finger563/agse2015/design/FRR/pictures/IMAG0127.jpg

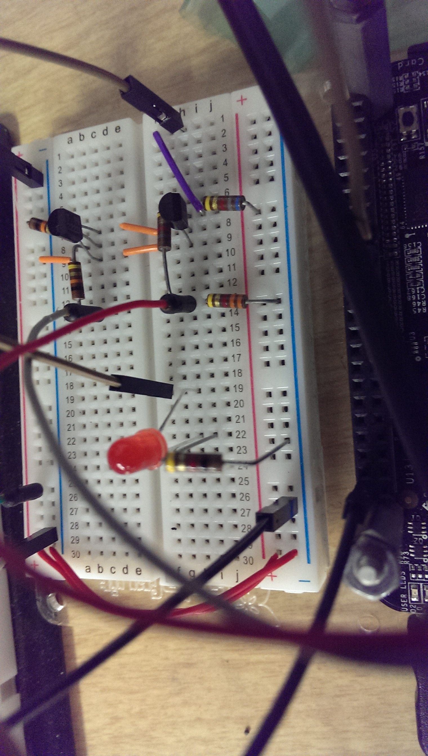
design/FRR/pictures/IMAG0127.jpg
