finger563/agse2015/design/FRR/pictures/pcb_bottom_comparison.png

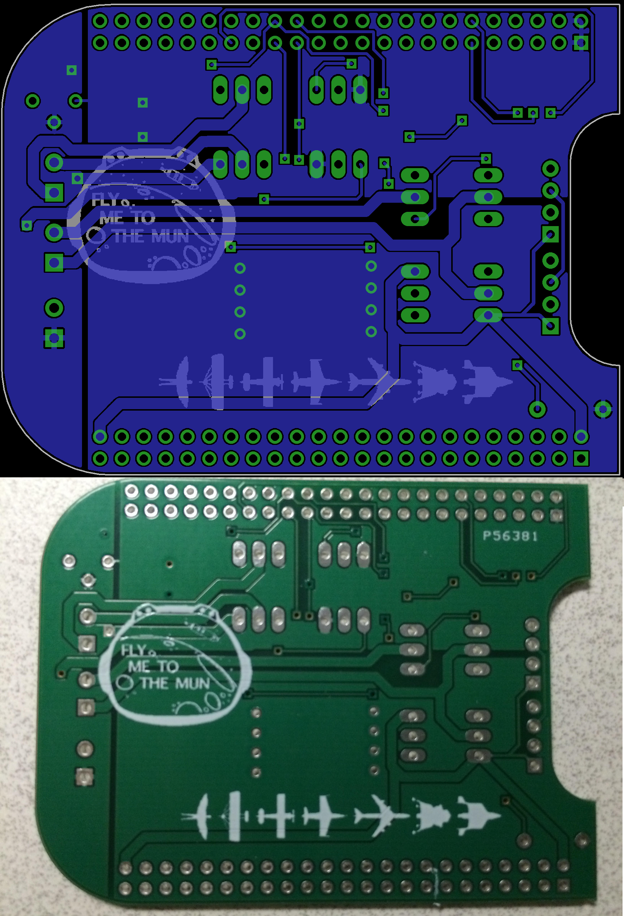
design/FRR/pictures/pcb_bottom_comparison.png
