finger563/agse2015/README.md

View this project on [CADLAB.io](https://cadlab.io/node/972). 

agse2015
========

This repository contains the design and implementation for the AGSE subsystem for the VAC 2015 year.
