finger563/agse2015/design/statechart/agse_design_statechart.pptx

state: ACTIVE

state: Init
The system is performing a checklist of tests to confirm the operational integrity of the sub-system components. Some of these tests are bypassed when resuming from a paused state.

Init_Test_Results = true

state: Scan
Camera feed is processed at a stable sampling rate to identify the payload bay compartment.

state: Retrieve_Sample

Refine_Metrics

state: Plan/Look-ahead/Move
Using the relative position and orientation of the sample, the arm plans a move towards the sample, instructing the motors with relevant signals

state: PickUp
Use the gripper servo to:
- Appropriately orient the gripper relative to sample.
- Pick up sample & verify.

Reached_Sample

state: Close_Bay
Once the sample is dropped, move the arm away from the rocket and trigger the bay-closing circuitry.

state: Open_Bay
Use proximity to open the payload bay, preparing it for sample retrieval.

!Has_Sample && Reached_Bay

Opened_Bay

state: Scan
Camera feed is processed to identify the sample on the ground

Found_Sample

state: Goto_Payload_Bay

state: Plan/Look-ahead/Move
Using the relative position and orientation of the bay, the arm plans a move towards the bay, instructing the motors with relevant signals.

state: POWER_OFF
The system is in the OFF state. There is no current flowing through the circuitry and there are no moving parts.

Refine_Metrics

state: Drop_Sample
Use the gripper servos to orient gripper relative to the payload bay and move to a minimum safe distance. Once a critical distance is reached and detected, drop and secure the sample in bay.

state: PAUSED
The system is in a paused, suspended state. Variables in memory retain consistent state so that the system can readily go to ACTIVE.

Has_Sample

Found_Bay

Has_Sample && Reached_Bay

Dropped_Sample

RESUME

PowerON

PowerOFF

PAUSE

START

PowerOFF

## Slide 2

state: POWER_ON

state: Opened_Bay

state: Init
This is the initialization phase of the payload bay system. This state tests the payload bay electronics and safe, timely operation.

state: Bay_Control_Failure
This is a failure state where either (1) Initializing tests fail or (2) Repeated timeout failures during bay OPEN or CLOSE operations.

Limit_Switch_1_Reached && Timeout_Expiry = false

state: Opening

state: Closing

Timeout_Expiry && Failure_Count >= 100

state: Fully_Open

AGSE_Trigger = CLOSE

Timeout_Expiry && Failure_Count < 100

Timeout_Expiry && Failure_Count < 100

AGSE_Trigger = OPEN

Init_Tests = false

Limit_Switch_2_Reached

state: Closed_Bay
The Payload bay is completely closed. This state is reached when either (1) the sample is retrieved by the AGSE and secured in the bay or (2) the bay is closed after successful initialization.

Init_Tests = true

state: POWER_OFF
The system is in the OFF state. There is no current flowing through the circuitry and there are no moving parts.

PowerOFF

PowerON
