finger563/agse2015/design/powerBoM.xlsx

12V Output DC/DC Converter | http://www.mouser.com/ProductDetail/GE-Critical-Power/EHHD010A0B41-HZ/ | http://www.mouser.com/ProductDetail/GE-Critical-Power/KBVW006A0B41Z/ | http://www.mouser.com/ProductDetail/Delta-Electronics-Power/E48SC12008NRFA/ | http://www.mouser.com/ProductDetail/Murata-Power-Solutions/ULS-12-83-D48N-C/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 | http://www.mouser.com/ProductDetail/Delta-Electronics-Power/E48SH12010NRFA/ | http://www.mouser.com/ProductDetail/Murata-Power-Solutions/UWE-12-10-Q48N-C/ | http://www.mouser.com/ProductDetail/Delta-Electronics-Power/E36SC12009NRFA/
Price | $37.37 | $30.40 | $32.23 | $36.75 | $42.42 | $44.50 | $59.11
5V Output (12V in) DC/DC Converter | http://www.mouser.com/ProductDetail/Delta-Electronics-Power/DNT12S0A0S05NFA/ | http://www.mouser.com/ProductDetail/Delta-Electronics-Power/NE12S0A0V10PNFA/ | http://www.mouser.com/ProductDetail/Delta-Electronics-Power/DNM10S0A0R10NFD/ | http://www.mouser.com/ProductDetail/Maxim-Integrated/MAX16907SAUE-V+/
Price | $8.49 | $11.22 | $12.11 | 6.26
Batteries | http://www.mouser.com/ProductDetail/Power-Sonic/PS-1250F2/ | http://www.mouser.com/ProductDetail/Power-Sonic/PS-1250F1/ | http://www.mouser.com/ProductDetail/Power-Sonic/PSH-1255F2-FR/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
Price | $20.70 | $19.71 | $21.05
Note: | 12V, we'd need 3 probably | 12V, we'd need 3 probably | 12V, we'd need 3 probably
Resettable Fuses | http://www.mouser.com/ProductDetail/Schurter/PFRA500/ | http://www.mouser.com/ProductDetail/TE-Connectivity-Raychem/RGEF500K/ | http://www.mouser.com/ProductDetail/TE-Connectivity-Raychem/RUEF500-2/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
Price | $0.60 | $0.51 | $0.56
ACTUALLY BOUGHT: | 12V DC/DC Converter | Batteries | Wire
 | http://www.mouser.com/ProductDetail/Mean-Well/RSD-100B-12/?qs=sGAEpiMZZMvGsmoEFRKS8P9bZCysYvvSGN8daVBtngg%3d | http://www.mouser.com/ProductDetail/Power-Sonic/PS-12120F2/?qs=sGAEpiMZZMuXcNZ31nzYhWCg8Aa0ccFGvNDs0yXFGmM%3d | http://www.mouser.com/ProductDetail/Alpha-Wire/6459-OR005/
 |  |  | http://www.mouser.com/ProductDetail/Alpha-Wire/6459-OR005/
