finger563/agse2015/code/agse_rosmod_v3/agse_emacs.png

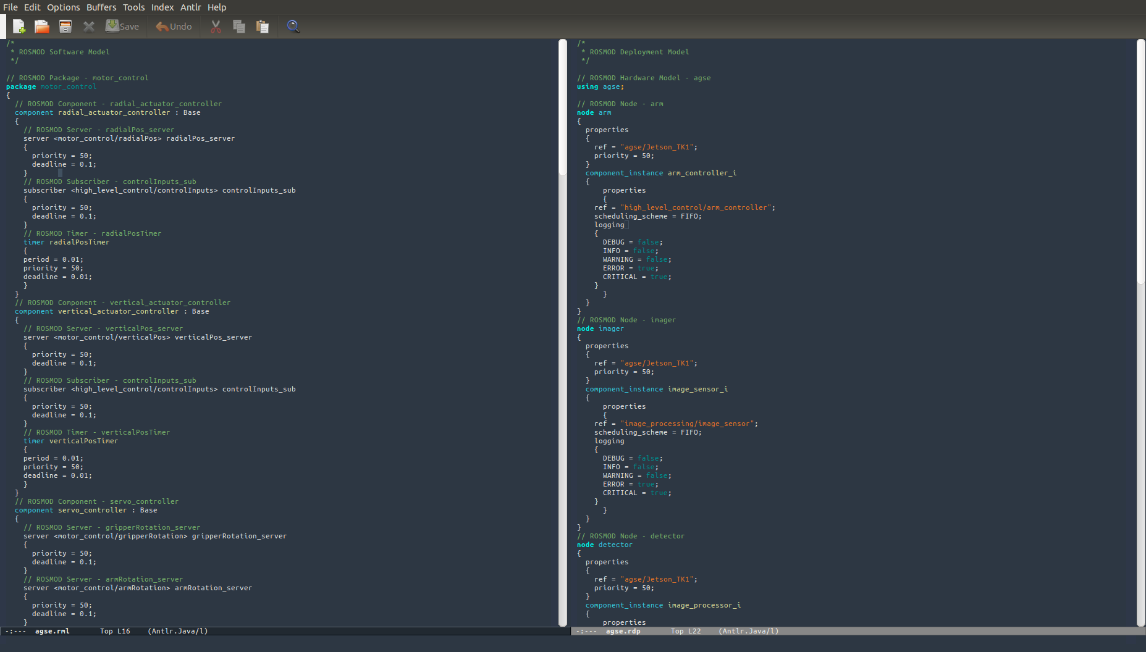
code/agse_rosmod_v3/agse_emacs.png
