finger563/agse2015/code/agse_rosmod_v3/deployment.png

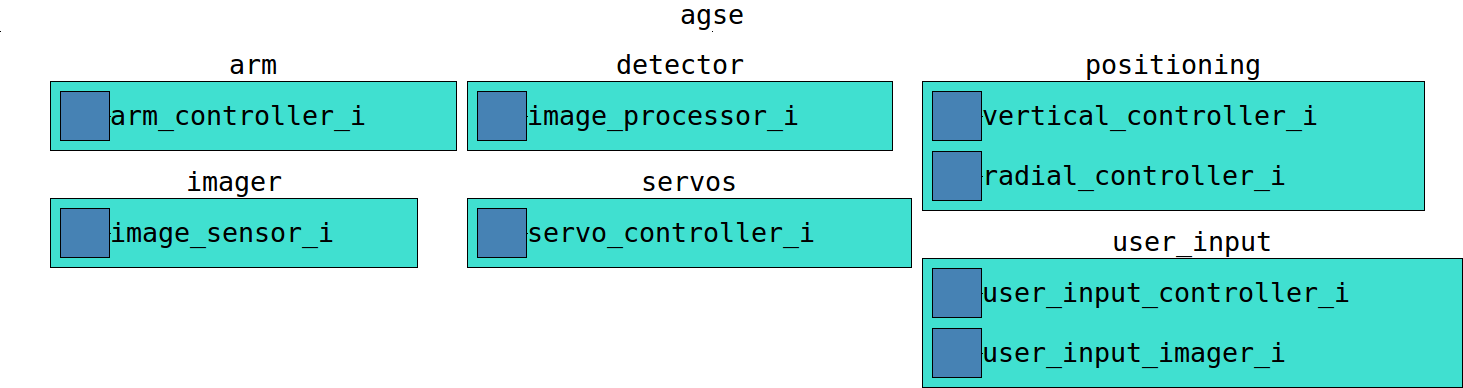
code/agse_rosmod_v3/deployment.png
