finger563/agse2015/code/agse_rosmod_v3/high_level_control_tree.png

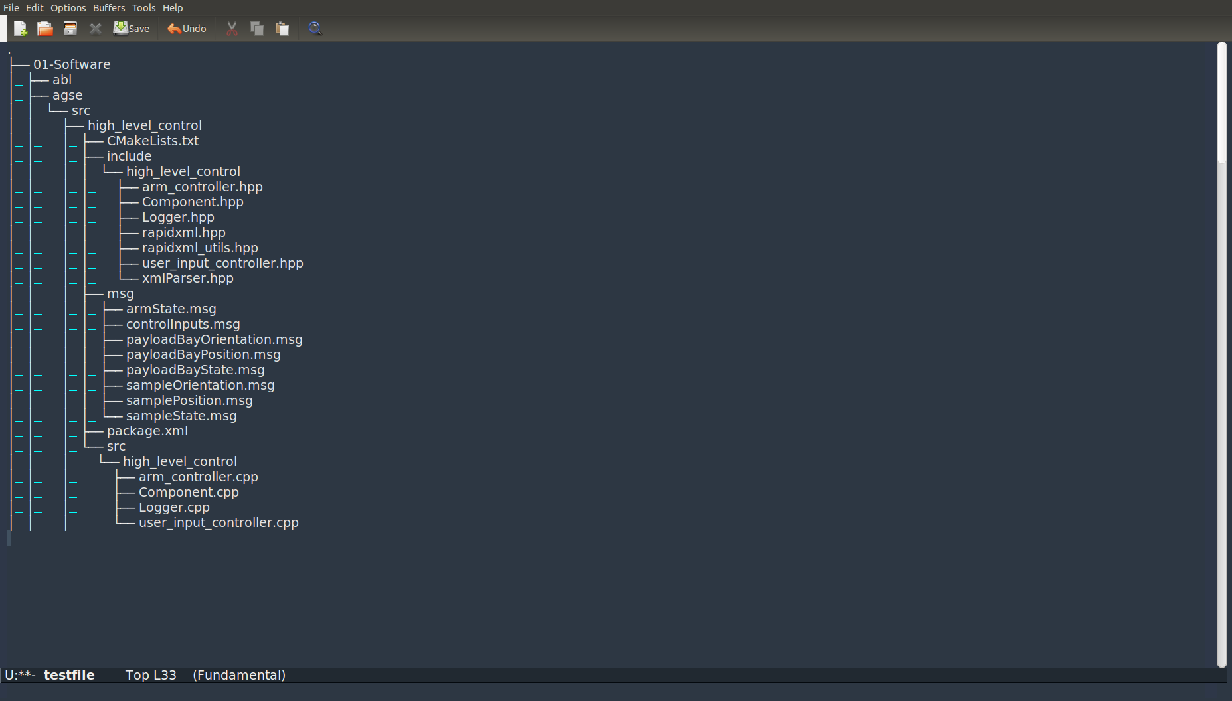
code/agse_rosmod_v3/high_level_control_tree.png
