finger563/agse2015/code/agse_rosmod_v3/image_processing_pacakge.png

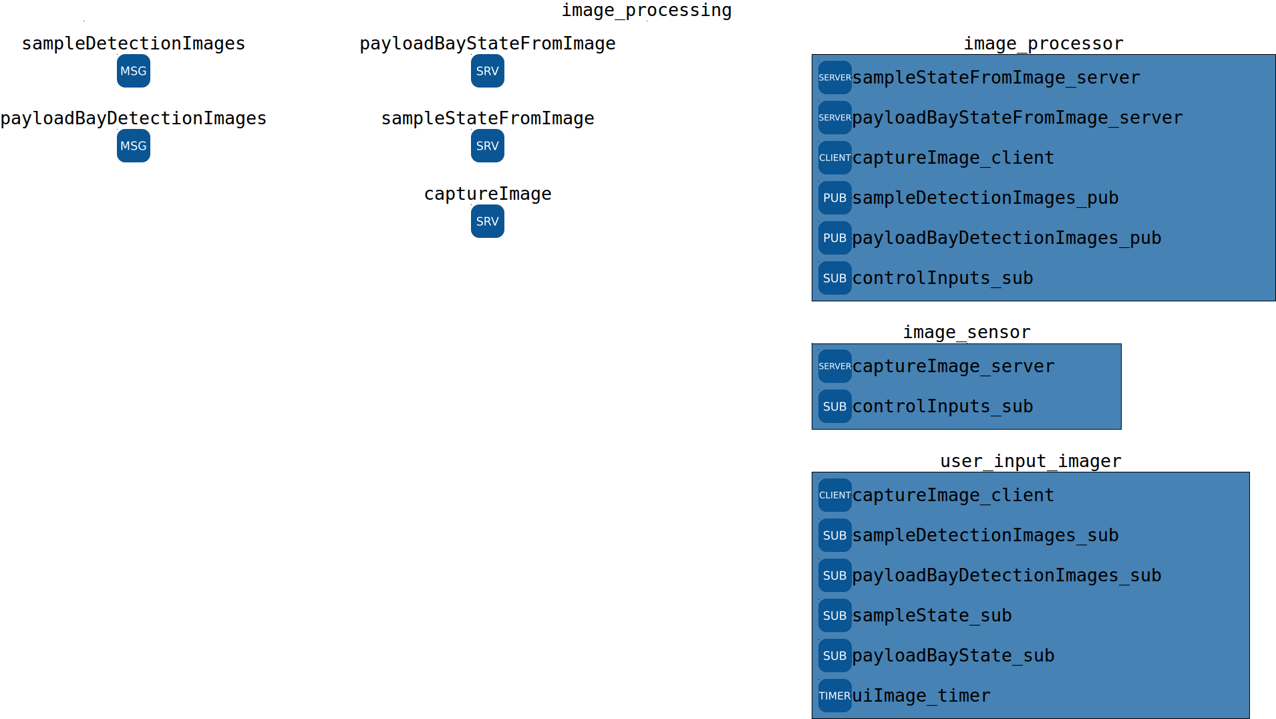
code/agse_rosmod_v3/image_processing_pacakge.png
