finger563/agse2015/code/agse_rosmod_v3/motor_control_pacakge.png

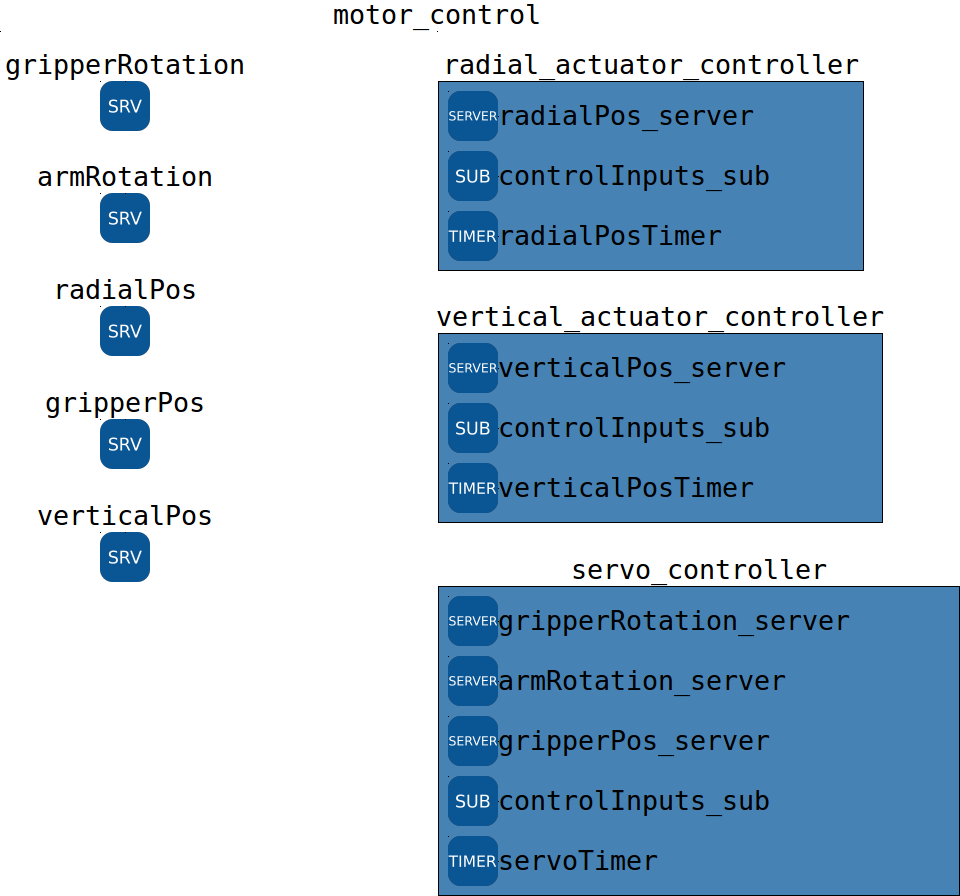
code/agse_rosmod_v3/motor_control_pacakge.png
