finger563/agse2015/code/agse_rosmod_v3/rosmod_editor.png

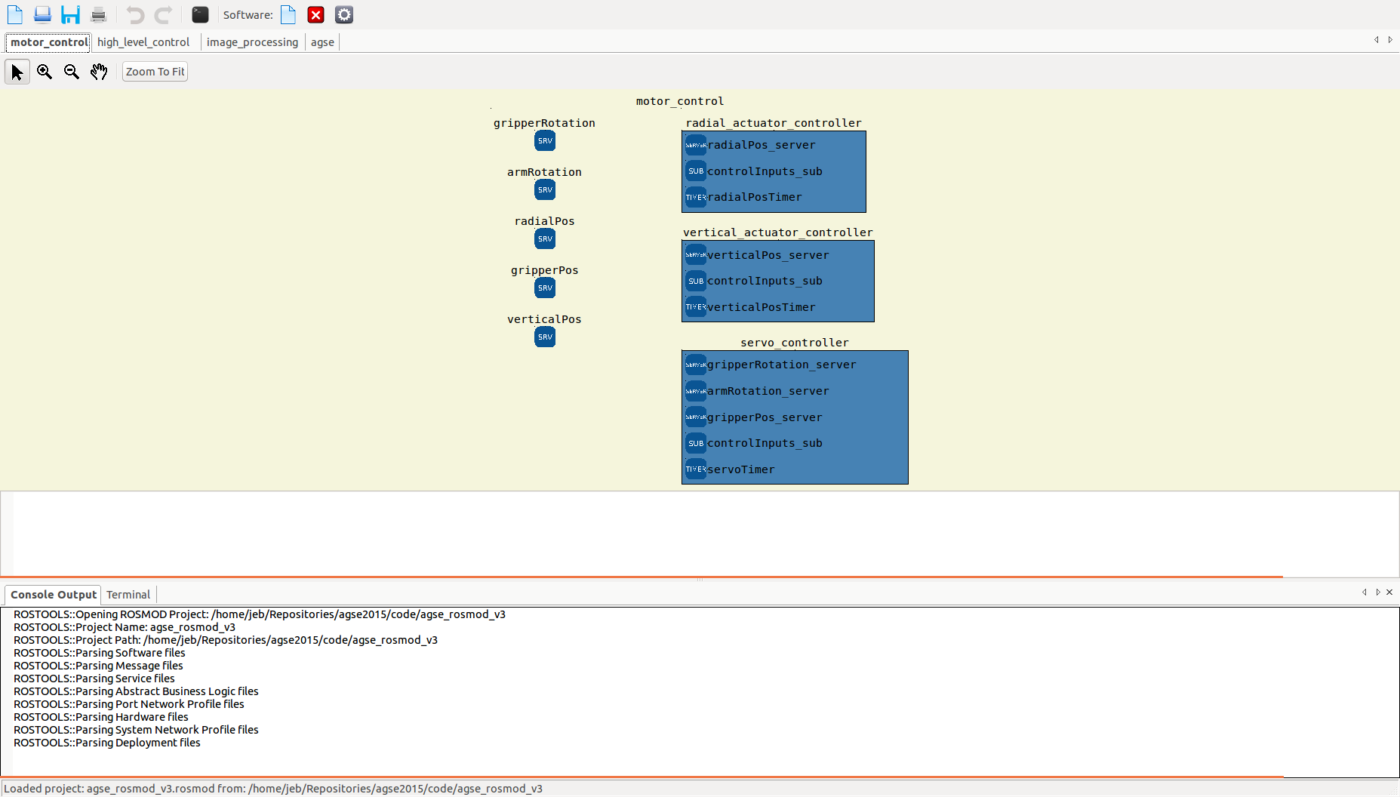
code/agse_rosmod_v3/rosmod_editor.png
