finger563/agse2015/code/agse_rosmod_v3/tree.png

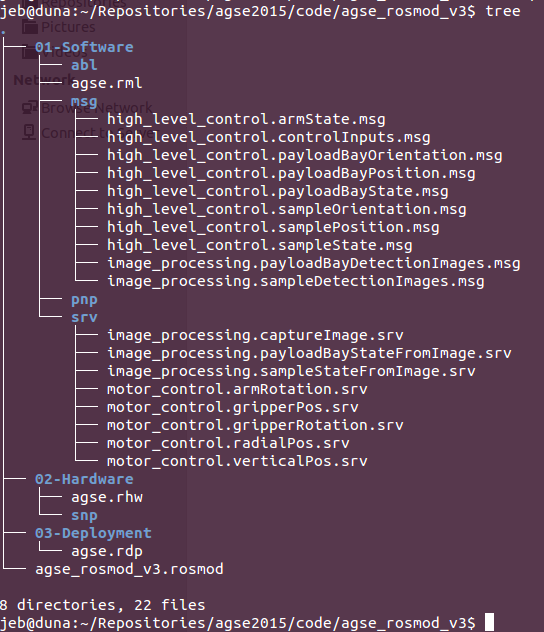
code/agse_rosmod_v3/tree.png
