finger563/agse2015/code/UIP/input/01.png

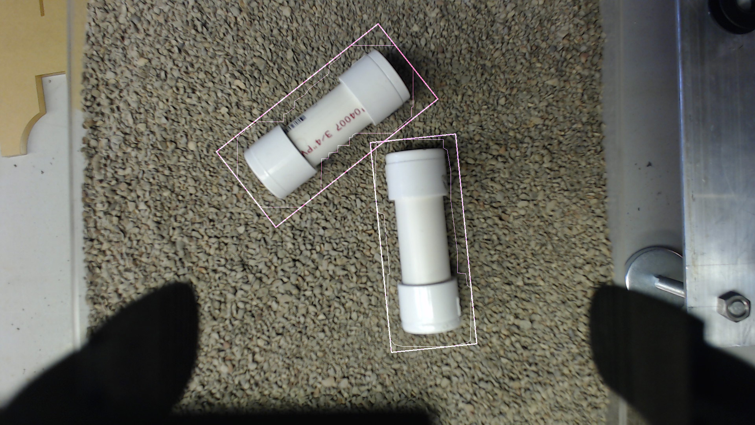
code/UIP/input/01.png
