finger563/agse2015/code/UIP/input/03.png

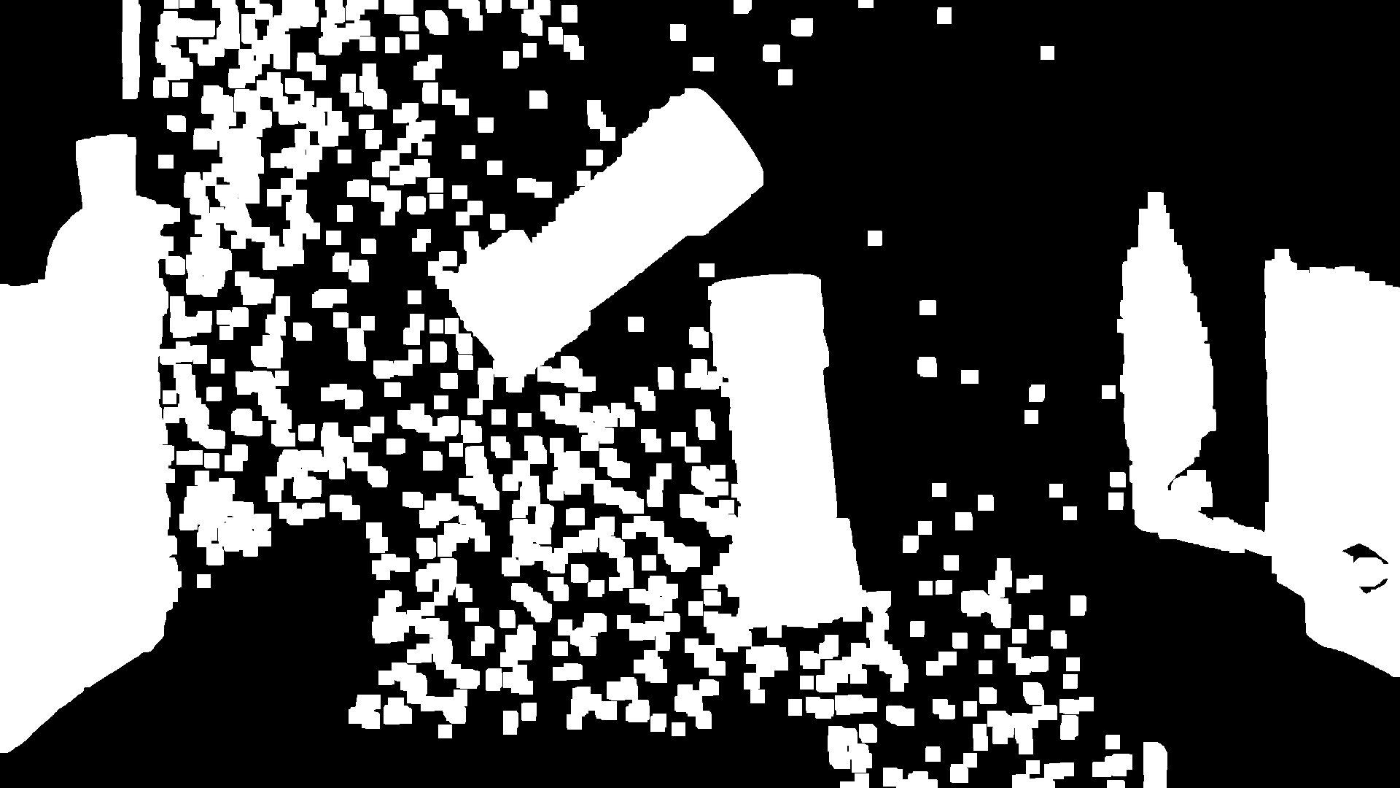
code/UIP/input/03.png
