finger563/agse2015/code/UIP/input/m4.png

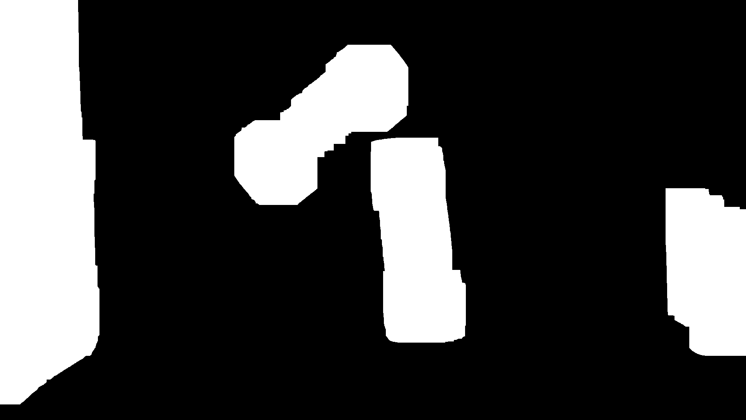
code/UIP/input/m4.png
