finger563/agse2015/design/FRR/BBBCape/IMAG0193.jpg

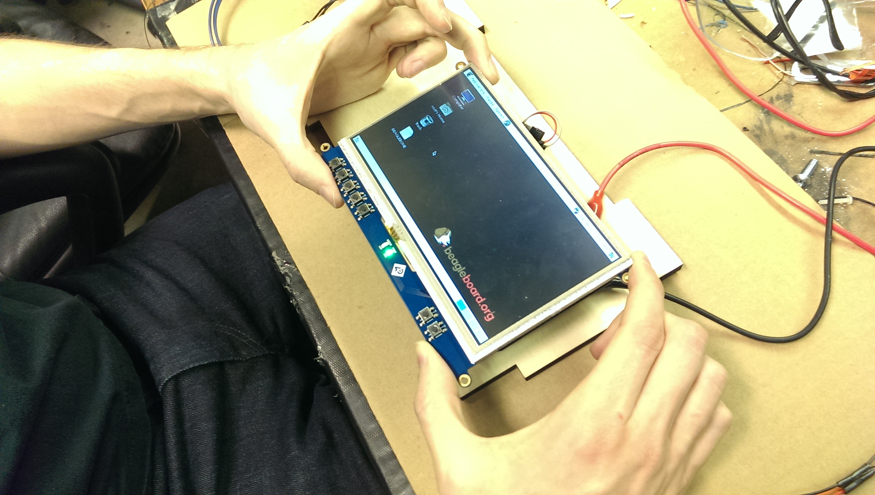
design/FRR/BBBCape/IMAG0193.jpg
