finger563/agse2015/design/FRR/BBBCape/IMAG0194.jpg

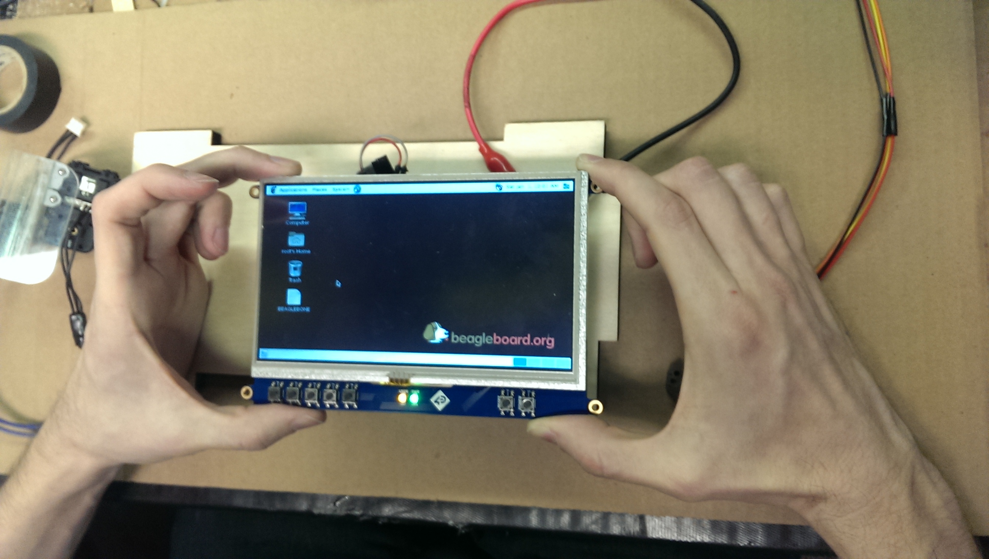
design/FRR/BBBCape/IMAG0194.jpg
