finger563/agse2015/design/FRR/BBBCape/IMAG0195.jpg

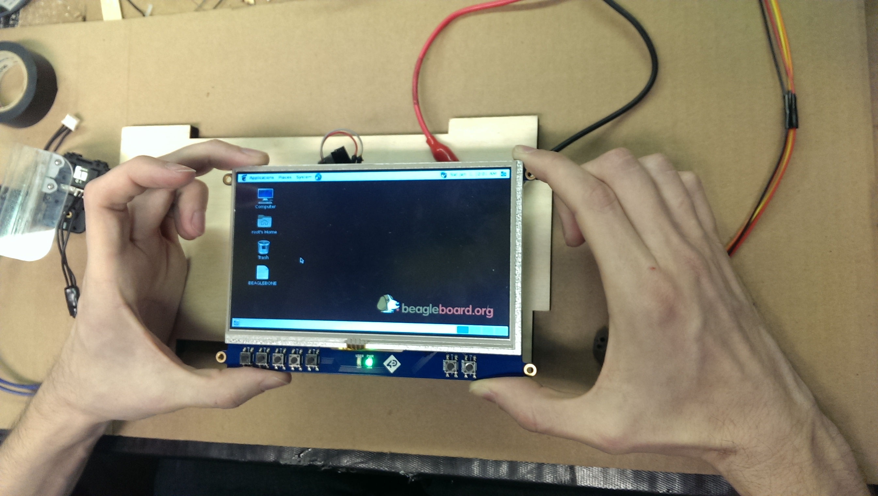
design/FRR/BBBCape/IMAG0195.jpg
