finger563/agse2015/design/FRR/BBBCape/IMAG0196.jpg

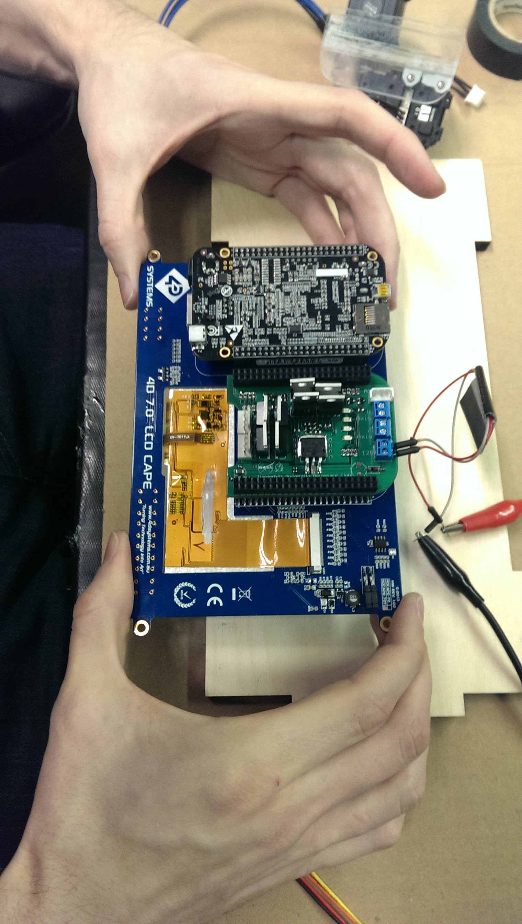
design/FRR/BBBCape/IMAG0196.jpg
