finger563/agse2015/design/FRR/BBBCape/IMAG0197.jpg

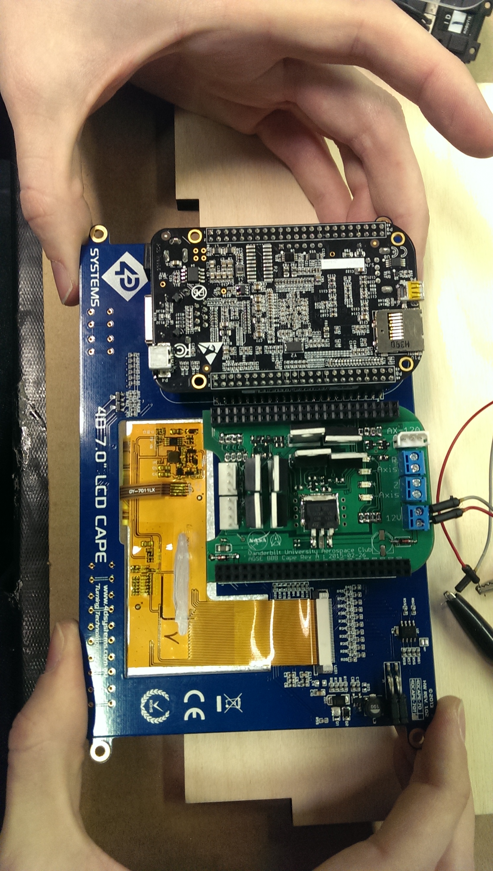
design/FRR/BBBCape/IMAG0197.jpg
