finger563/agse2015/design/FRR/BBBCape/IMAG0198.jpg

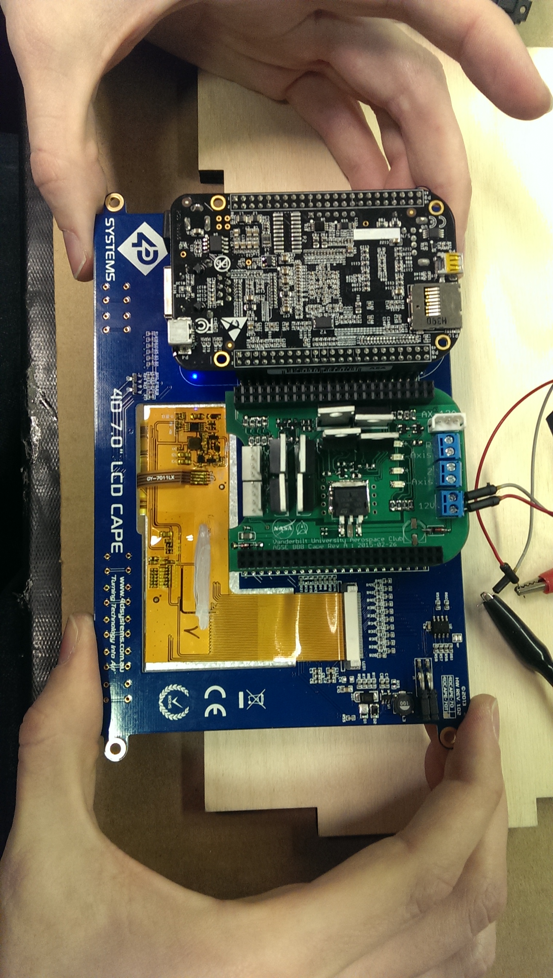
design/FRR/BBBCape/IMAG0198.jpg
