finger563/agse2015/design/FRR/MBA-Demo-SampleDetection/Sample-01-Raw.png

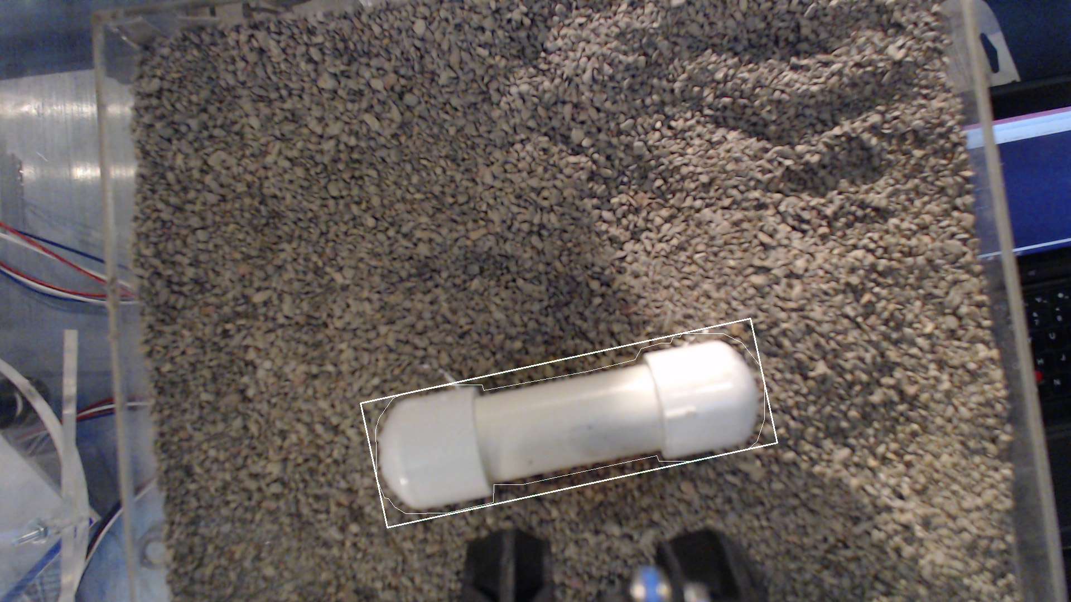
design/FRR/MBA-Demo-SampleDetection/Sample-01-Raw.png
