finger563/agse2015/design/FRR/MBA-Demo-SampleDetection/Sample-05-Grayscale-Threshold.png

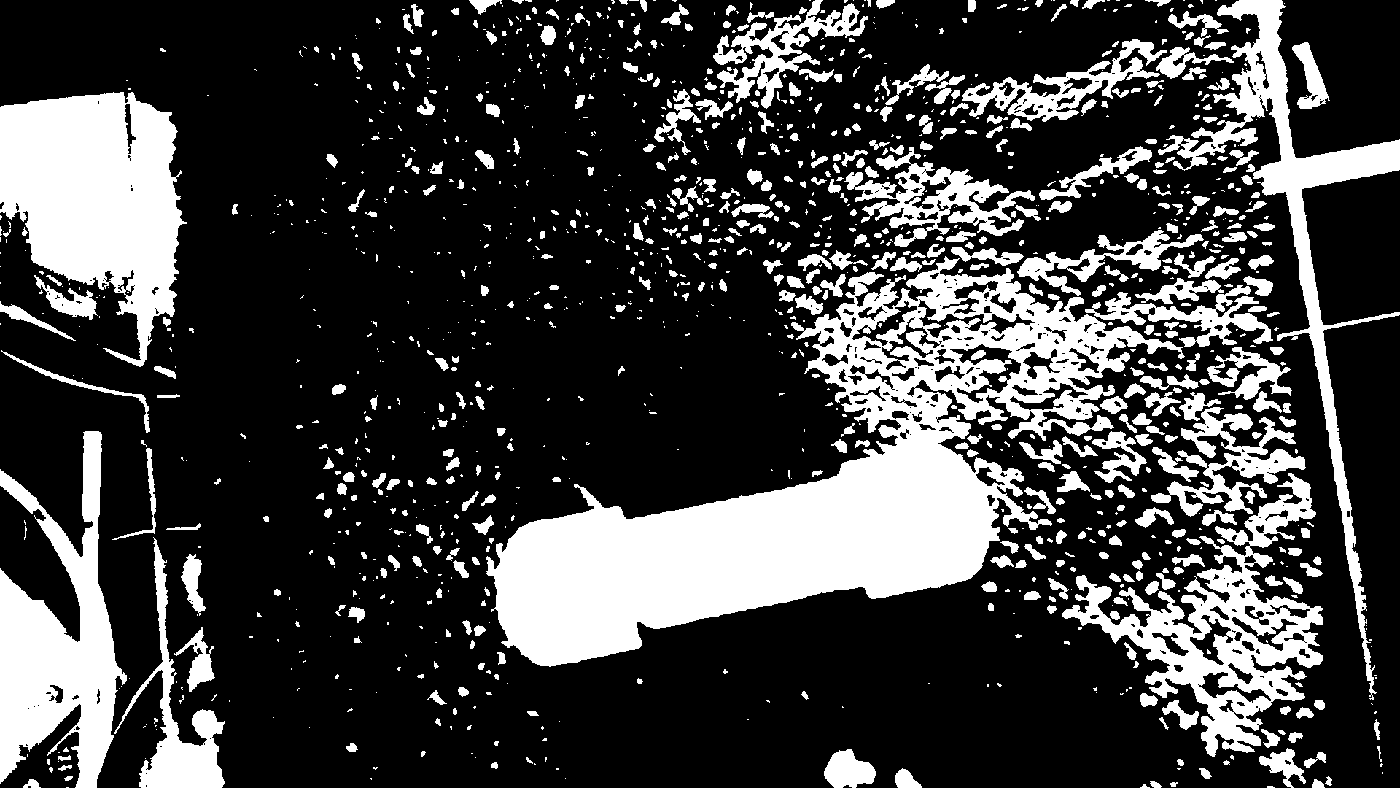
design/FRR/MBA-Demo-SampleDetection/Sample-05-Grayscale-Threshold.png
