finger563/agse2015/design/FRR/MBA-Demo-SampleDetection/Sample-06-Grayscale-Filtered.png

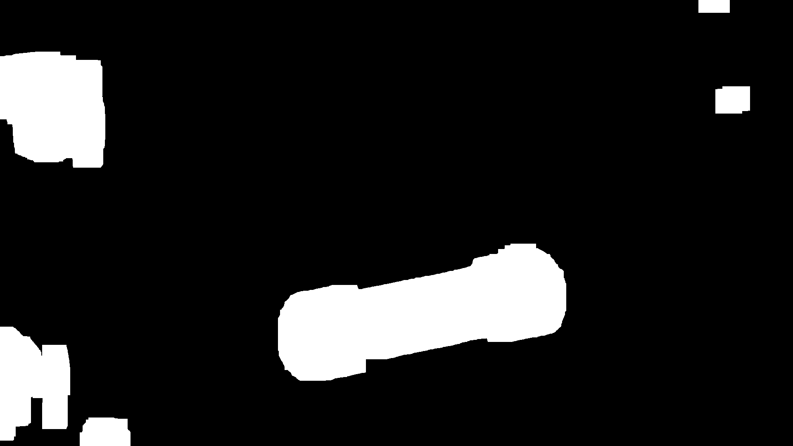
design/FRR/MBA-Demo-SampleDetection/Sample-06-Grayscale-Filtered.png
