finger563/agse2015/design/FRR/MBA-Demo-SampleDetection/Sample-08-Bitwise-AND-Tracked.png

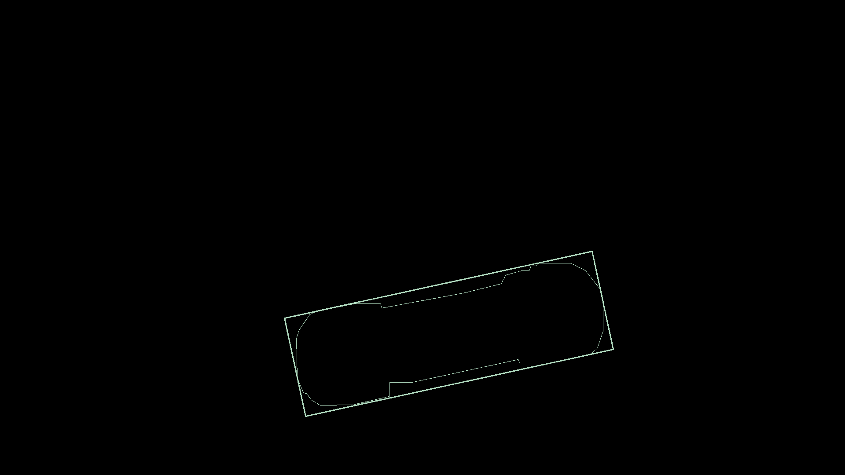
design/FRR/MBA-Demo-SampleDetection/Sample-08-Bitwise-AND-Tracked.png
