finger563/agse2015/design/FRR/MBA-Demo-SampleDetection/Sample-YCrCb-Threshold.png

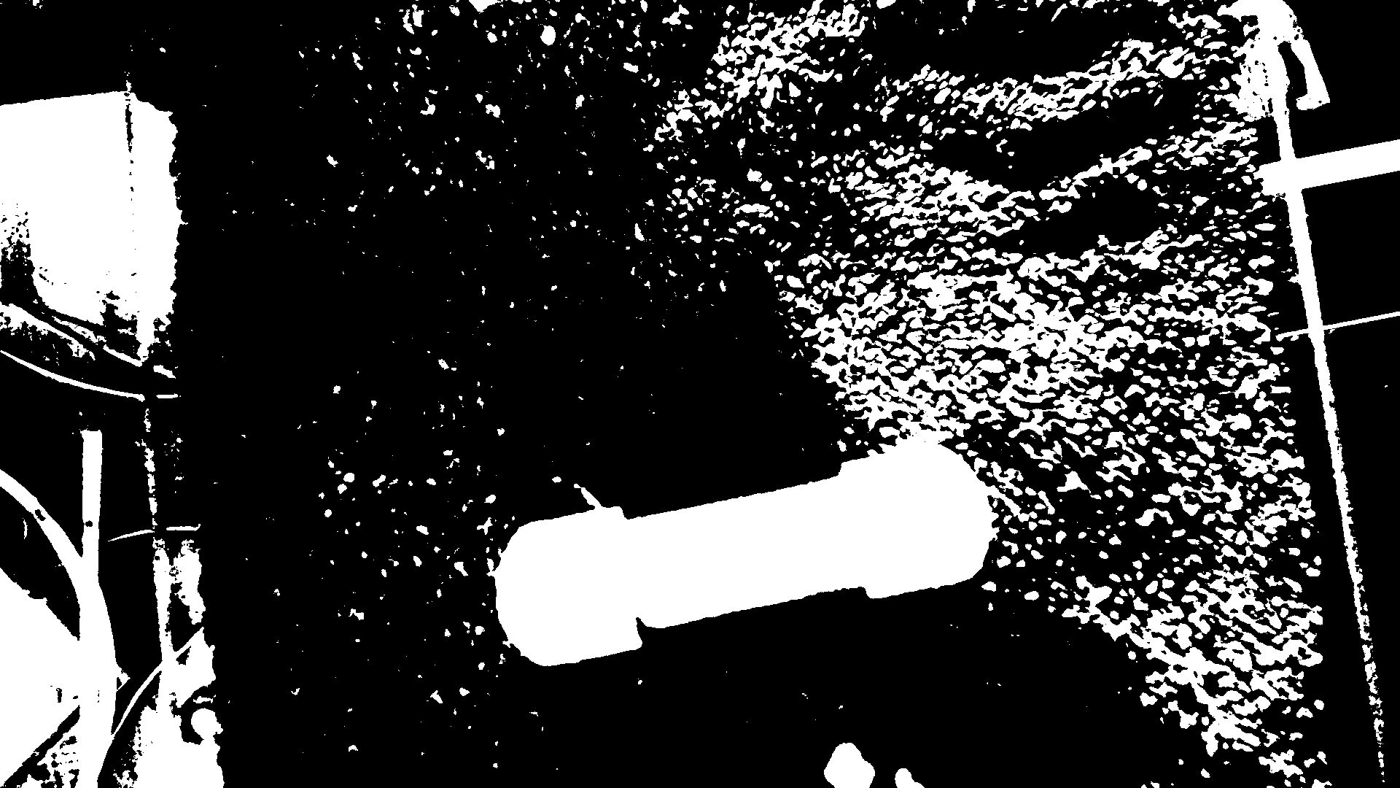
design/FRR/MBA-Demo-SampleDetection/Sample-YCrCb-Threshold.png
