finger563/agse2015/design/FRR/pcb/IMG_0034.JPG

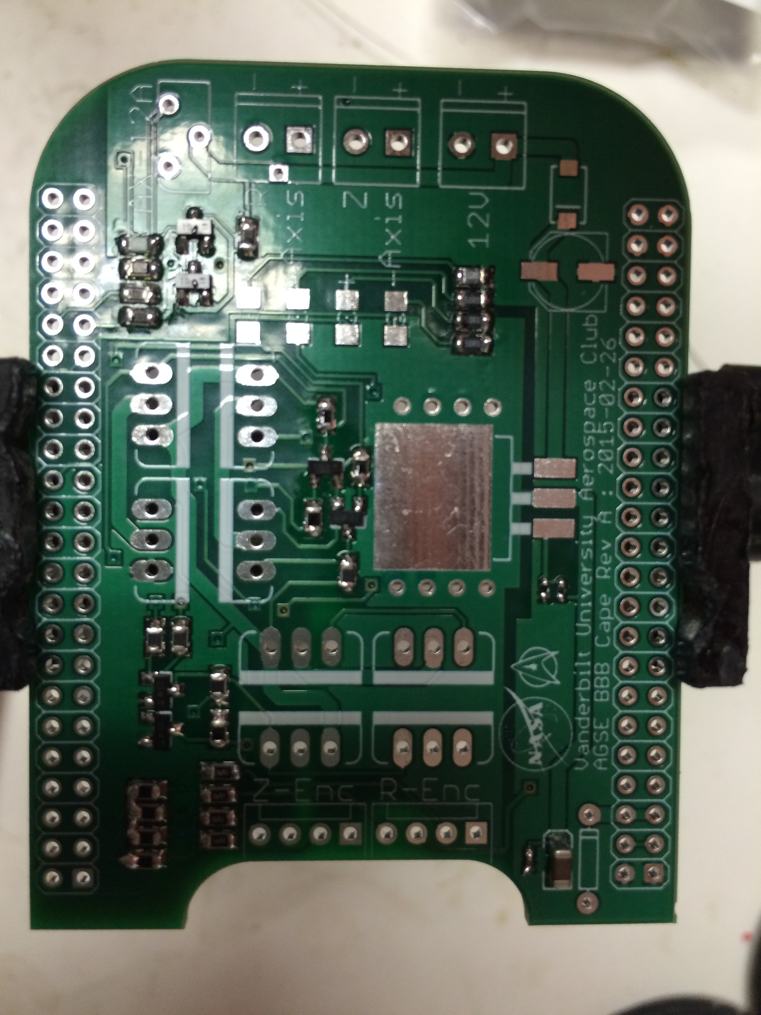
design/FRR/pcb/IMG_0034.JPG
