finger563/agse2015/design/FRR/pcb/IMG_0035.JPG

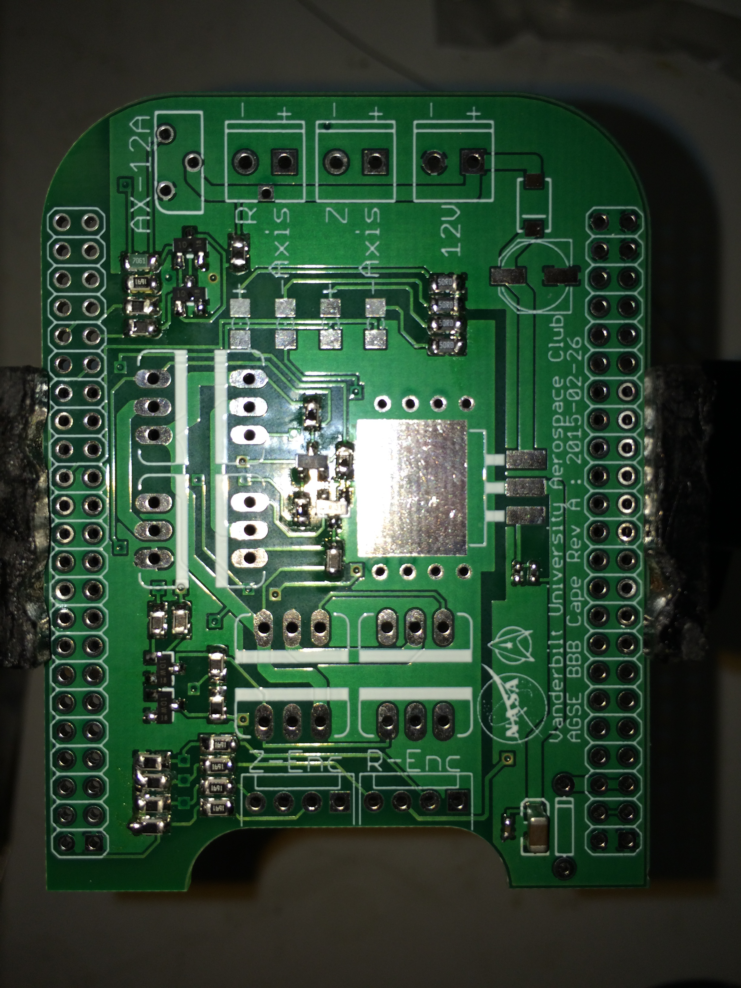
design/FRR/pcb/IMG_0035.JPG
