finger563/agse2015/design/FRR/pcb/IMG_0036.JPG

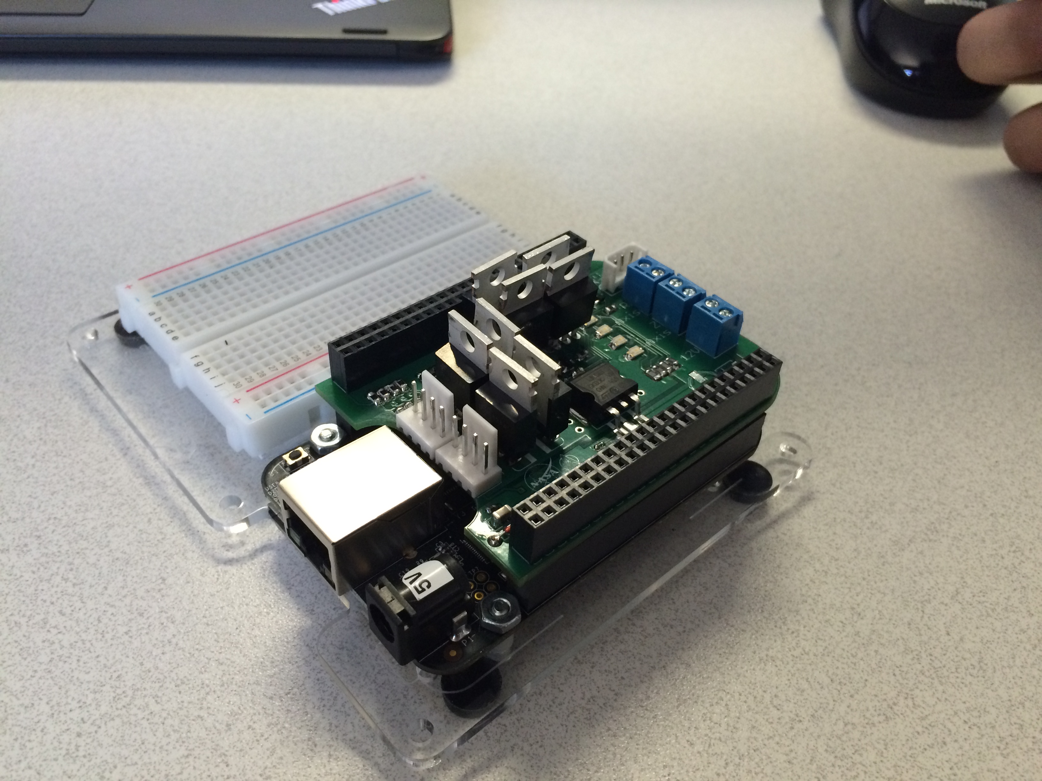
design/FRR/pcb/IMG_0036.JPG
