finger563/agse2015/design/FRR/pcb/IMG_0044.JPG

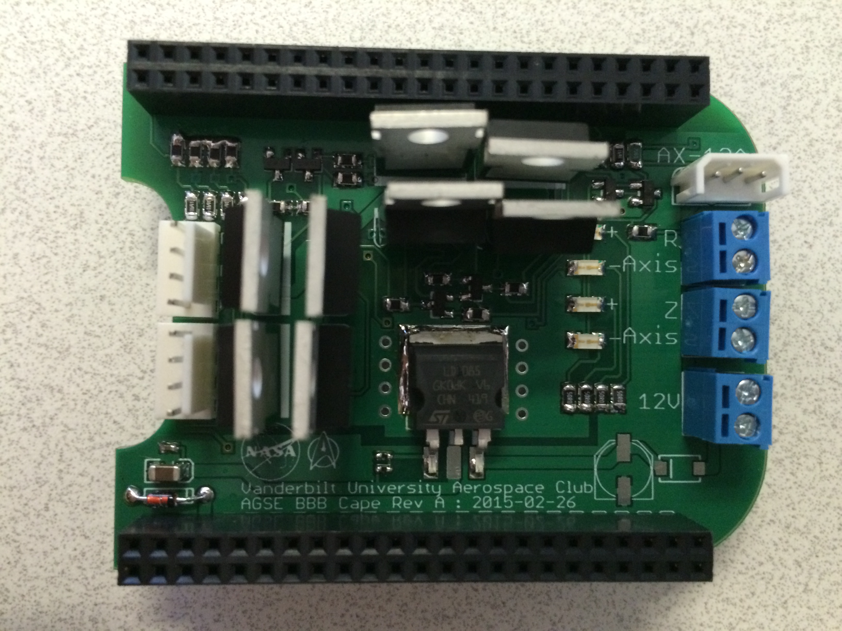
design/FRR/pcb/IMG_0044.JPG
