finger563/agse2015/design/FRR/pictures/agse_bbb_cape_layout_bottom.png

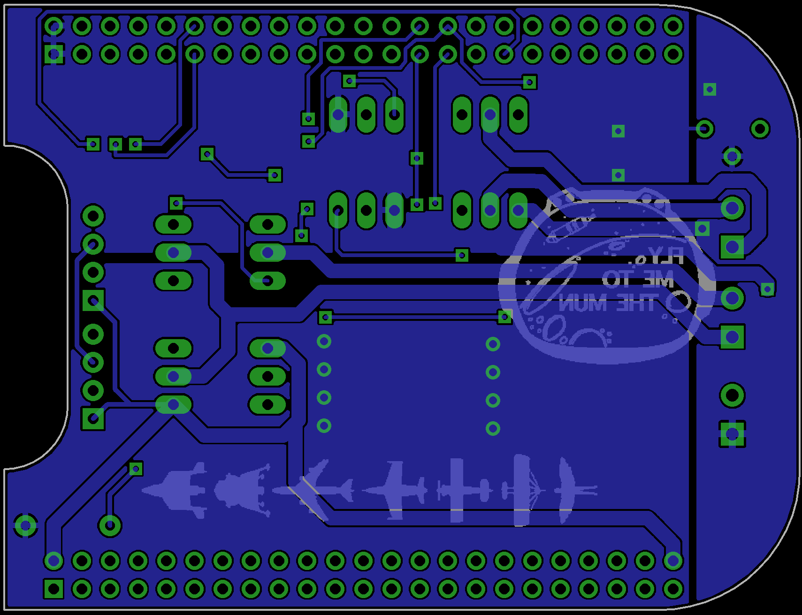
design/FRR/pictures/agse_bbb_cape_layout_bottom.png
