finger563/agse2015/design/FRR/pictures/agse_bbb_cape_layout_top.png

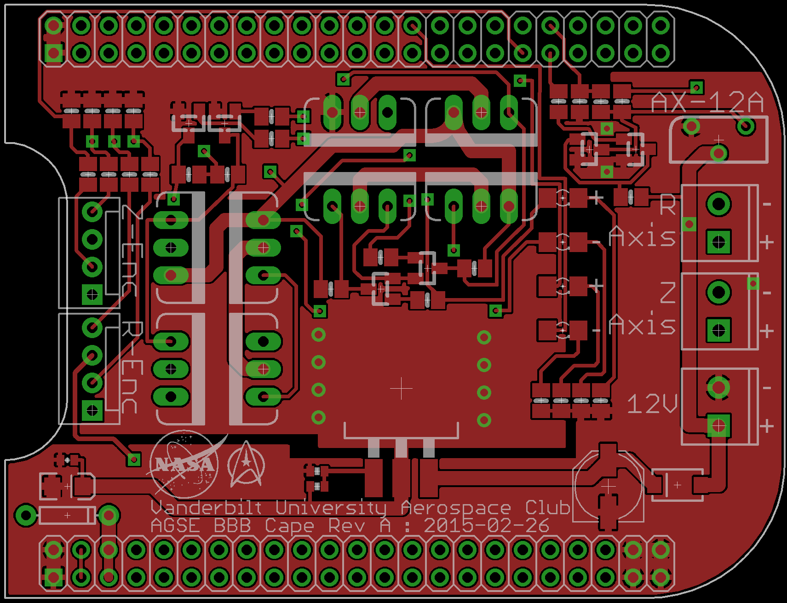
design/FRR/pictures/agse_bbb_cape_layout_top.png
