finger563/agse2015/design/FRR/pictures/agseSoftwareDesign.png

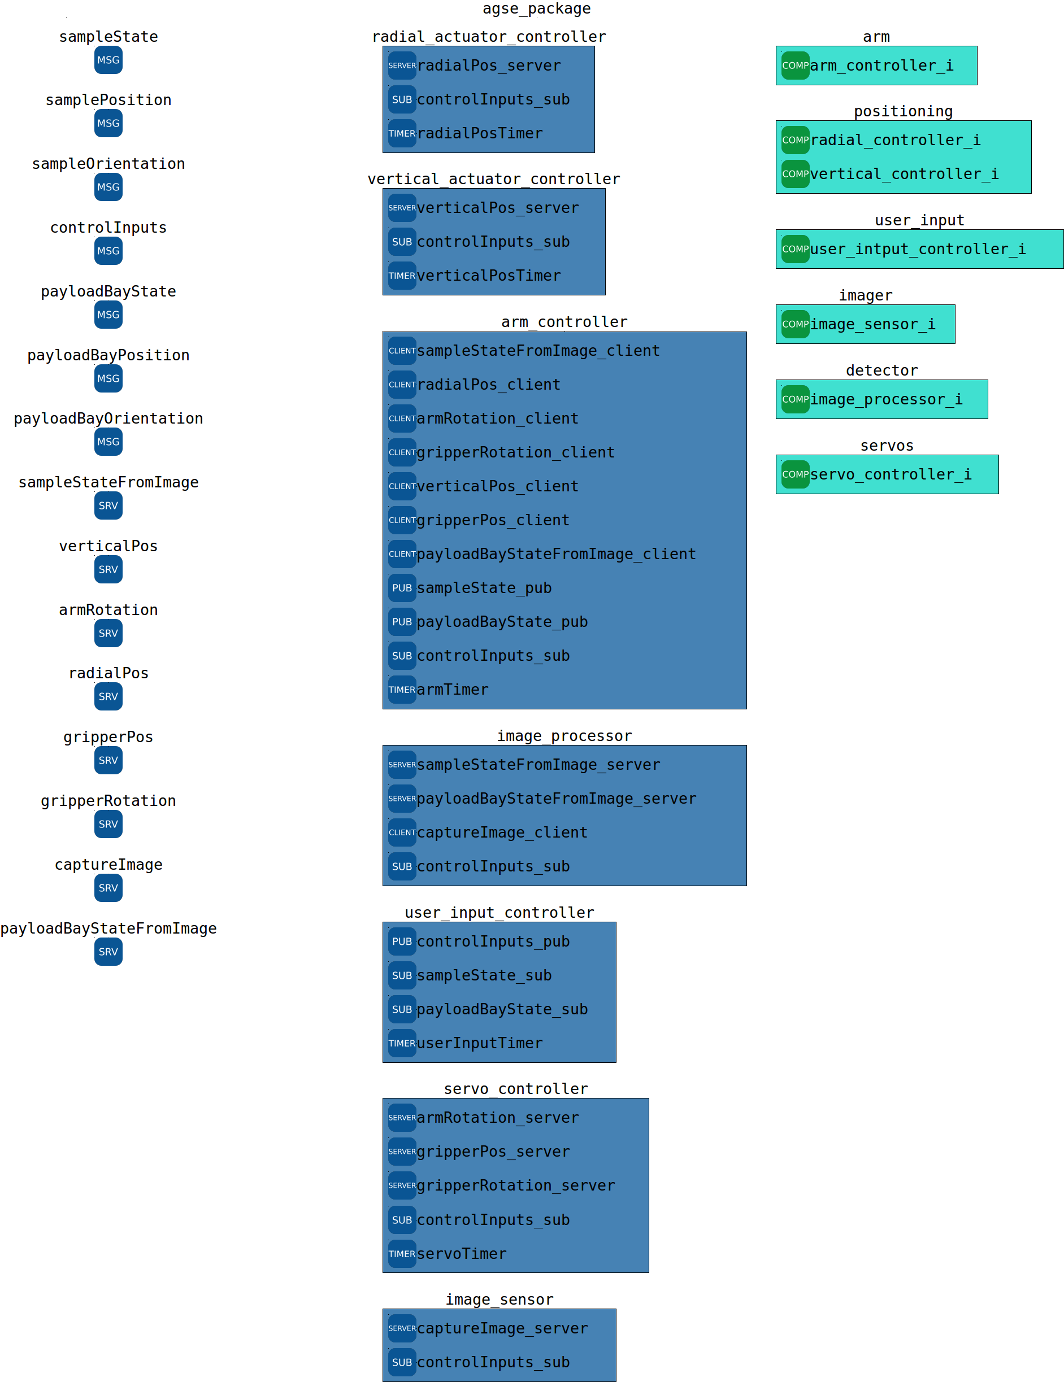
design/FRR/pictures/agseSoftwareDesign.png
