finger563/agse2015/design/FRR/pictures/breadboard1.jpg

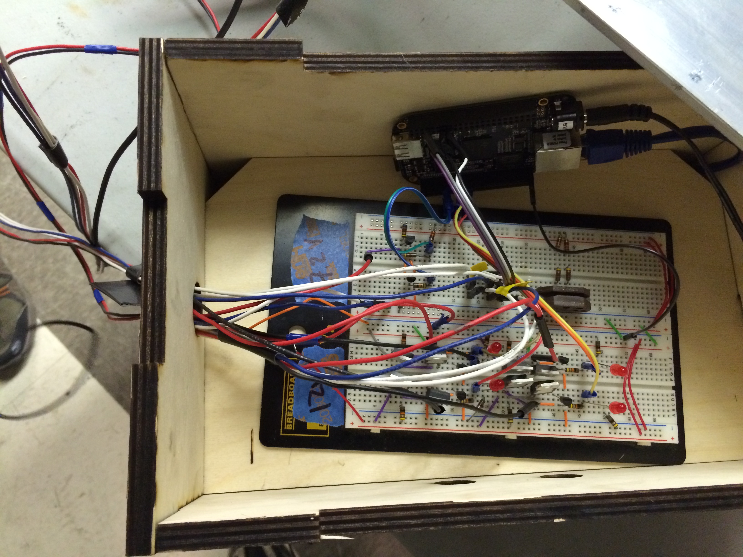
design/FRR/pictures/breadboard1.jpg
