finger563/agse2015/design/FRR/pictures/breadboard2.jpg

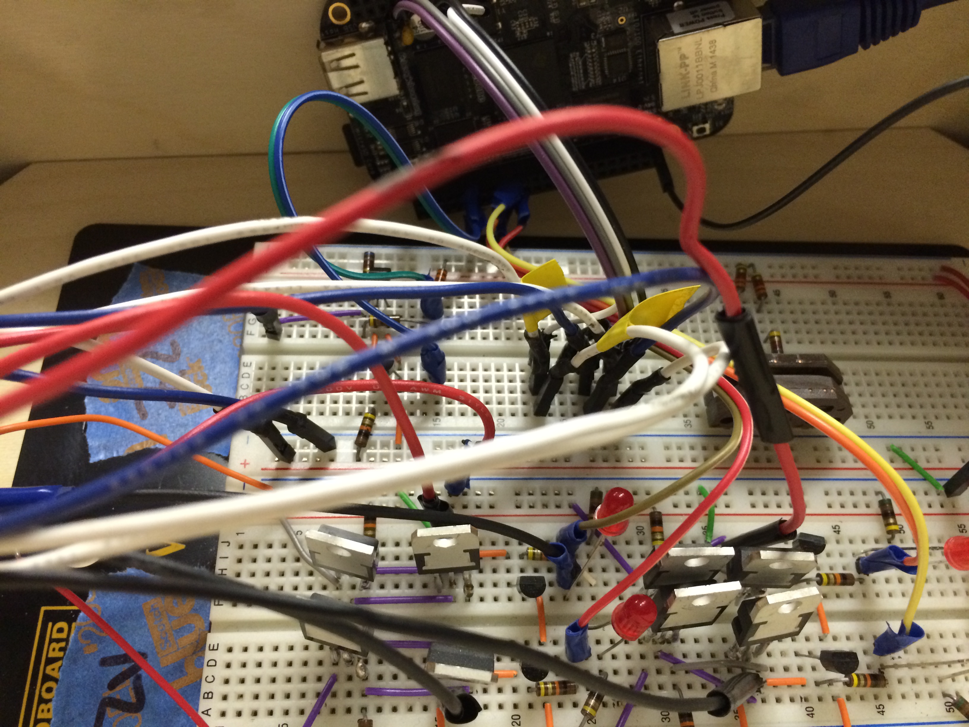
design/FRR/pictures/breadboard2.jpg
