finger563/agse2015/design/FRR/pictures/breadboard3.jpg

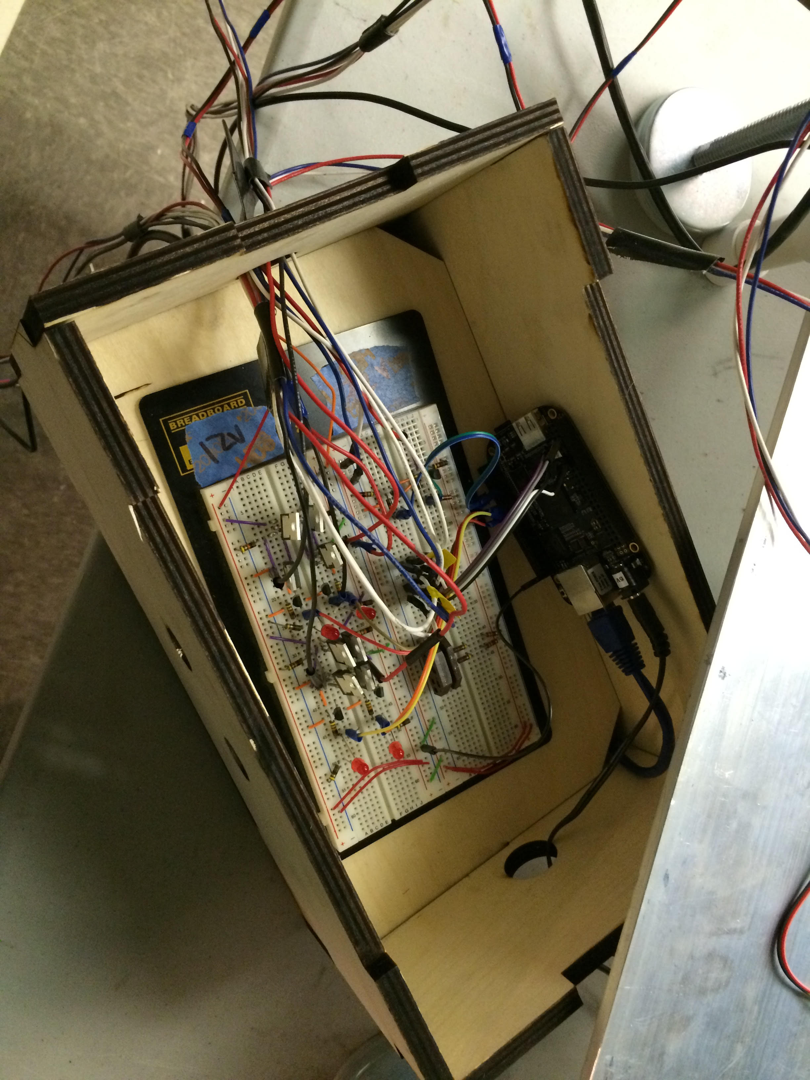
design/FRR/pictures/breadboard3.jpg
