finger563/agse2015/design/FRR/pictures/IMAG0122.jpg

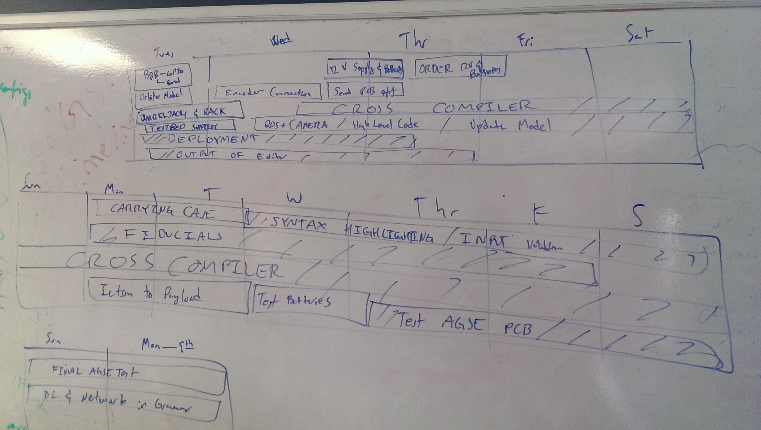
design/FRR/pictures/IMAG0122.jpg
