finger563/agse2015/design/FRR/pictures/IMAG0123.jpg

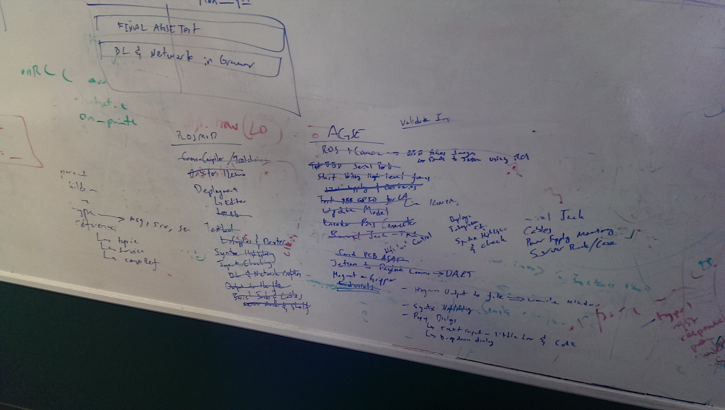
design/FRR/pictures/IMAG0123.jpg
