finger563/agse2015/design/FRR/pictures/IMAG0125.jpg

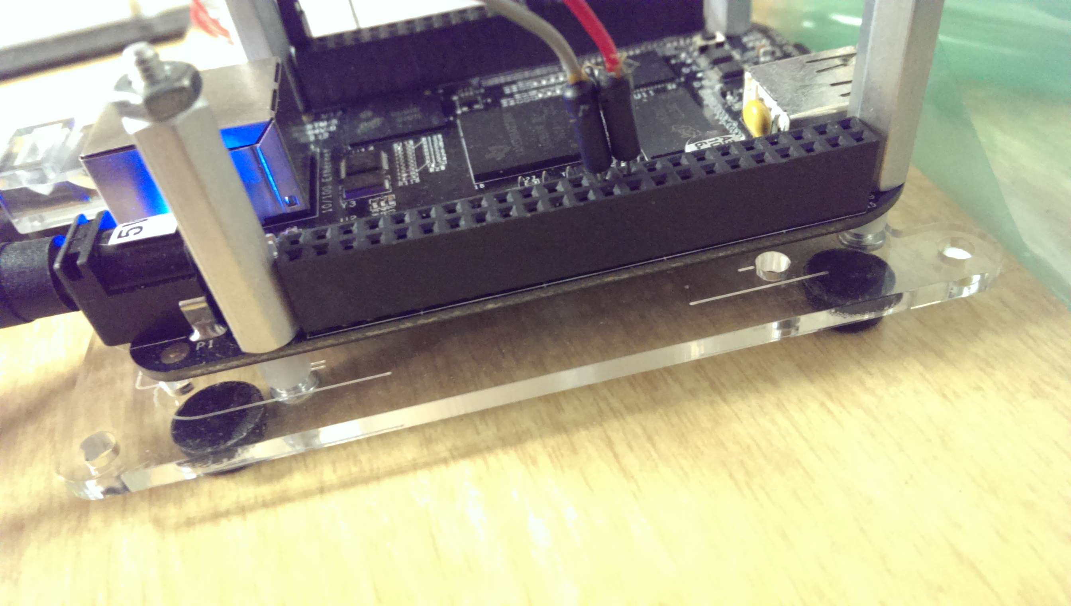
design/FRR/pictures/IMAG0125.jpg
