finger563/agse2015/design/FRR/pictures/IMAG0126.jpg

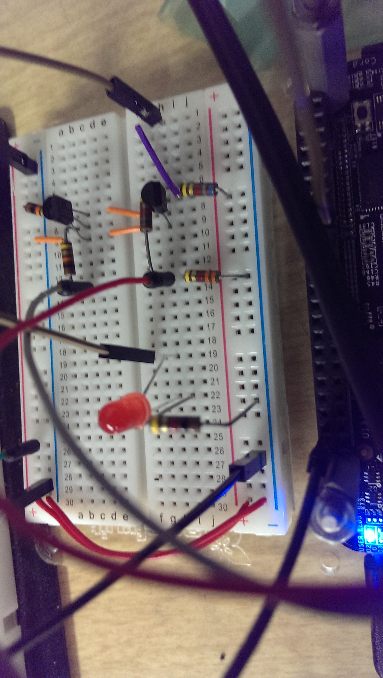
design/FRR/pictures/IMAG0126.jpg
