finger563/agse2015/design/FRR/pictures/IMAG0128.jpg

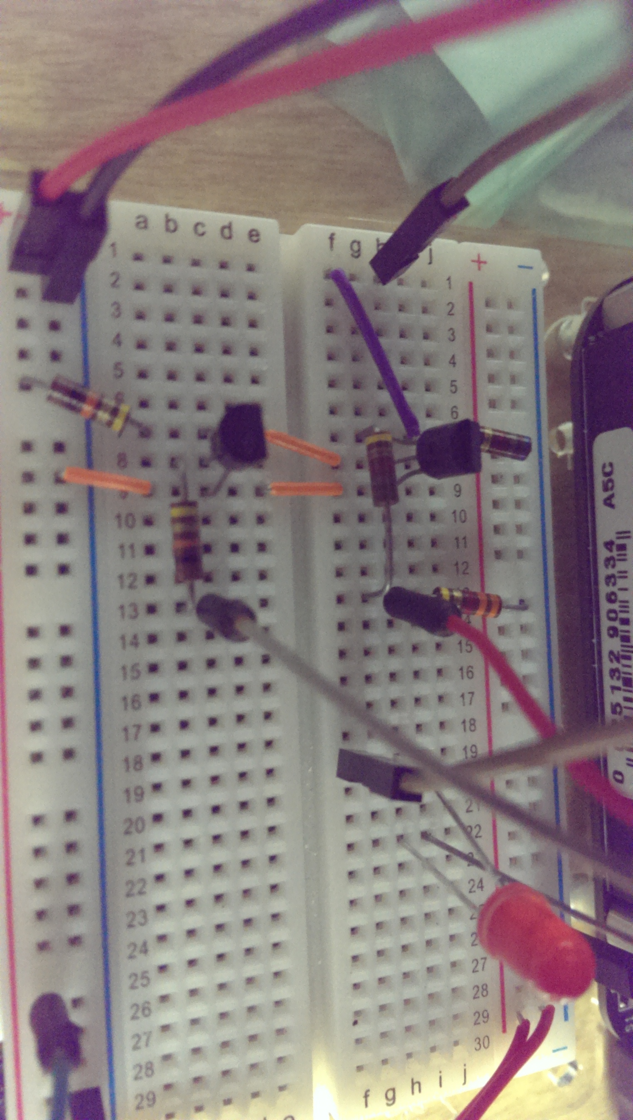
design/FRR/pictures/IMAG0128.jpg
