finger563/agse2015/design/FRR/pictures/IMAG0129.jpg

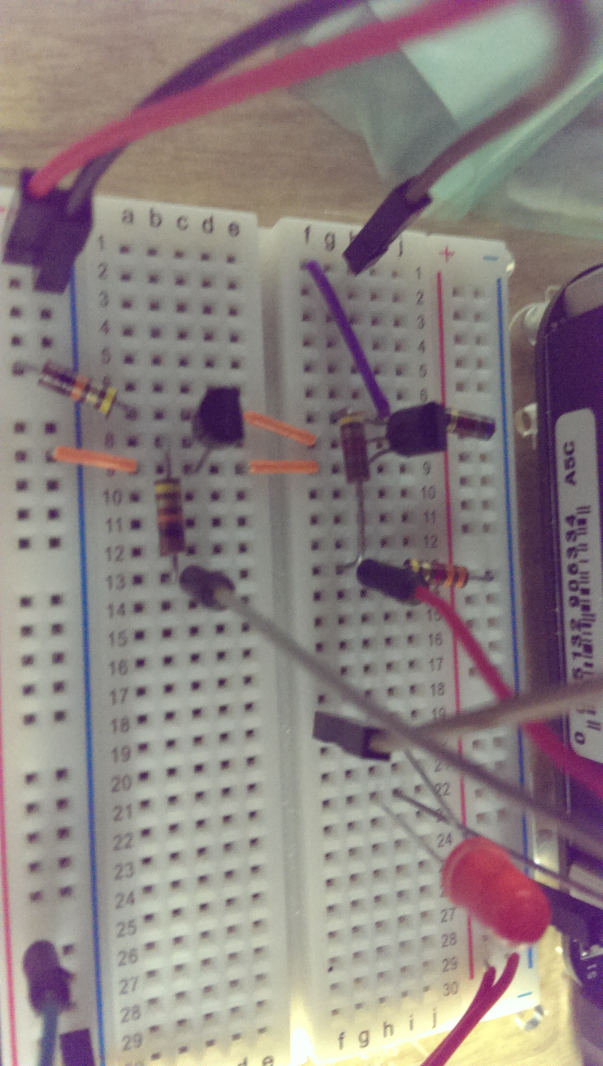
design/FRR/pictures/IMAG0129.jpg
