finger563/agse2015/design/FRR/pictures/IMAG0130.jpg

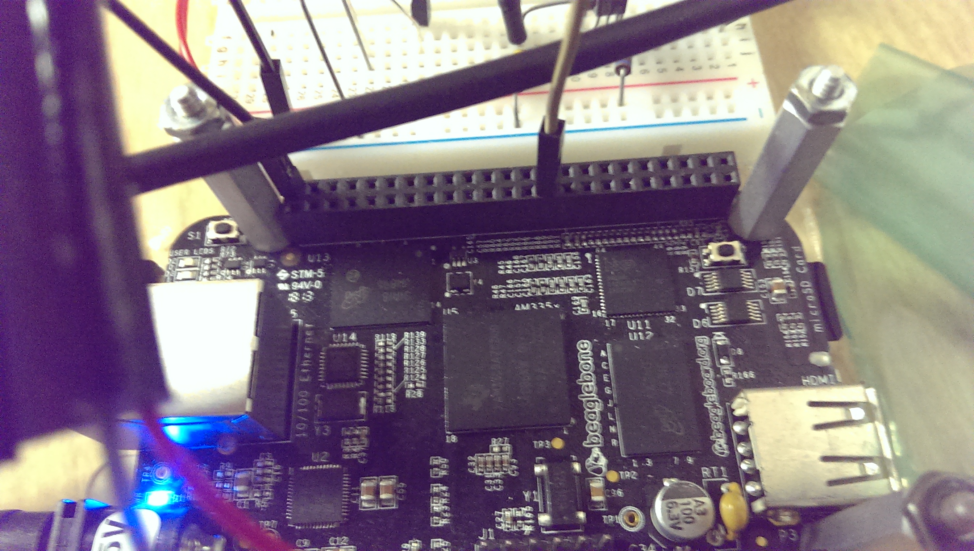
design/FRR/pictures/IMAG0130.jpg
