finger563/agse2015/design/FRR/pictures/IMAG0131.jpg

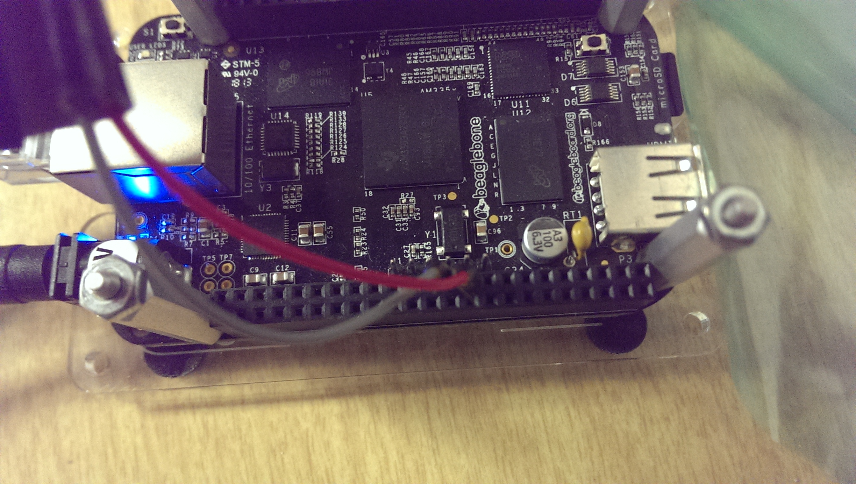
design/FRR/pictures/IMAG0131.jpg
