finger563/agse2015/design/FRR/pictures/IMAG0132.jpg

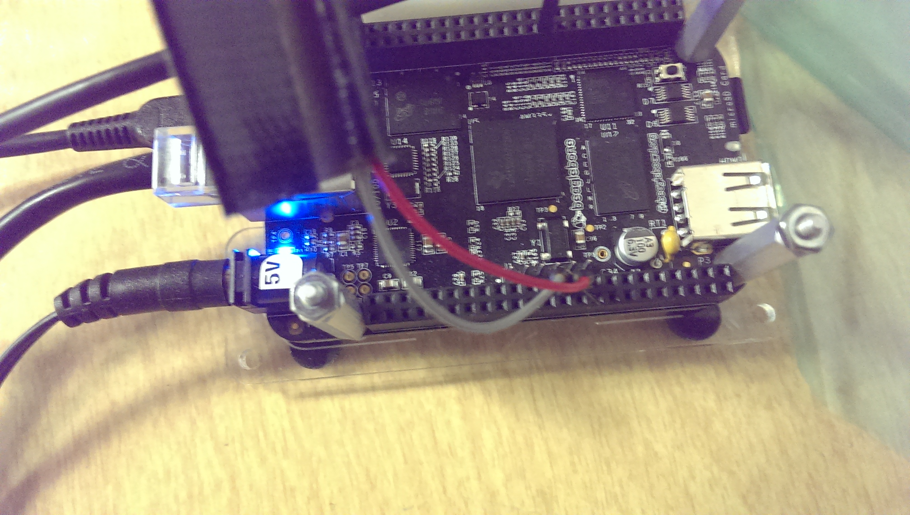
design/FRR/pictures/IMAG0132.jpg
