finger563/agse2015/design/FRR/pictures/IMAG0133.jpg

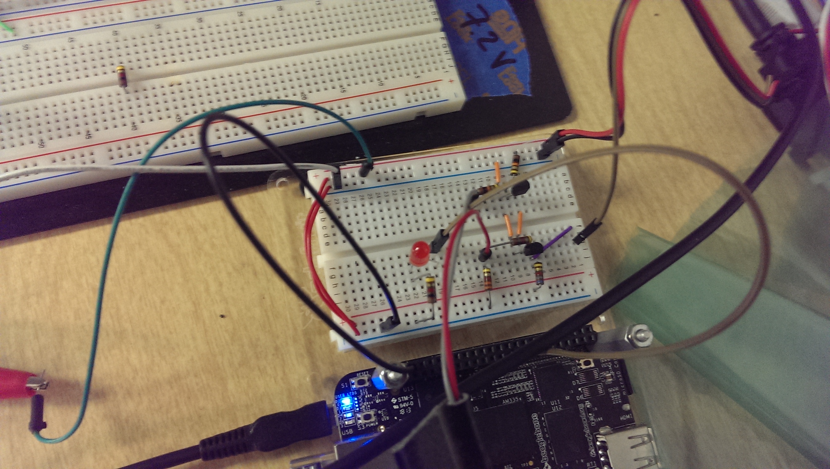
design/FRR/pictures/IMAG0133.jpg
