finger563/agse2015/design/FRR/pictures/IMAG0134.jpg

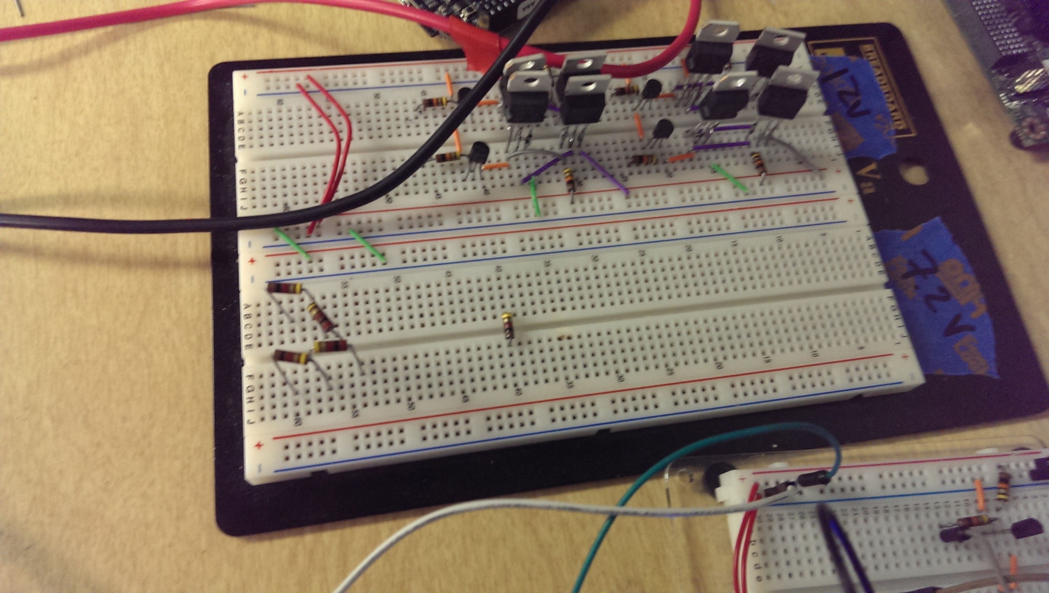
design/FRR/pictures/IMAG0134.jpg
