finger563/agse2015/design/FRR/pictures/pcb_bottom.jpg

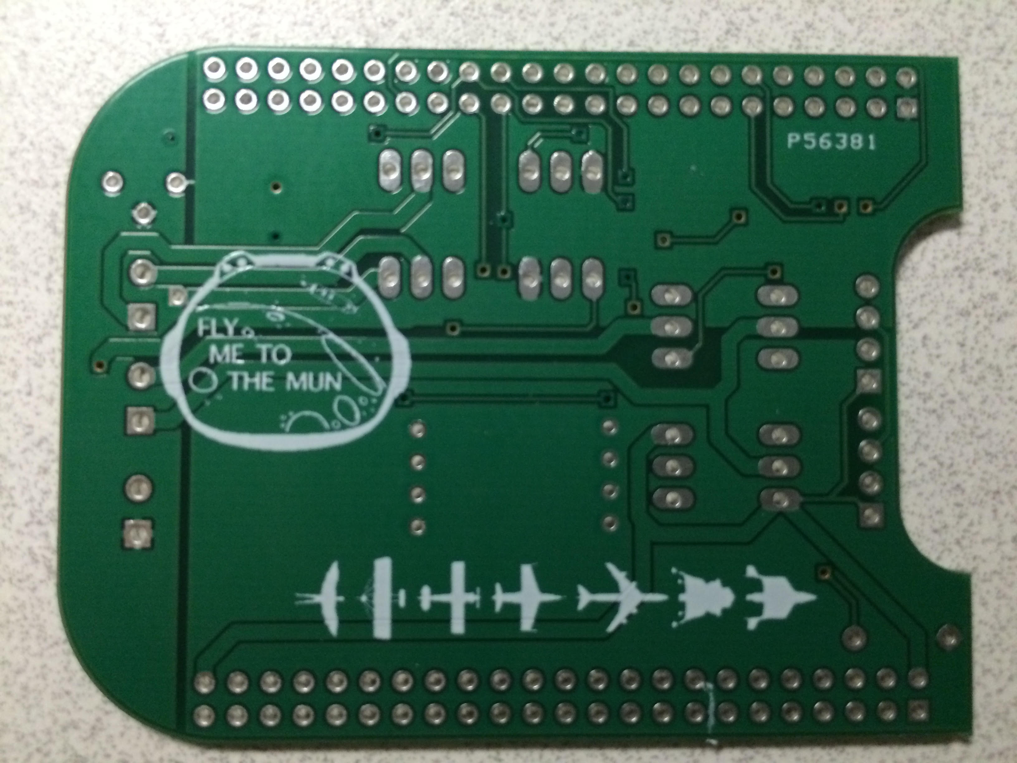
design/FRR/pictures/pcb_bottom.jpg
