finger563/agse2015/design/FRR/pictures/pcb_top.jpg

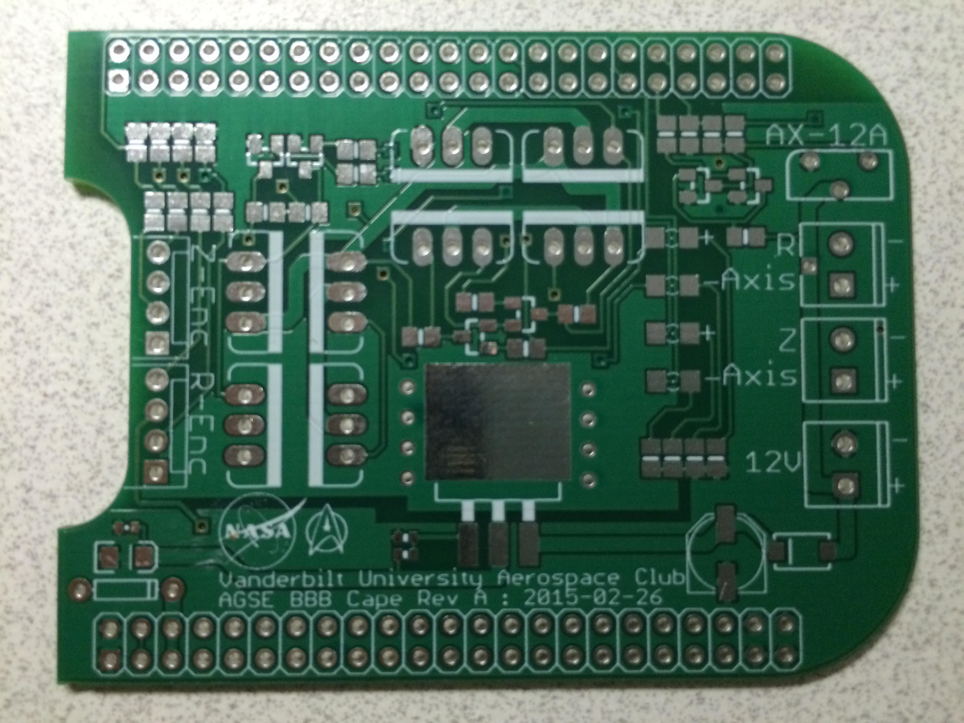
design/FRR/pictures/pcb_top.jpg
