finger563/agse2015/design/schematics/ArmControl/agse_bbb_cape_layout.png

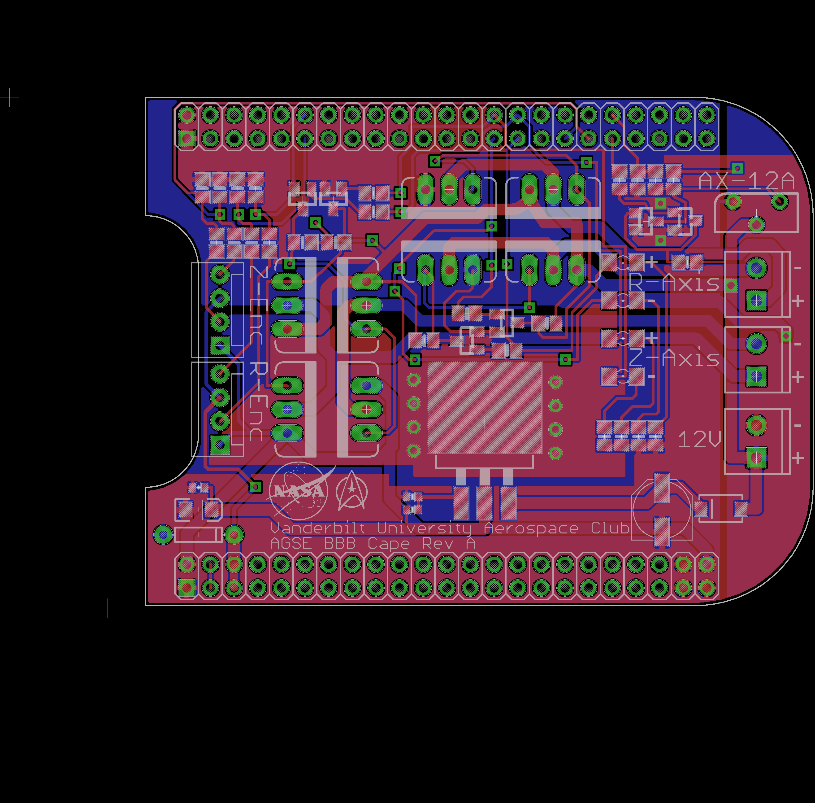
design/schematics/ArmControl/agse_bbb_cape_layout.png
