finger563/agse2015/design/schematics/ArmControl/agse_buffer.png

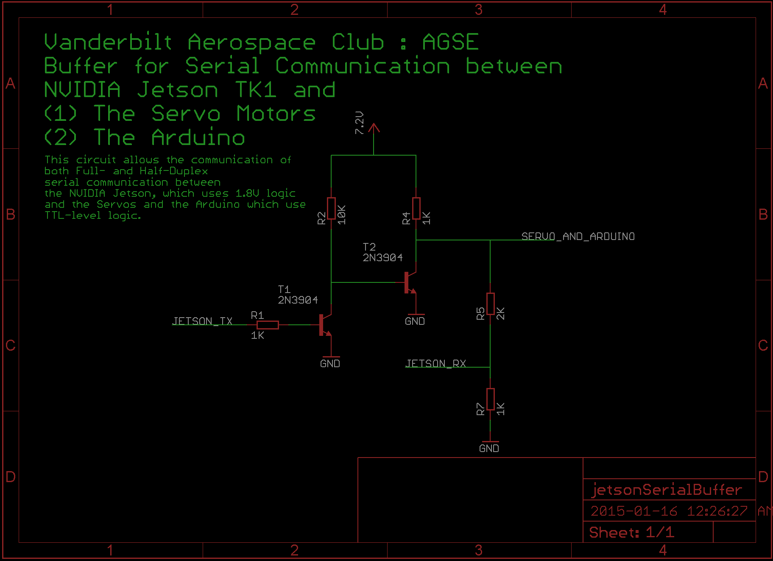
design/schematics/ArmControl/agse_buffer.png
