finger563/agse2015/design/schematics/ArmControl/agse_motor_controller.png

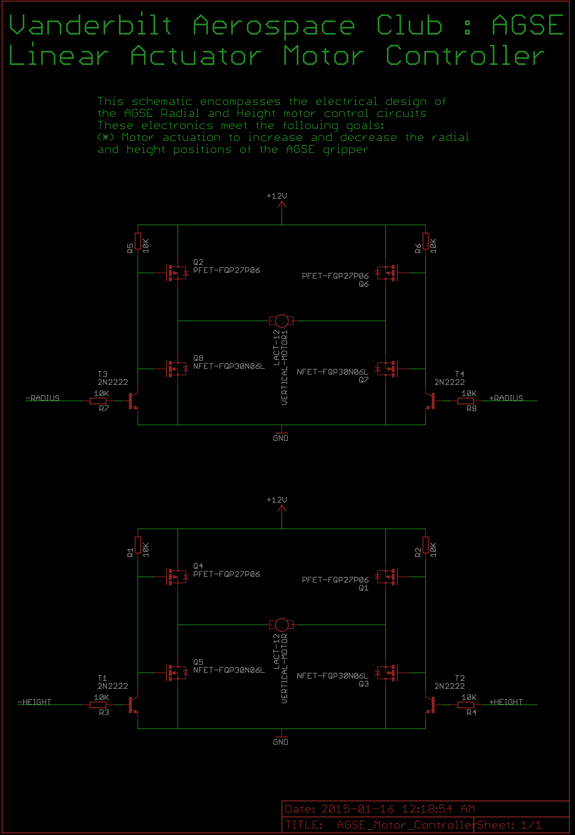
design/schematics/ArmControl/agse_motor_controller.png
