finger563/agse2015/design/schematics/PayloadBay/PayloadBay.png

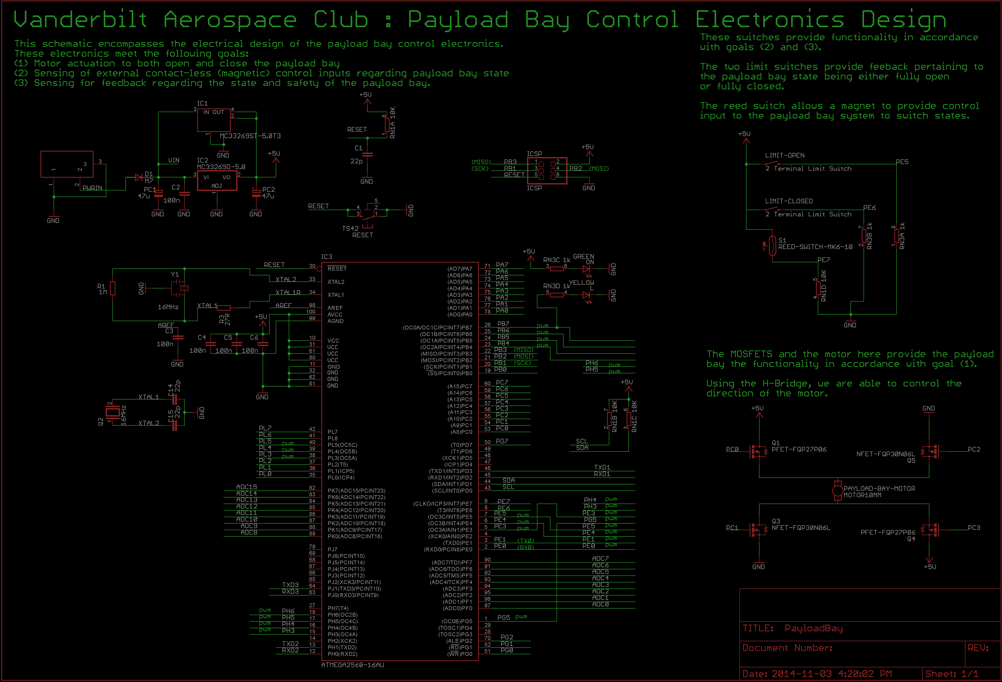
design/schematics/PayloadBay/PayloadBay.png
