finger563/agse2015/design/statechart/agse_design_statechart.png

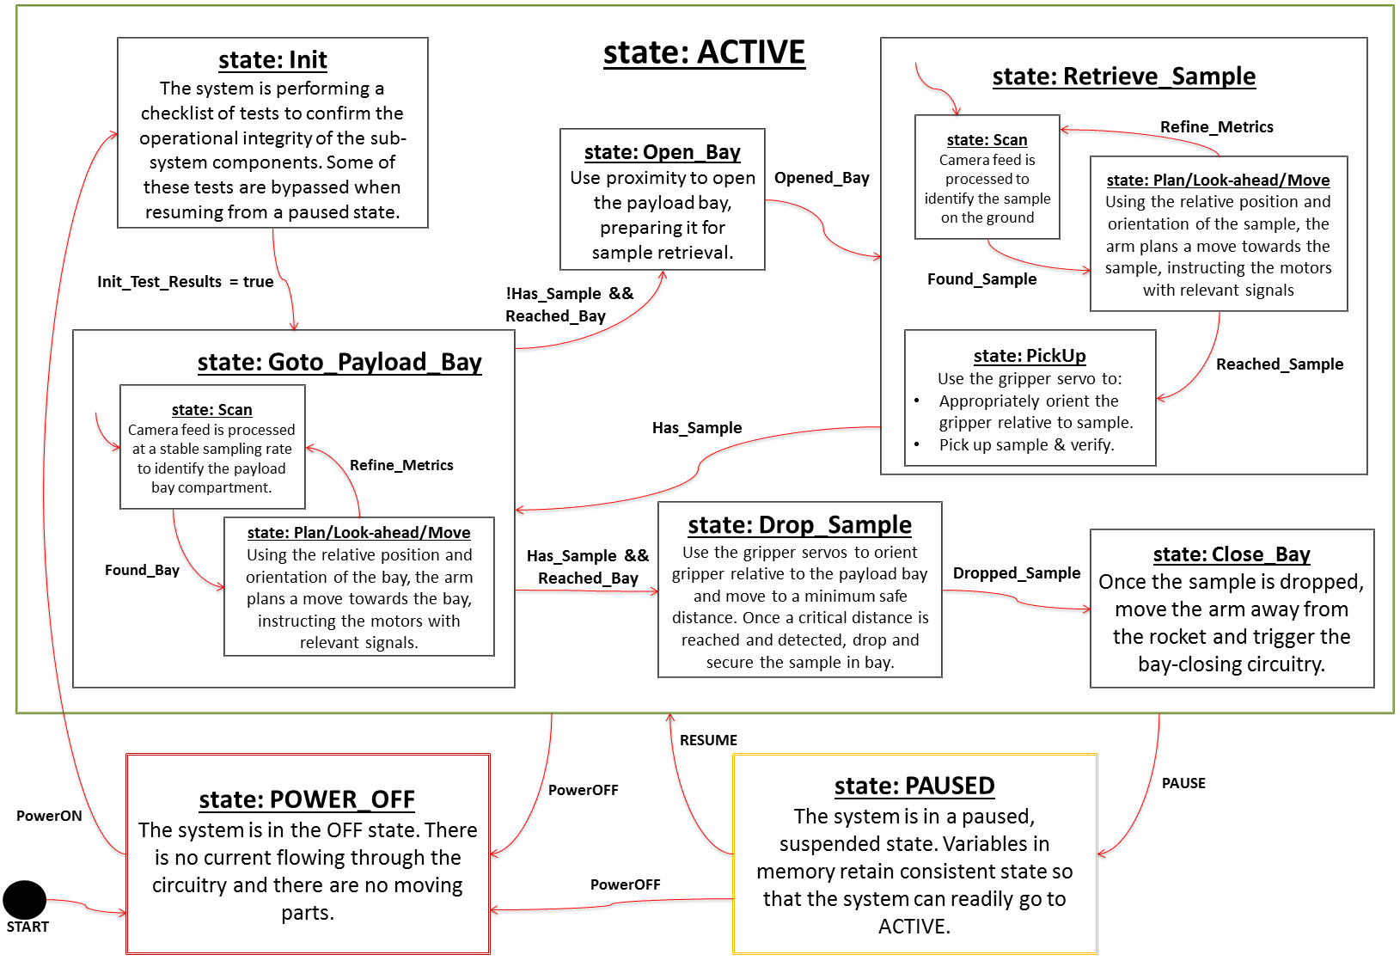
design/statechart/agse_design_statechart.png
