finger563/agse2015/design/statechart/payload_bay_statechart.png

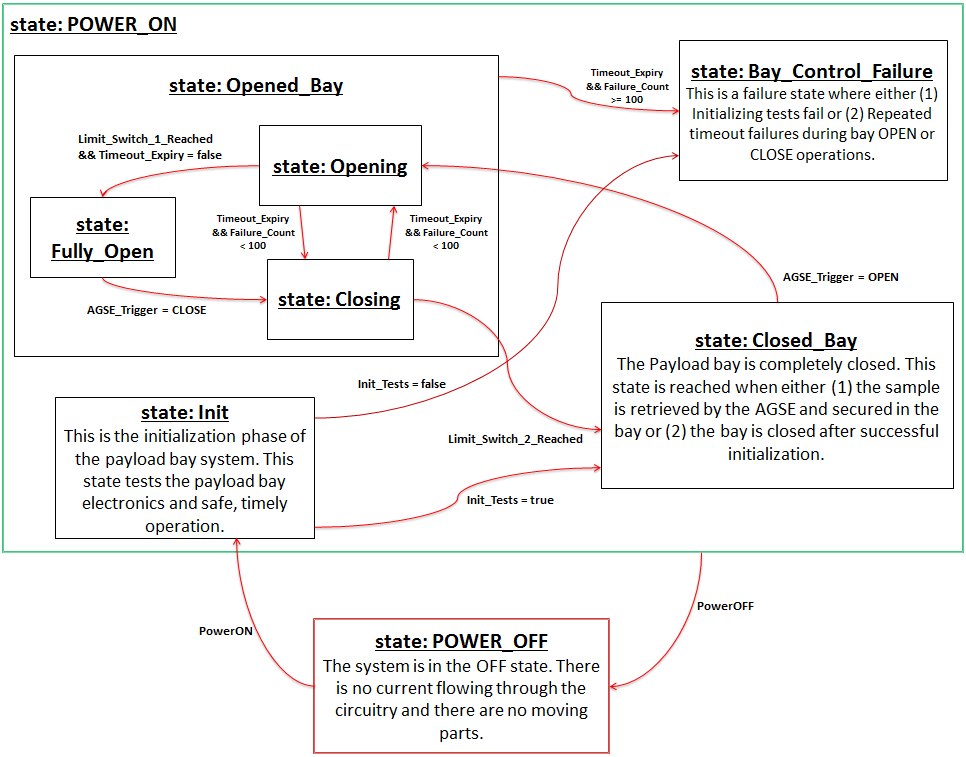
design/statechart/payload_bay_statechart.png
