finger563/agse2015/references/Bone-Cape-Manager-Solution/00-Question.png

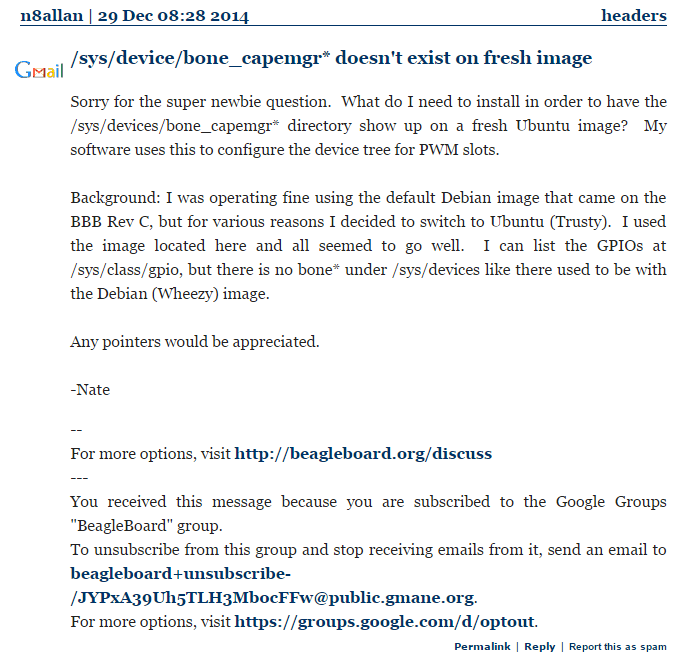
references/Bone-Cape-Manager-Solution/00-Question.png
