finger563/agse2015/references/Bone-Cape-Manager-Solution/01-Answer.png

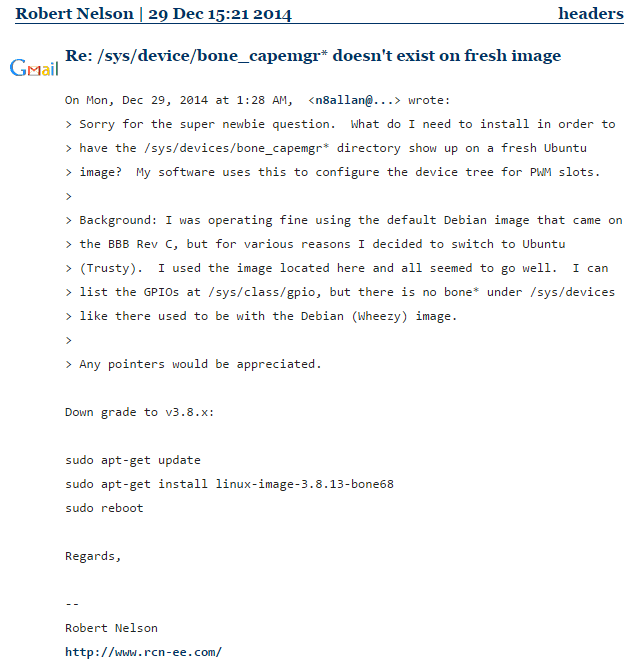
references/Bone-Cape-Manager-Solution/01-Answer.png
