finger563/agse2015/references/markerDetection/marker1.jpg

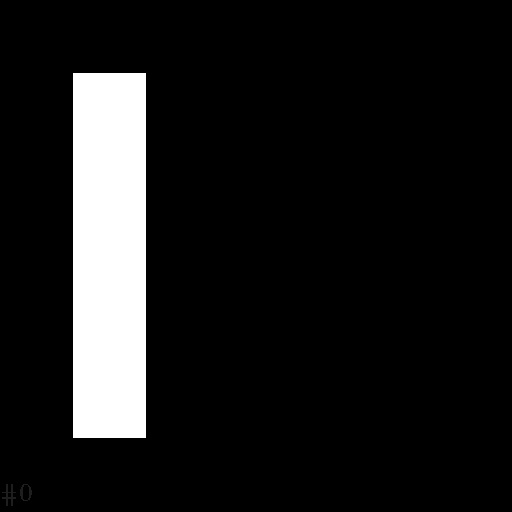
references/markerDetection/marker1.jpg
