finger563/agse2015/references/markerDetection/marker3.jpg

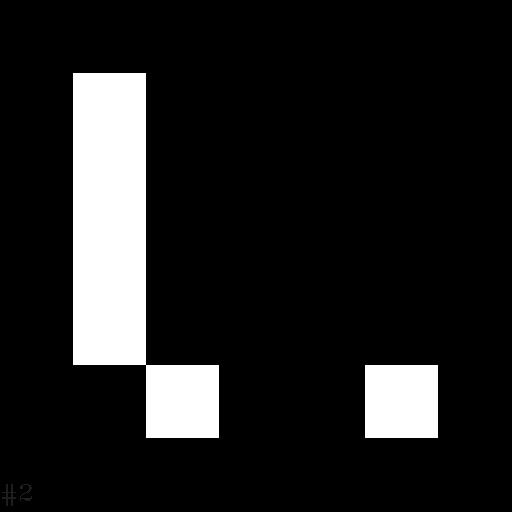
references/markerDetection/marker3.jpg
