finger563/agse2015/references/markerDetection/marker4.jpg

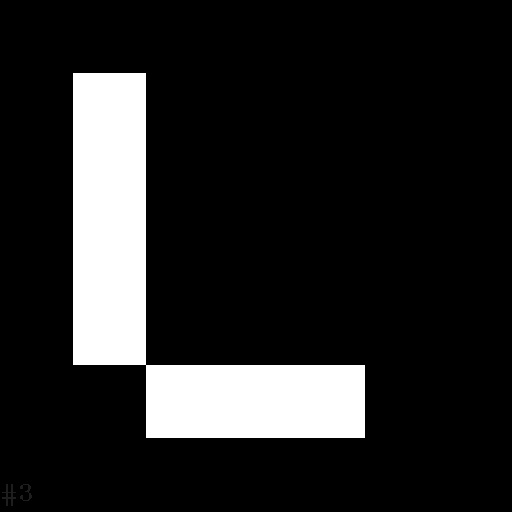
references/markerDetection/marker4.jpg
