finger563/agse2015/references/NVIDIA Jetson TK1/NVIDIA Jetson TK1 Expansion pins.png

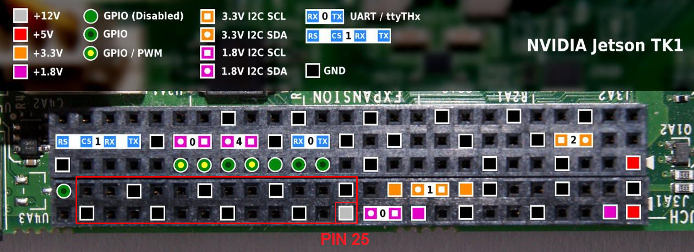
references/NVIDIA Jetson TK1/NVIDIA Jetson TK1 Expansion pins.png
