finger563/agse2015/design/schematics/ArmControl/BOM.xlsx

PART | VALUE | DESCRIPTION | QUANTITY | URL
C1 | 100uF, 50V | Polarized Capacitor | 20 | http://www.mouser.com/ProductDetail/Panasonic/EEE-1HA101UP/
C2 | 10uF, 10V | Polarized Capacitor | 20 | http://www.mouser.com/ProductDetail/Taiyo-Yuden/LMK316B7106KL-TD/
C3 | 0.1uF, 10V | Capacitor | 20 | http://www.mouser.com/ProductDetail/Murata-Electronics/GRM155R61A104KA01D/
D1 | N/A | Diode-SMA | 10 | http://www.mouser.com/ProductDetail/STMicroelectronics/STTH5R06GY-TR/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
D2 | N/A | Diode-1N4148 | 10 | http://www.mouser.com/ProductDetail/Fairchild-Semiconductor/1N4148/?qs=sGAEpiMZZMudZehw8RjeZWbu6z6oTQTL
D3 | N/A | RED LED | 1 (pack of 25) | https://www.sparkfun.com/products/12619
D4 | N/A | GREEN LED | 1 (pack of 25) | https://www.sparkfun.com/products/12622
D5 | N/A | BLUE LED | 1 (pack of 25) | https://www.sparkfun.com/products/12620
D6 | N/A | WHITE LED | 1 (pack of 25) | https://www.sparkfun.com/products/12621
Q1, Q2, Q5, Q6 | FQP27P06 | P-Channel MOSFET | 12 | http://www.mouser.com/ProductDetail/Fairchild-Semiconductor/FQP27P06/
Q3, Q4, Q7, Q8 | FQP30N06L | N-Channel MOSFET | 12 | http://www.mouser.com/ProductDetail/Fairchild-Semiconductor/FQP30N06L/
SERVO | AX-12A | SPOX-3 for AX-12A | 5 | http://www.mouser.com/ProductDetail/Molex/22-43-6030/
T1 to T6 | BC846-NPN-SOT23-BEC | NPN Transistors | 25 | http://www.mouser.com/ProductDetail/NXP/BC846215/
R15,R17,R20,R21,R24 | 1.7K RESISTOR |  | 25 | http://www.mouser.com/ProductDetail/Vishay-Thin-Film/PLTT0805Z1721AGT5/
R16,R18,R19,R22,R23 | 3.3K RESISTOR |  | 25 | http://www.mouser.com/ProductDetail/Panasonic/ERJ-P6WF3301V/
R13 | 7K RESISTOR |  | 10 | http://www.mouser.com/ProductDetail/Vishay/TNPW08057061BT/
R4,R5,R6,R7,R8,R9,R10,R11,R12,R14 | 10K RESISTOR |  | 25 | http://www.mouser.com/ProductDetail/Panasonic/ERJ-P6WF1002V/
R3,R25,R26,R27 | 50 RESISTOR |  | 25 | http://www.mouser.com/ProductDetail/Vishay/CRCW080550R0FKTA/?qs=aRXG1QX2Yl9J6LSLM7CpJQ%3d%3d
R1 | 370 RESISTOR |  | 25 | http://www.mouser.com/ProductDetail/Panasonic/ERJ-2RKF3740X/?qs=sGAEpiMZZMvdGkrng054t8AJgcdMkx7x12YxA1eMwik%3d
R2 | 1.5K RESISTOR |  | 25 | http://www.mouser.com/ProductDetail/Panasonic/ERJ-2RKF1501X/?qs=sGAEpiMZZMvdGkrng054t8AJgcdMkx7xOyRawAAbetk%3d
 | 3.5mm Screw Terminal |  | 15 | https://www.sparkfun.com/products/8084
 | Molex 4 Wire Jumper assembly | Encoder connector @ board | 10 | https://www.sparkfun.com/products/9920
 | Molex 5 Wire jumper assembly | Encoder connector @ encoder | 10 | https://www.sparkfun.com/products/9921
U1 | V_REG_LD1085D2 | V_REG_LD1085D2 | 5 | http://www.mouser.com/ProductDetail/STMicroelectronics/LD1085D2T-R/
uSD-CARDS |  |  | 2 | http://www.mouser.com/ProductDetail/Apacer/AP16GMCSH4-B/?qs=sGAEpiMZZMtyMAXUUxCBE4AZ7JbBE3hTRlqQ2Hq7Z8o%3d
BBB |  |  | 2 | http://www.mouser.com/new/embedded-solutions/beagleboneblack/n-5g1kZ2bv0qx
AX-12A (1) |  |  | 1 | http://www.trossenrobotics.com/dynamixel-ax-12-robot-actuator.aspx
REORDERS: |  |  |  |  | ALTERNATE
D1 | Shottkey 2A Diode | Current protection diode | 8 | http://www.mouser.com/ProductDetail/STMicroelectronics/STPS2150A/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 | http://www.mouser.com/ProductDetail/STMicroelectronics/STPS2L60A/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
C1 | 100uF, 50V | Polarized Capacitor | 8 | http://www.mouser.com/ProductDetail/Nichicon/UWT1V101MCL1GS/?qs=sGAEpiMZZMtZ1n0r9vR22RxmuzErLMSVBmnA2mTwl6Q%3d | http://www.mouser.com/ProductDetail/Panasonic/EEE-FTH101XAP/
