finger563/agse2015/design/schematics/ArmControl/pcb_part_value_soldering.bmp

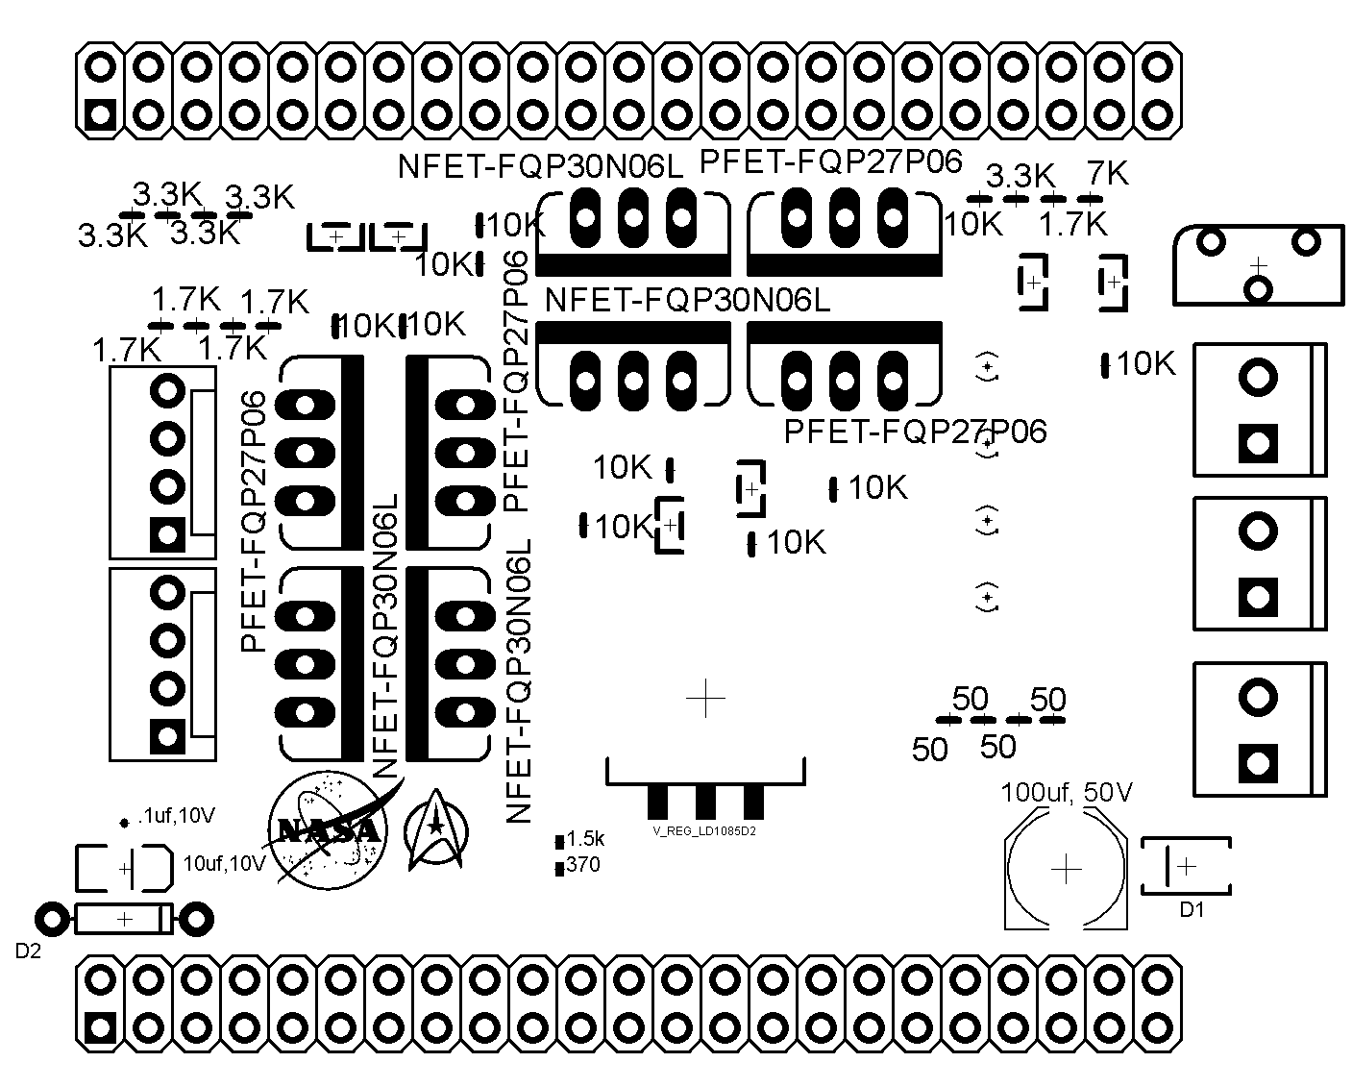
design/schematics/ArmControl/pcb_part_value_soldering.bmp
