finger563/agse2015/design/schematics/ArmControl/pcb_part_value_soldering.png

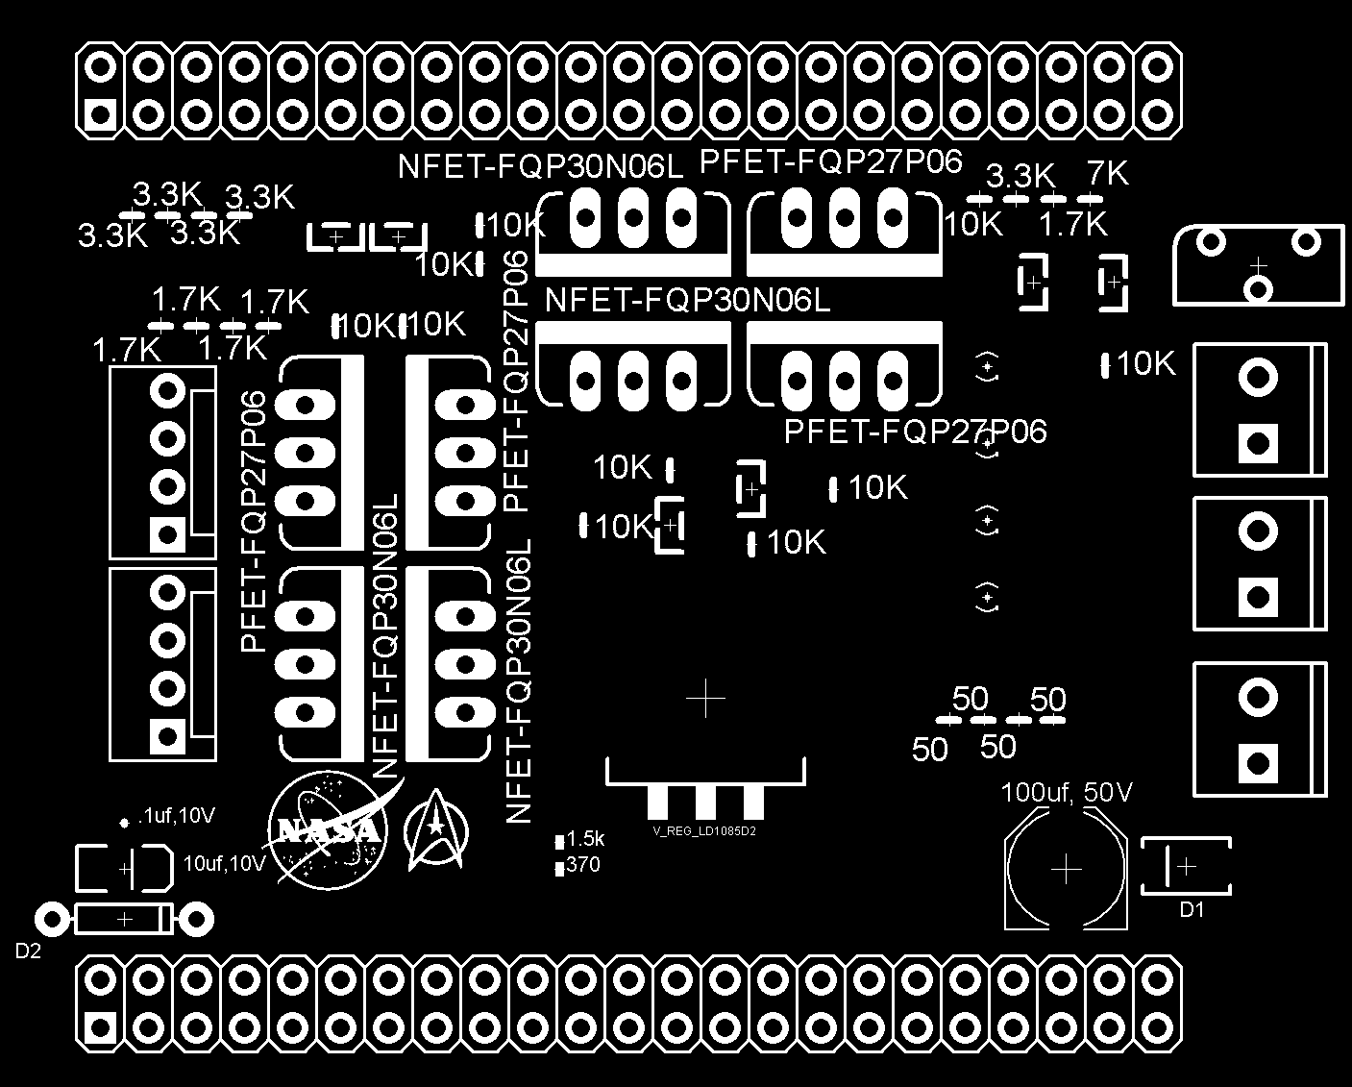
design/schematics/ArmControl/pcb_part_value_soldering.png
