finger563/agse2015/design/FRR/Tests-SampleDetection/03-Area-and-Ratio-Filtering/6/Sample-02-HSV-Filtered.png

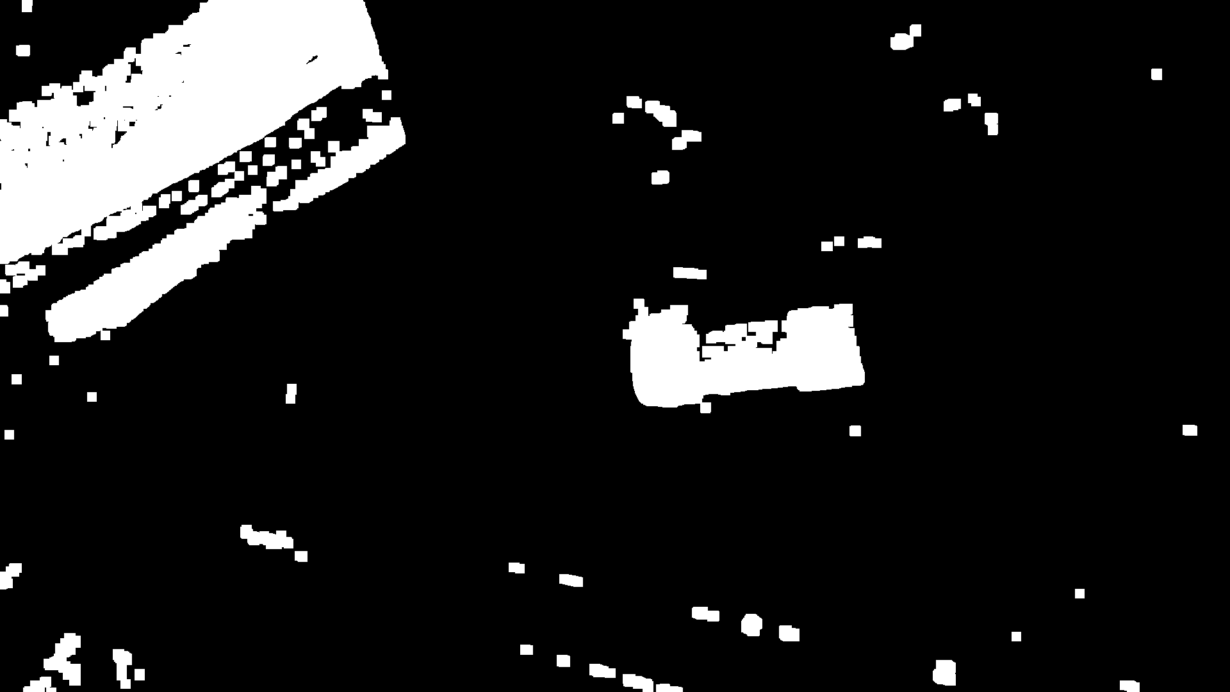
design/FRR/Tests-SampleDetection/03-Area-and-Ratio-Filtering/6/Sample-02-HSV-Filtered.png
