finger563/agse2015/design/FRR/Tests-SampleDetection/03-Area-and-Ratio-Filtering/7/Sample-05-Grayscale-Filtered.png

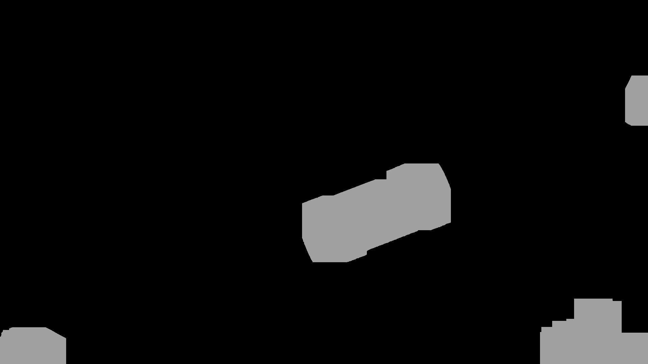
design/FRR/Tests-SampleDetection/03-Area-and-Ratio-Filtering/7/Sample-05-Grayscale-Filtered.png
