finger563/agse2015/design/FRR/Tests-SampleDetection/04-emfinger-tests/test3.png

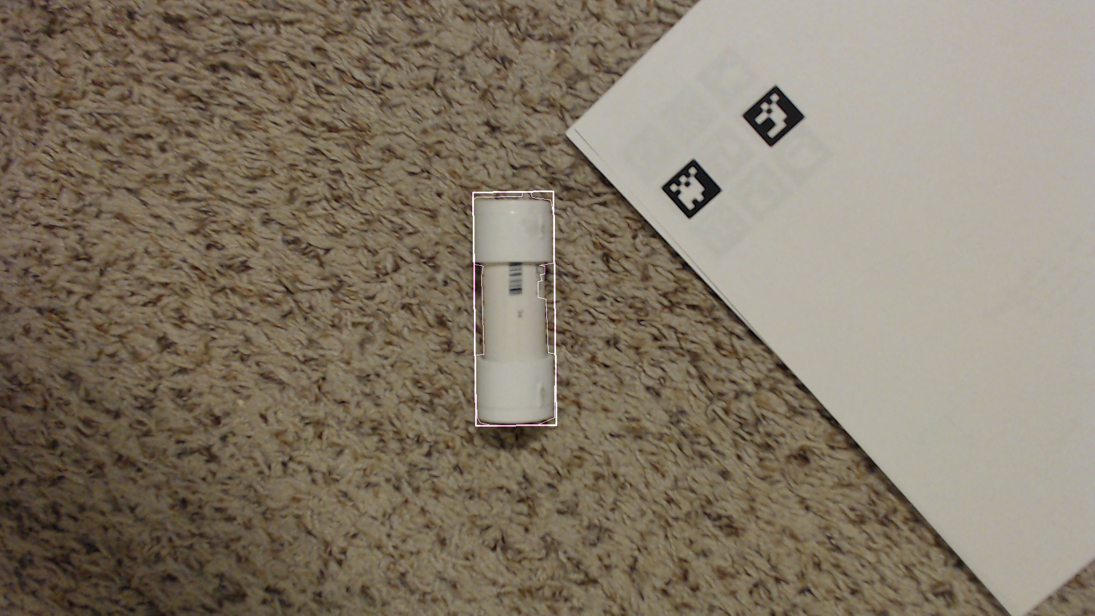
design/FRR/Tests-SampleDetection/04-emfinger-tests/test3.png
