finger563/agse2015/design/FRR/Tests-SampleDetection/04-emfinger-tests/test5.png

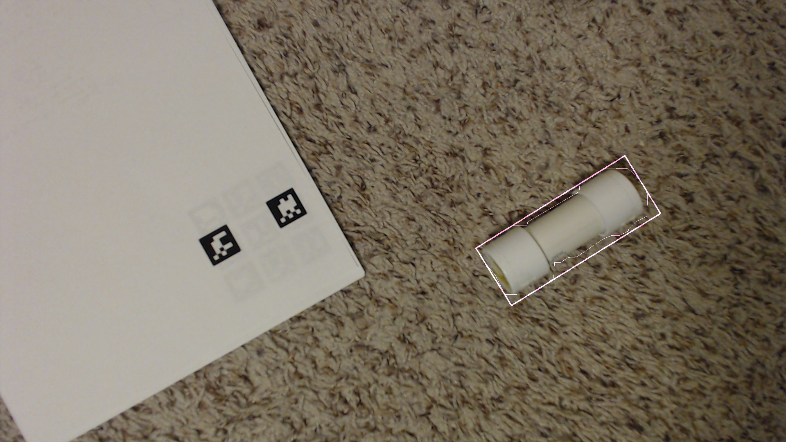
design/FRR/Tests-SampleDetection/04-emfinger-tests/test5.png
