finger563/agse2015/design/FRR/Tests-SampleDetection/04-emfinger-tests/test11.png

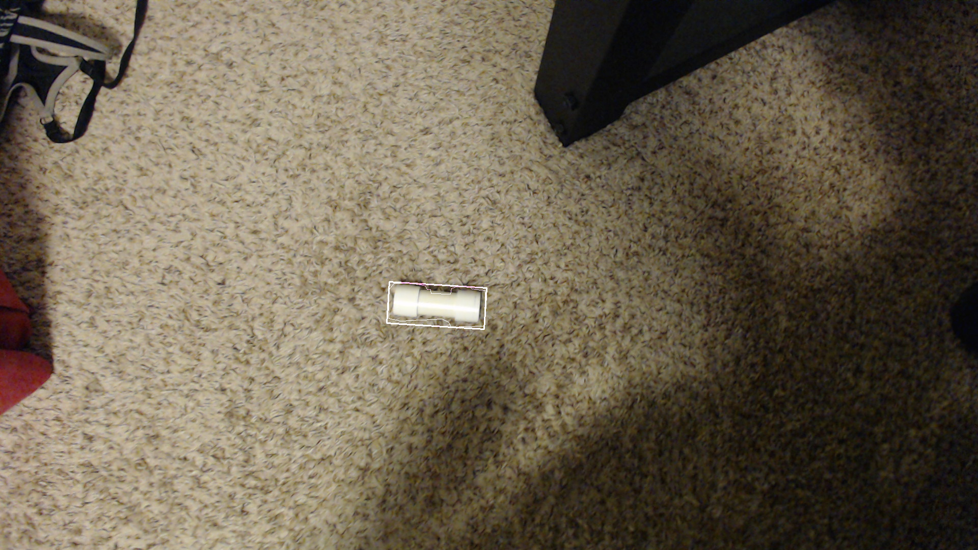
design/FRR/Tests-SampleDetection/04-emfinger-tests/test11.png
