finger563/agse2015/design/FRR/Tests-SampleDetection/04-emfinger-tests/test14.png

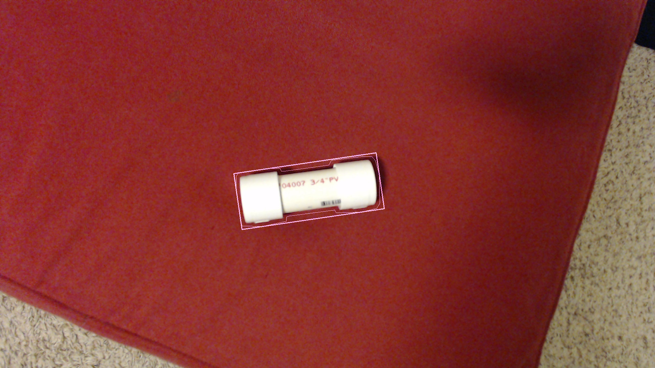
design/FRR/Tests-SampleDetection/04-emfinger-tests/test14.png
