finger563/agse2015/design/FRR/Tests-SampleDetection/05-Saturday-Tests/2/Sample-HSV-Threshold.png

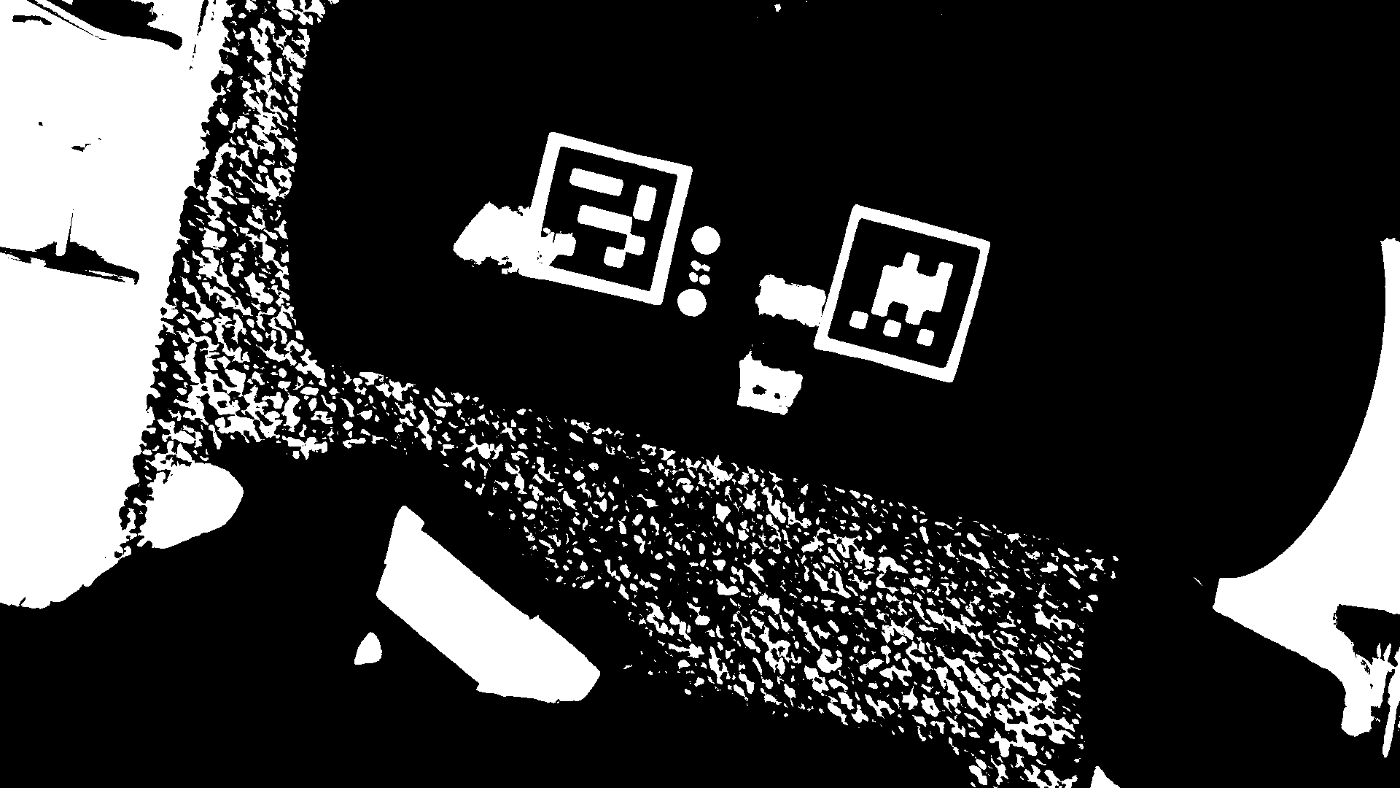
design/FRR/Tests-SampleDetection/05-Saturday-Tests/2/Sample-HSV-Threshold.png
