finger563/agse2015/design/FRR/Tests-SampleDetection/05-Saturday-Tests/6/Sample-02-HSV-Filtered.png

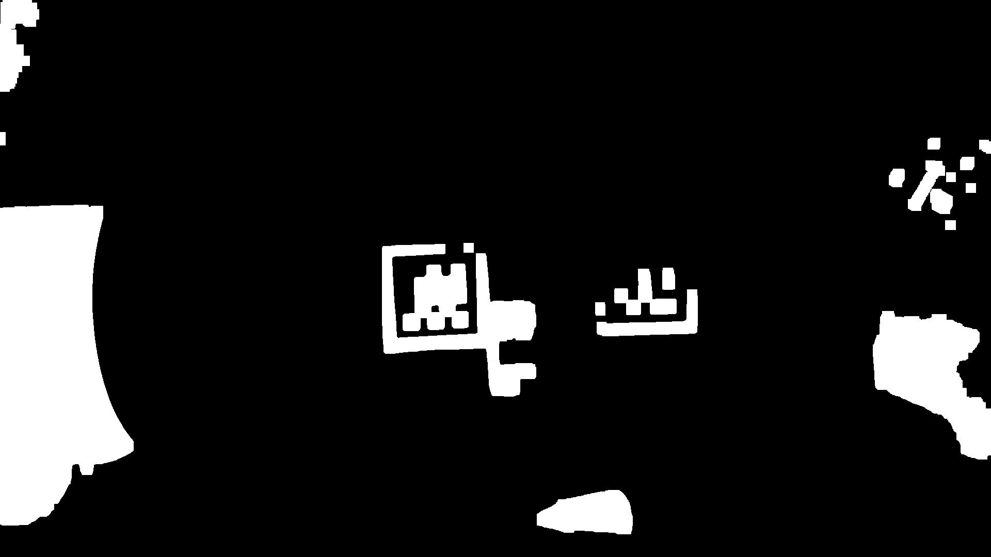
design/FRR/Tests-SampleDetection/05-Saturday-Tests/6/Sample-02-HSV-Filtered.png
