finger563/agse2015/design/FRR/Tests-SampleDetection/05-Saturday-Tests/10/Sample-02-HSV-Filtered.png

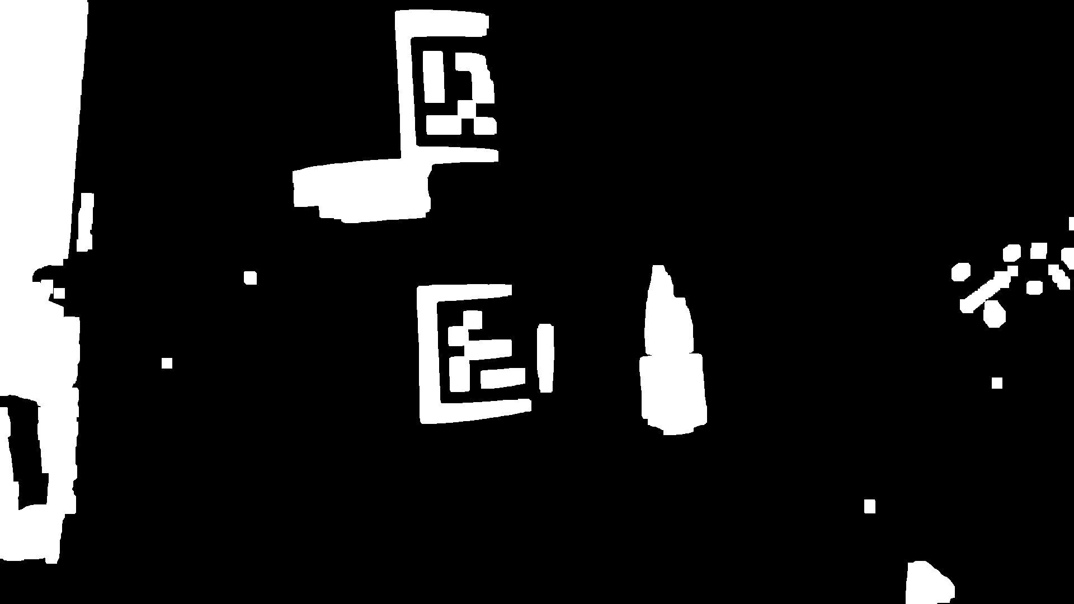
design/FRR/Tests-SampleDetection/05-Saturday-Tests/10/Sample-02-HSV-Filtered.png
