finger563/agse2015/references/markerDetection/testBoard.png

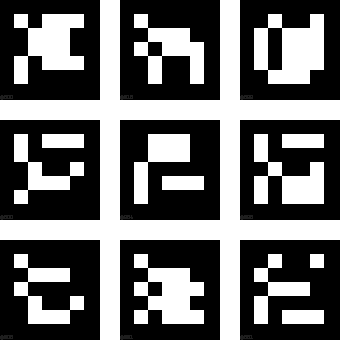
references/markerDetection/testBoard.png
