finger563/agse2015/references/markerDetection/testBoard_2marker.png

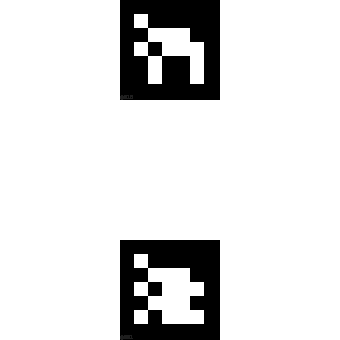
references/markerDetection/testBoard_2marker.png
