finger563/agse2015/design/schematics/ArmControl/AGSE_BBB_cape.brd

## EAGLE design design/schematics/ArmControl/AGSE_BBB_cape.brd (2015-02-27)

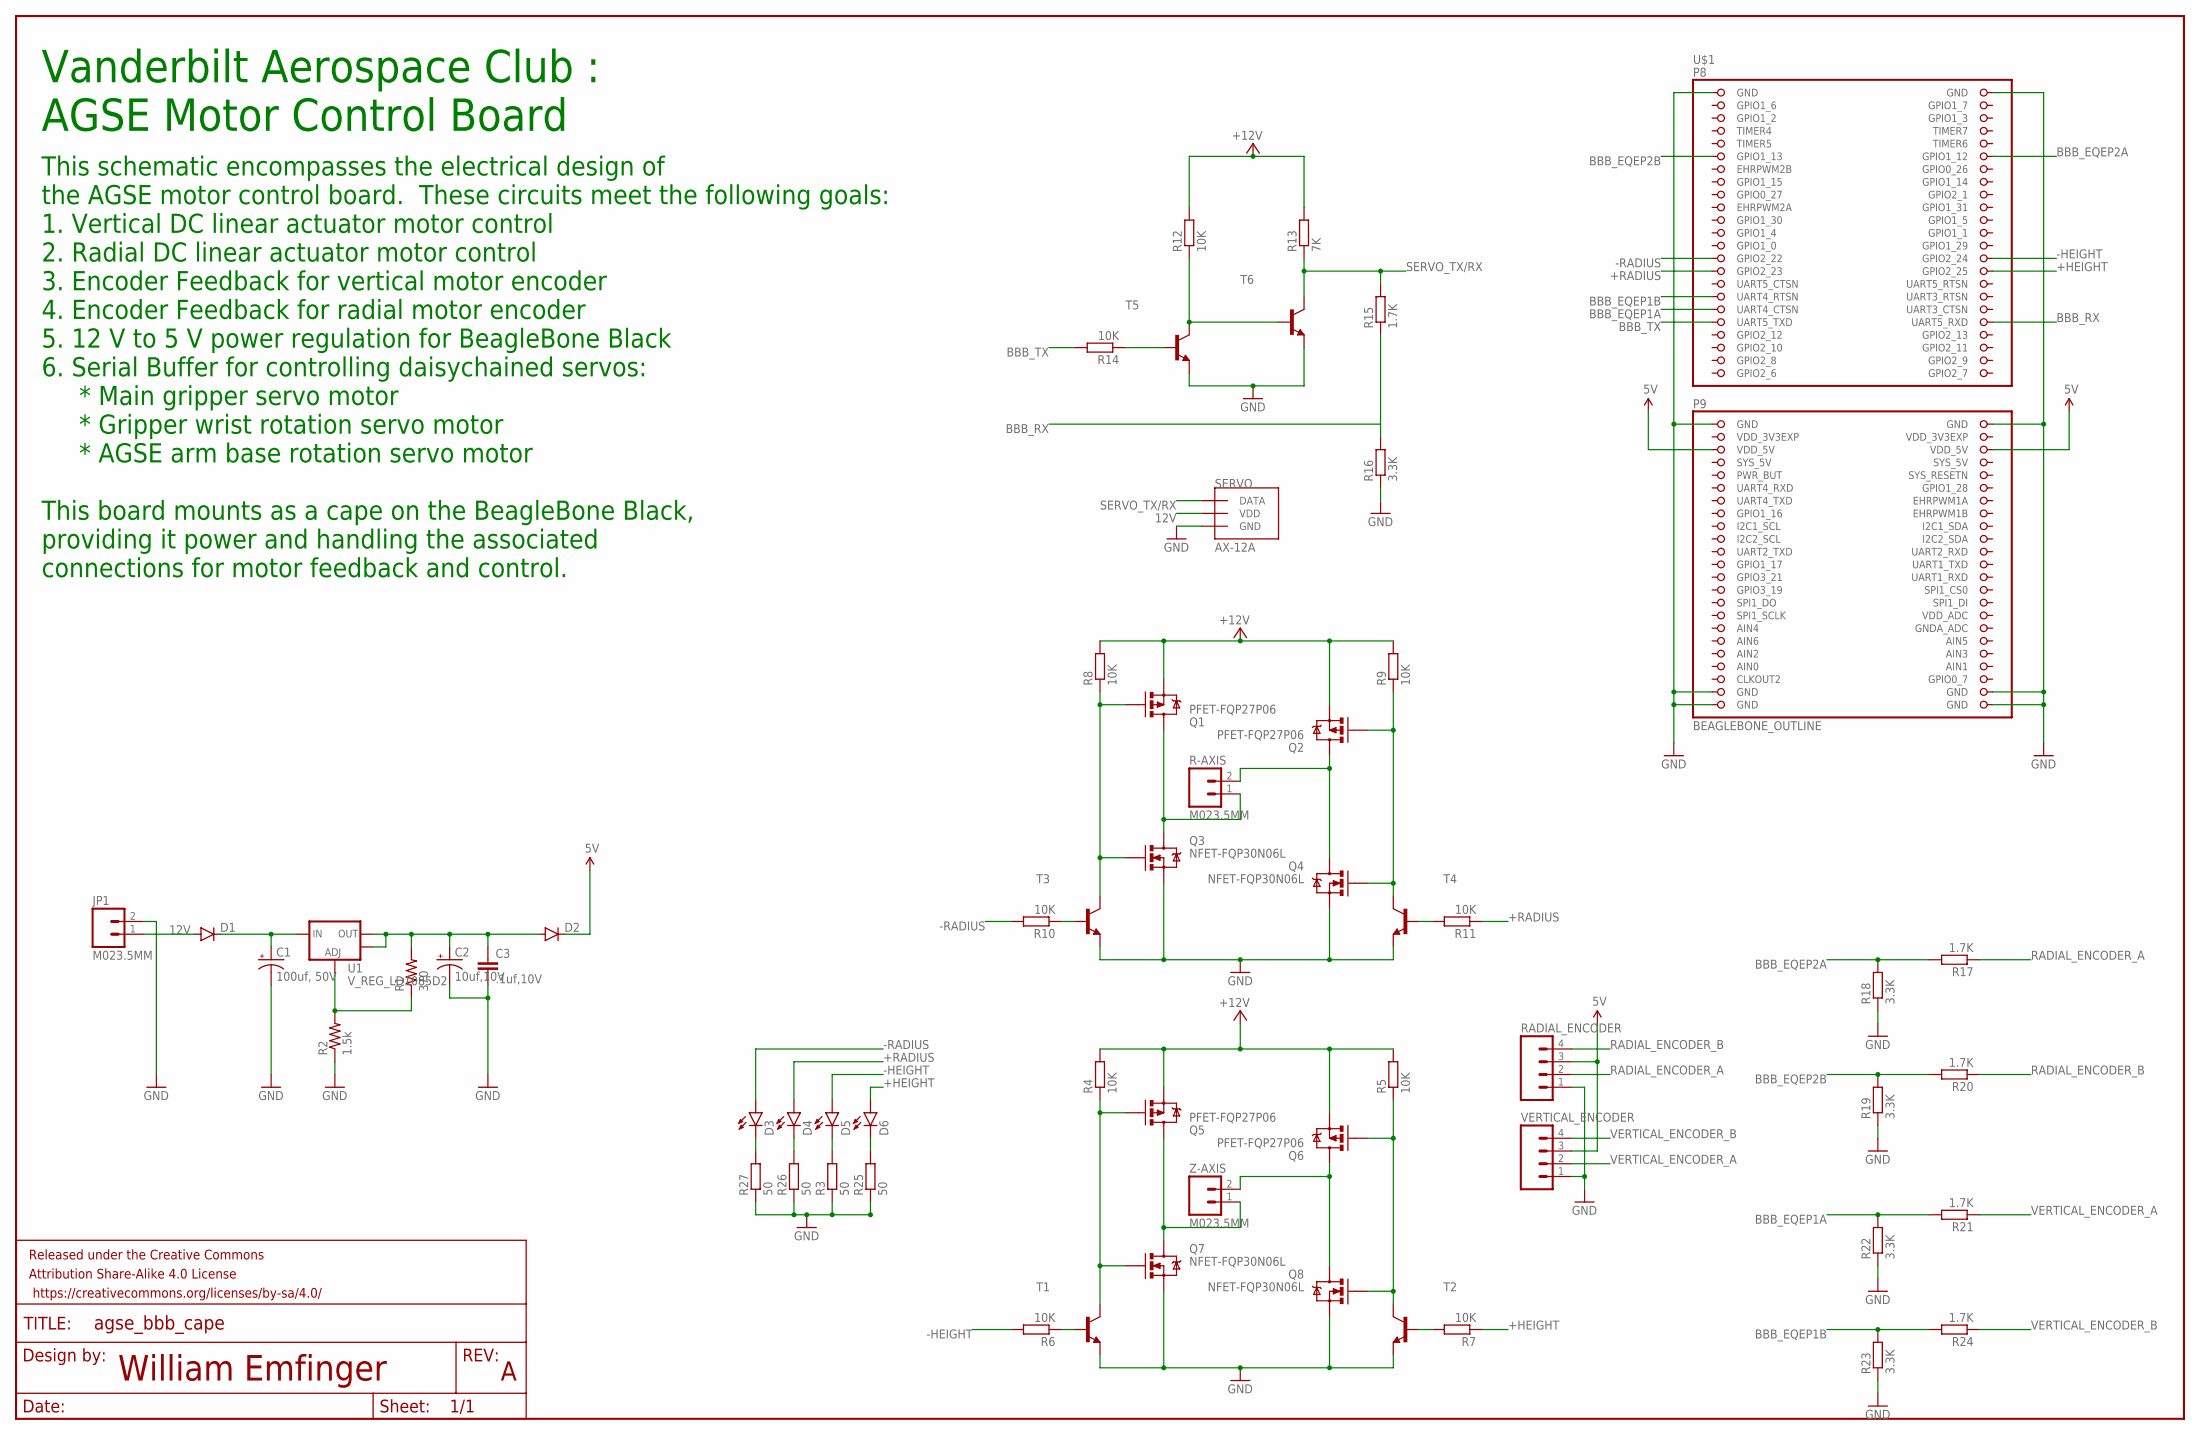
[picture p146: schematic AGSE_BBB_cape.sch]

Parts:
C1: 100uf, 50V; PANASONIC_D
C2: 10uf,10V; EIA3216
C3: .1uf,10V; 0402-CAP
D1: DIODESMA; SMA-DIODE
D2: DIODE1N4148; DIODE-1N4148
D3, D4, D5, D6: LED-FKIT-1206; FKIT-LED-1206
FRAME1: FRAME-LEDGER; CREATIVE_COMMONS
JP1: M023.5MM; SCREWTERMINAL-3.5MM-2
Q1, Q2, Q5, Q6: PFET-FQP27P06; TO220V
Q3, Q4, Q7, Q8: NFET-FQP30N06L; TO220V
R1: 370; 0402-RES
R2: 1.5k; 0402-RES
R3, R25, R26, R27: 50; M0805
R4, R5, R6, R7, R8, R9, R10, R11, R12, R14: 10K; M0805
R13: 7K; M0805
R15, R17, R20, R21, R24: 1.7K; M0805
R16, R18, R19, R22, R23: 3.3K; M0805
R-AXIS: M023.5MM; SCREWTERMINAL-3.5MM-2
RADIAL_ENCODER: M04POLAR; MOLEX-1X4
SERVO: AX-12A; SPOX-3
T1, T2, T3, T4, T5, T6: BF820-NPN-SOT23-BEC; SOT23-BEC
U1: V_REG_LD1085D2; D2PACK/A
U$1: BEAGLEBONE_OUTLINE; BEAGLEBONE_SHIELD
VERTICAL_ENCODER: M04POLAR; MOLEX-1X4
Z-AXIS: M023.5MM; SCREWTERMINAL-3.5MM-2

Connections:
5V: D2.C, RADIAL_ENCODER.3, U$1.51 (VDD_5V), U$1.52 (VDD_5V), VERTICAL_ENCODER.3
12V: D1.A, JP1.1, Q1.3 (S), Q2.3 (S), Q5.3 (S), Q6.3 (S), R4.2, R5.2, R8.2, R9.2, R12.2, R13.2, SERVO.P$2 (VDD)
+HEIGHT: D6.A, R7.1, U$1.30 (GPIO2_25)
+RADIUS: D4.A, R11.1, U$1.29 (GPIO2_23)
-HEIGHT: D5.A, R6.2, U$1.28 (GPIO2_24)
-RADIUS: D3.A, R10.2, U$1.27 (GPIO2_22)
AIN0: U$1.85 (AIN0)
BBB_EQEP1A: R21.2, R22.2, U$1.35 (UART4_CTSN)
BBB_EQEP1B: R23.2, R24.2, U$1.33 (UART4_RTSN)
BBB_EQEP2A: R17.2, R18.2, U$1.12 (GPIO1_12)
BBB_EQEP2B: R19.2, R20.2, U$1.11 (GPIO1_13)
BBB_RX: R15.1, R16.2, U$1.38 (UART5_RXD)
BBB_TX: R14.2, U$1.37 (UART5_TXD)
GND: C1.-, C2.C (-), C3.2, JP1.2, Q3.3 (S), Q4.3 (S), Q7.3 (S), Q8.3 (S), R2.1, R3.1, R16.1, R18.1, R19.1, R22.1, R23.1, R25.1, R26.1, R27.1, RADIAL_ENCODER.1, SERVO.P$3 (GND), T1.E, T2.E, T3.E, T4.E, T5.E, T6.E, U$1.1 (GND), U$1.2 (GND), U$1.47 (GND), U$1.48 (GND), U$1.89 (GND), U$1.90 (GND), U$1.91 (GND), U$1.92 (GND), VERTICAL_ENCODER.1
unnamed: D3.C, R27.2
unnamed: D4.C, R26.2
unnamed: C1.+, D1.C, U1.3 (IN)
unnamed: R1.1, R2.2, U1.1 (ADJ)
unnamed: D5.C, R3.2
unnamed: D6.C, R25.2
unnamed: Q5.1 (G), Q7.1 (G), R4.1, T1.C
unnamed: Q6.1 (G), Q8.1 (G), R5.1, T2.C
unnamed: R6.1, T1.B
unnamed: R7.2, T2.B
unnamed: Q1.1 (G), Q3.1 (G), R8.1, T3.C
unnamed: Q2.1 (G), Q4.1 (G), R9.1, T4.C
unnamed: R10.1, T3.B
unnamed: R11.2, T4.B
unnamed: R14.1, T5.B
unnamed: R12.1, T5.C, T6.B
R+: Q1.2 (D), Q3.2 (D), R-AXIS.1
R-: Q2.2 (D), Q4.2 (D), R-AXIS.2
RADIAL_ENCODER_A: R17.1, RADIAL_ENCODER.2
RADIAL_ENCODER_B: R20.1, RADIAL_ENCODER.4
SERVO_TX/RX: R13.1, R15.2, SERVO.P$1 (DATA), T6.C
SYS_5V: U$1.53 (SYS_5V)
VDD_3V3EXP: U$1.49 (VDD_3V3EXP), U$1.50 (VDD_3V3EXP)
VERTICAL_ENCODER_A: R21.1, VERTICAL_ENCODER.2
VERTICAL_ENCODER_B: R24.1, VERTICAL_ENCODER.4
VOUT: C2.A (+), C3.1, D2.A, R1.2, U1.2 (OUT), U1.TAB (OUT)
Z+: Q5.2 (D), Q7.2 (D), Z-AXIS.1
Z-: Q6.2 (D), Q8.2 (D), Z-AXIS.2

Notes on the sheet:
Vanderbilt Aerospace Club : AGSE Motor Control Board
This schematic encompasses the electrical design of the AGSE motor control board. These circuits meet the following goals: 1. Vertical DC linear actuator motor control 2. Radial DC linear actuator motor control 3. Encoder Feedback for vertical motor encoder 4. Encoder Feedback for radial motor enco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
William Emfinger

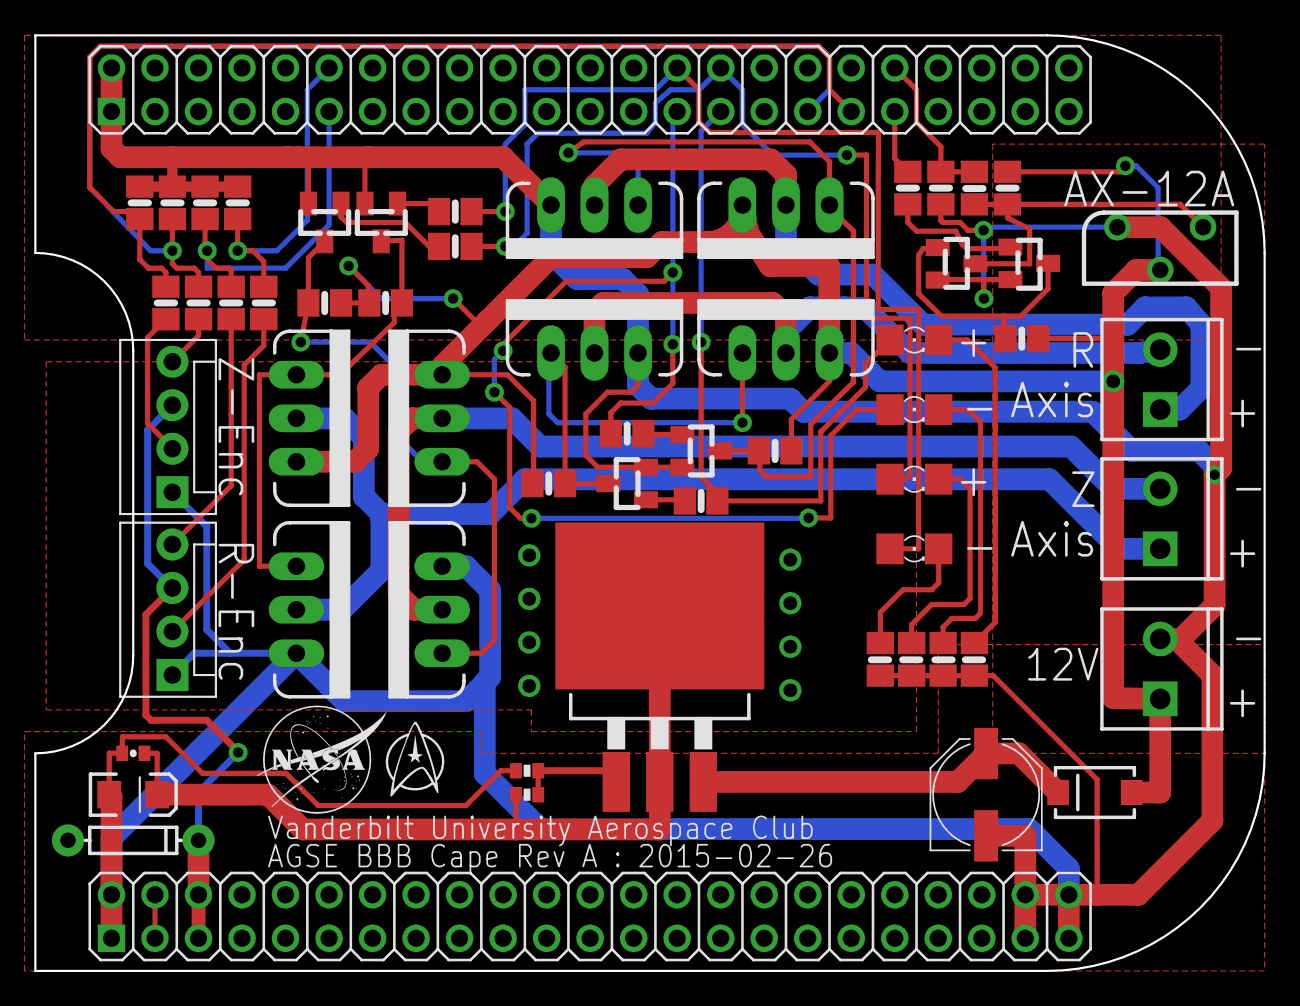
[picture p147: board AGSE_BBB_cape.brd from above]

Board: 2 copper layers, 71.8 x 54.6 mm, 60 parts (0 on the bottom side), 40 nets.

Other parts of the board:
DRILEGEND: DRILEGEND
