finger563/agse2015/design/schematics/ArmControl/jetsonSerialBuffer.brd

## EAGLE design design/schematics/ArmControl/jetsonSerialBuffer.brd (2015-02-21)

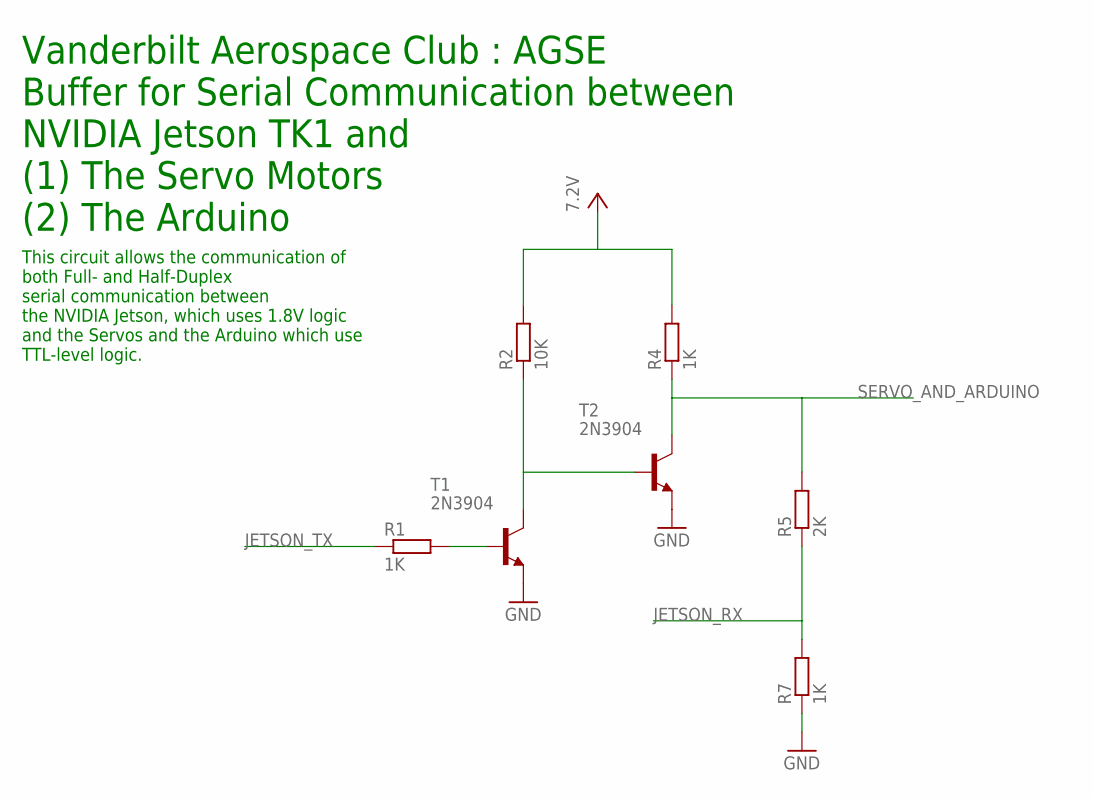
[picture p148: schematic jetsonSerialBuffer.sch]

Parts:
R1, R4, R7: 1K; 0309/10
R2: 10K; 0309/10
R5: 2K; 0309/10
T1, T2: 2N3904; TO92

Connections:
GND: R7.1, T1.3 (E), T2.3 (E)
JETSON_RX: R5.1, R7.2
JETSON_TX: R1.1
unnamed: R1.2, T1.2 (B)
unnamed: R2.1, T1.1 (C), T2.2 (B)
SERVO_AND_ARDUINO: R4.1, R5.2, T2.1 (C)
VCC: R2.2, R4.2

Notes on the sheet:
Vanderbilt Aerospace Club : AGSE Buffer for Serial Communication between NVIDIA Jetson TK1 and (1) The Servo Motors (2) The Arduino
This circuit allows the communication of both Full- and Half-Duplex serial communication between the NVIDIA Jetson, which uses 1.8V logic and the Servos and the Arduino which use TTL-level logic.

Board: 2 copper layers, 7 parts (0 on the bottom side), 6 nets, no tracks yet.
