finger563/agse2015/design/schematics/ArmControl/AGSE_Motor_Controller.brd

## EAGLE design design/schematics/ArmControl/AGSE_Motor_Controller.brd (2015-01-16)

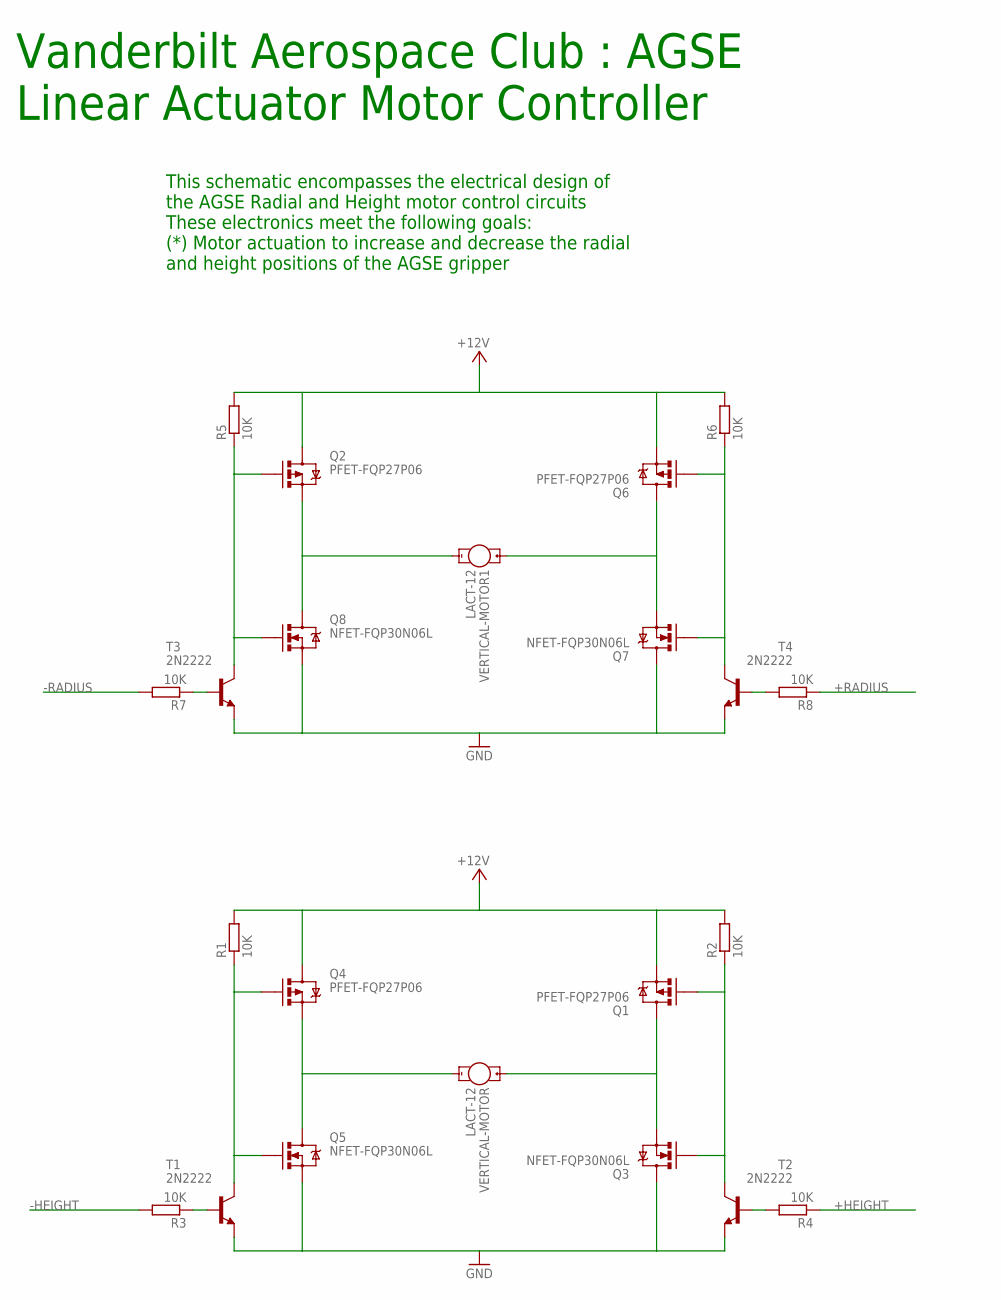
[picture p149: schematic AGSE_Motor_Controller.sch]

Parts:
Q1, Q2, Q4, Q6: PFET-FQP27P06; TO220V
Q3, Q5, Q7, Q8: NFET-FQP30N06L; TO220V
R1, R2, R3, R4, R5, R6, R7, R8: 10K; 0207/12
T1, T2, T3, T4: 2N2222; TO18
VERTICAL-MOTOR, VERTICAL-MOTOR1: LACT-12; VIBE-MOTOR-10MM

Connections:
+5V: Q1.3 (S), Q2.2 (D), Q4.2 (D), Q6.3 (S), R1.2, R2.2, R5.2, R6.2
+HEIGHT: R4.1
+RADIUS: R8.1
-HEIGHT: R3.2
-RADIUS: R7.2
GND: Q3.2 (D), Q5.3 (S), Q7.2 (D), Q8.3 (S), T1.1 (E), T2.1 (E), T3.1 (E), T4.1 (E)
unnamed: Q4.3 (S), Q5.2 (D), VERTICAL-MOTOR.-
unnamed: Q1.2 (D), Q3.3 (S), VERTICAL-MOTOR.+
unnamed: Q4.1 (G), Q5.1 (G), R1.1, T1.3 (C)
unnamed: Q1.1 (G), Q3.1 (G), R2.1, T2.3 (C)
unnamed: R3.1, T1.2 (B)
unnamed: R4.2, T2.2 (B)
unnamed: Q6.2 (D), Q7.3 (S), VERTICAL-MOTOR1.+
unnamed: Q2.3 (S), Q8.2 (D), VERTICAL-MOTOR1.-
unnamed: Q2.1 (G), Q8.1 (G), R5.1, T3.3 (C)
unnamed: Q6.1 (G), Q7.1 (G), R6.1, T4.3 (C)
unnamed: R7.1, T3.2 (B)
unnamed: R8.2, T4.2 (B)

Notes on the sheet:
Vanderbilt Aerospace Club : AGSE Linear Actuator Motor Controller
This schematic encompasses the electrical design of the AGSE Radial and Height motor control circuits These electronics meet the following goals: (*) Motor actuation to increase and decrease the radial and height positions of the AGSE gripper

Board: 2 copper layers, 22 parts (0 on the bottom side), 14 nets, no tracks yet.
