finger563/agse2015/design/schematics/PayloadBay/PayloadBay.brd

## EAGLE design design/schematics/PayloadBay/PayloadBay.brd (2014-11-03)

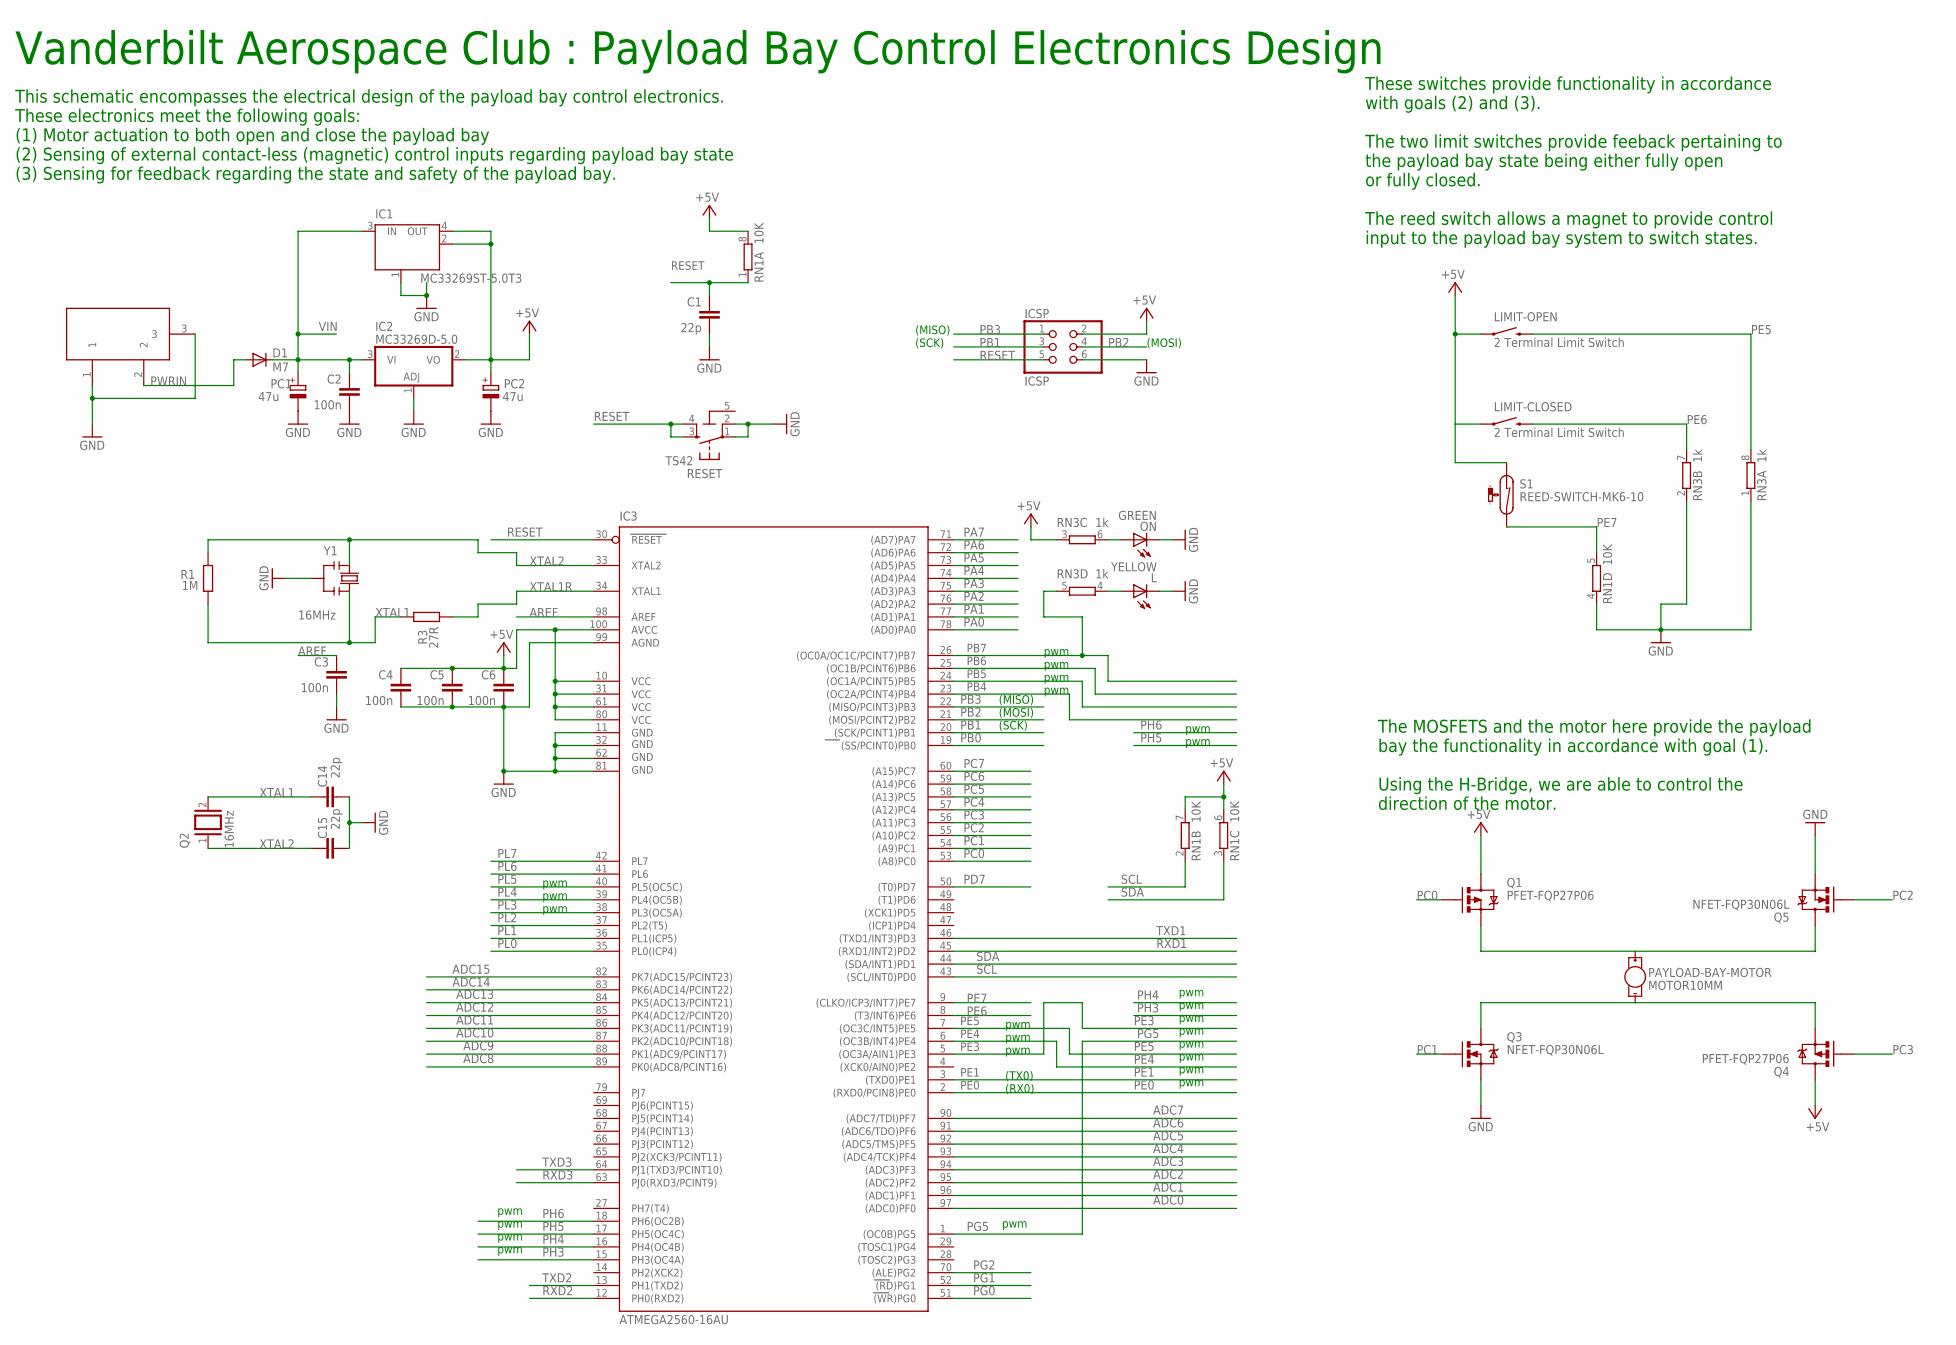
[picture p150: schematic PayloadBay.sch]

Parts:
C1, C14, C15: 22p; C0603-ROUND
C2, C3, C4, C5, C6: 100n; C0603-ROUND
D1: M7; SMB
IC1: MC33269ST-5.0T3; SOT223
IC2: MC33269D-5.0; DPACK
IC3: ATMEGA2560-16AU; TQFP100
ICSP: ICSP; 2X03
L: YELLOW; CHIP-LED0805
LIMIT-CLOSED: 2 Terminal Limit Switch; TACTILE-PTH-12MM
LIMIT-OPEN: 2 Terminal Limit Switch; TACTILE-PTH-12MM
ON: GREEN; CHIP-LED0805
PAYLOAD-BAY-MOTOR: MOTOR10MM; VIBE-MOTOR-10MM
PC1, PC2: 47u; PANASONIC_D
Q1, Q4: PFET-FQP27P06; TO220V
Q2: 16MHz; QS
Q3, Q5: NFET-FQP30N06L; TO220V
R1: 1M; R0603-ROUND
R3: 27R; R0603-ROUND
RESET: TS42
RN1: 10K; CAT16
RN3: 1k; CAY16
S1: REED-SWITCH-MK6-10; MK6-10
X1: DC21MMX; DC-21MM
Y1: 16MHz; RESONATOR

Connections:
5-GND: RESET.5 (5-GND)
+5V: C4.1, C5.1, C6.1, IC1.2 (OUT), IC1.4 (OUT), IC2.2 (VO), IC3.10 (VCC), IC3.31 (VCC1), IC3.61 (VCC2), IC3.80 (VCC3), IC3.100 (AVCC), ICSP.2, LIMIT-CLOSED.1, LIMIT-OPEN.1, PC2.+, Q1.2 (D), Q4.2 (D), RN1.6 (2), RN1.7 (2), RN1.8 (2), RN3.3 (1), S1.1
ADC0: IC3.97 ((ADC0)PF0)
ADC1: IC3.96 ((ADC1)PF1)
ADC2: IC3.95 ((ADC2)PF2)
ADC3: IC3.94 ((ADC3)PF3)
ADC4: IC3.93 ((ADC4/TCK)PF4)
ADC5: IC3.92 ((ADC5/TMS)PF5)
ADC6: IC3.91 ((ADC6/TDO)PF6)
ADC7: IC3.90 ((ADC7/TDI)PF7)
ADC8: IC3.89 (PK0(ADC8/PCINT16))
ADC9: IC3.88 (PK1(ADC9/PCINT17))
ADC10: IC3.87 (PK2(ADC10/PCINT18))
ADC11: IC3.86 (PK3(ADC11/PCINT19))
ADC12: IC3.85 (PK4(ADC12/PCINT20))
ADC13: IC3.84 (PK5(ADC13/PCINT21))
ADC14: IC3.83 (PK6(ADC14/PCINT22))
ADC15: IC3.82 (PK7(ADC15/PCINT23))
AREF: C3.1, IC3.98 (AREF)
GND: C1.2, C2.2, C3.2, C4.2, C5.2, C6.2, C14.1, C15.1, IC1.1 (GND/ADJ), IC2.1 (ADJ), IC3.11 (GND), IC3.32 (GND1), IC3.62 (GND2), IC3.81 (GND3), IC3.99 (AGND), ICSP.6, L.C, ON.C, PC1.-, PC2.-, Q3.3 (S), Q5.3 (S), RESET.1, RESET.2, RN1.4 (1), RN3.1, RN3.2 (1), X1.1, X1.3, Y1.2
unnamed: PAYLOAD-BAY-MOTOR.+, Q1.3 (S), Q5.2 (D)
unnamed: L.A, RN3.4 (1)
unnamed: ON.A, RN3.6 (2)
unnamed: PAYLOAD-BAY-MOTOR.-, Q3.2 (D), Q4.3 (S)
PA0: IC3.78 ((AD0)PA0)
PA1: IC3.77 ((AD1)PA1)
PA2: IC3.76 ((AD2)PA2)
PA3: IC3.75 ((AD3)PA3)
PA4: IC3.74 ((AD4)PA4)
PA5: IC3.73 ((AD5)PA5)
PA6: IC3.72 ((AD6)PA6)
PA7: IC3.71 ((AD7)PA7)
PB0: IC3.19 ((SS/PCINT0)PB0)
PB1: IC3.20 ((SCK/PCINT1)PB1), ICSP.3
PB2: IC3.21 ((MOSI/PCINT2)PB2), ICSP.4
PB3: IC3.22 ((MISO/PCINT3)PB3), ICSP.1
PB4: IC3.23 ((OC2A/PCINT4)PB4)
PB5: IC3.24 ((OC1A/PCINT5)PB5)
PB6: IC3.25 ((OC1B/PCINT6)PB6)
PB7: IC3.26 ((OC0A/OC1C/PCINT7)PB7), RN3.5 (2)
PC0: IC3.53 ((A8)PC0)
PC1: IC3.54 ((A9)PC1), Q3.1 (G)
PC2: IC3.55 ((A10)PC2), Q5.1 (G)
PC3: IC3.56 ((A11)PC3), Q4.1 (G)
PC4: IC3.57 ((A12)PC4)
PC5: IC3.58 ((A13)PC5)
PC6: IC3.59 ((A14)PC6)
PC7: IC3.60 ((A15)PC7)
PD7: IC3.50 ((T0)PD7)
PE0: IC3.2 ((RXD0/PCIN8)PE0)
PE1: IC3.3 ((TXD0)PE1)
PE3: IC3.5 ((OC3A/AIN1)PE3)
PE4: IC3.6 ((OC3B/INT4)PE4)
PE5: IC3.7 ((OC3C/INT5)PE5), LIMIT-OPEN.3 (2), RN3.8 (2)
PE6: IC3.8 ((T3/INT6)PE6), LIMIT-CLOSED.3 (2), RN3.7 (2)
PE7: IC3.9 ((CLKO/ICP3/INT7)PE7), RN1.5 (2), S1.2
PG0: IC3.51 ((WR)PG0)
PG1: IC3.52 ((RD)PG1)
PG2: IC3.70 ((ALE)PG2)
PG5: IC3.1 ((OC0B)PG5)
PH3: IC3.15 (PH3(OC4A))
PH4: IC3.16 (PH4(OC4B))
PH5: IC3.17 (PH5(OC4C))
PH6: IC3.18 (PH6(OC2B))
PL0: IC3.35 (PL0(ICP4))
PL1: IC3.36 (PL1(ICP5))
PL2: IC3.37 (PL2(T5))
PL3: IC3.38 (PL3(OC5A))
PL4: IC3.39 (PL4(OC5B))
PL5: IC3.40 (PL5(OC5C))
PL6: IC3.41 (PL6)
PL7: IC3.42 (PL7)
PWRIN: D1.A, X1.2
RESET: C1.1, IC3.30 (RESET), ICSP.5, RESET.3, RESET.4, RN1.1
RXD1: IC3.45 ((RXD1/INT2)PD2)
RXD2: IC3.12 (PH0(RXD2))
RXD3: IC3.63 (PJ0(RXD3/PCINT9))
SCL: IC3.43 ((SCL/INT0)PD0), RN1.2 (1)
SDA: IC3.44 ((SDA/INT1)PD1), RN1.3 (1)
TXD1: IC3.46 ((TXD1/INT3)PD3)
TXD2: IC3.13 (PH1(TXD2))
TXD3: IC3.64 (PJ1(TXD3/PCINT10))
VIN: C2.1, D1.C, IC1.3 (IN), IC2.3 (VI), PC1.+
XTAL1: C14.2, Q2.2, R1.1, R3.2, Y1.3
XTAL1R: IC3.34 (XTAL1), R3.1
XTAL2: C15.2, IC3.33 (XTAL2), Q2.1, R1.2, Y1.1

Notes on the sheet:
(SCK)
(MISO)
(MOSI)
pwm
(TX0)
(RX0)
Vanderbilt Aerospace Club : Payload Bay Control Electronics Design
This schematic encompasses the electrical design of the payload bay control electronics. These electronics meet the following goals: (1) Motor actuation to both open and close the payload bay (2) Sensing of external contact-less (magnetic) control inputs regarding payload bay state (3) Sensing for 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
These switches provide functionality in accordance with goals (2) and (3). The two limit switches provide feeback pertaining to the payload bay state being either fully open or fully closed. The reed switch allows a magnet to provide control input to the payload bay system to switch states.
The MOSFETS and the motor here provide the payload bay the functionality in accordance with goal (1). Using the H-Bridge, we are able to control the direction of the motor.

Board: 2 copper layers, 33 parts (0 on the bottom side), 25 nets, no tracks yet.
