finger563/agse2015/references/markerDetection/camera4.yml

%YAML:1.0
calibration_time: "Fri 03 Apr 2015 03:25:34 PM CDT"
image_width: 640
image_height: 480
board_width: 9
board_height: 6
square_size: 1.
flags: 0
camera_matrix: !!opencv-matrix
   rows: 3
   cols: 3
   dt: d
   data: [ 6.2370894694382741e+02, 0., 3.3159167881125080e+02, 0.,
       6.2221769031672159e+02, 2.3445542763000438e+02, 0., 0., 1. ]
distortion_coefficients: !!opencv-matrix
   rows: 5
   cols: 1
   dt: d
   data: [ 1.1471351939793309e-01, -1.3280378284638259e+00,
       2.2517269903420192e-03, 9.8036307964522347e-03,
       8.0861740642777455e+00 ]
avg_reprojection_error: 5.2181448023708443e-01
image_points: !!opencv-matrix
   rows: 10
   cols: 54
   dt: "2f"
   data: [ 2.06142593e+02, 9.15370178e+01, 2.30815247e+02,
       9.25296249e+01, 2.55508865e+02, 9.33218460e+01, 2.80282867e+02,
       9.40617599e+01, 3.04524017e+02, 9.47729187e+01, 3.28398773e+02,
       9.55032883e+01, 3.52518188e+02, 9.62139130e+01, 3.76458038e+02,
       9.67007065e+01, 4.00103729e+02, 9.74100418e+01, 2.06195312e+02,
       1.16716141e+02, 2.30973007e+02, 1.17475555e+02, 2.55367249e+02,
       1.18369492e+02, 2.79893921e+02, 1.18996132e+02, 3.04096558e+02,
       1.19576424e+02, 3.27954865e+02, 1.20226845e+02, 3.51706360e+02,
       1.20701988e+02, 3.75493530e+02, 1.21448166e+02, 3.99057404e+02,
       1.21822800e+02, 2.05434128e+02, 1.40145966e+02, 2.29654892e+02,
       1.40661072e+02, 2.54194305e+02, 1.41190430e+02, 2.78187866e+02,
       1.41671646e+02, 3.02439453e+02, 1.41921768e+02, 3.25743896e+02,
       1.42481598e+02, 3.49745117e+02, 1.42737350e+02, 3.73090546e+02,
       1.43214966e+02, 3.96473694e+02, 1.43490128e+02, 2.04188522e+02,
       1.64679840e+02, 2.28743927e+02, 1.65210205e+02, 2.52887238e+02,
       1.65589737e+02, 2.77306885e+02, 1.65986359e+02, 3.01095825e+02,
       1.66369583e+02, 3.24814880e+02, 1.66734482e+02, 3.48388519e+02,
       1.67056931e+02, 3.71899536e+02, 1.67451706e+02, 3.95058990e+02,
       1.67677536e+02, 2.04287994e+02, 1.88862686e+02, 2.28562653e+02,
       1.89262177e+02, 2.52768768e+02, 1.89538422e+02, 2.76830811e+02,
       1.89781418e+02, 3.00664490e+02, 1.90158493e+02, 3.24125214e+02,
       1.90396774e+02, 3.47677765e+02, 1.90687576e+02, 3.70964691e+02,
       1.90903015e+02, 3.94165466e+02, 1.91237549e+02, 2.04209732e+02,
       2.12796066e+02, 2.28568100e+02, 2.13067932e+02, 2.52437897e+02,
       2.13297867e+02, 2.76529633e+02, 2.13476059e+02, 3.00152161e+02,
       2.13661072e+02, 3.23559784e+02, 2.13897888e+02, 3.46919342e+02,
       2.14110443e+02, 3.70193329e+02, 2.14359909e+02, 3.93251862e+02,
       2.14515961e+02, 2.06258011e+02, 8.87902374e+01, 2.31023712e+02,
       8.86628113e+01, 2.55580566e+02, 8.85515289e+01, 2.80434052e+02,
       8.83947525e+01, 3.04672760e+02, 8.82387772e+01, 3.28637787e+02,
       8.79228592e+01, 3.53054291e+02, 8.76994781e+01, 3.76950256e+02,
       8.74506226e+01, 4.00688538e+02, 8.72152023e+01, 2.07350998e+02,
       1.14136406e+02, 2.32051407e+02, 1.13939034e+02, 2.56399200e+02,
       1.13705719e+02, 2.81077484e+02, 1.13540634e+02, 3.05148834e+02,
       1.13299080e+02, 3.29283539e+02, 1.12949532e+02, 3.53291412e+02,
       1.12603073e+02, 3.77068176e+02, 1.12311203e+02, 4.00563690e+02,
       1.11727249e+02, 2.08471405e+02, 1.39084534e+02, 2.32757492e+02,
       1.38787750e+02, 2.57372162e+02, 1.38531052e+02, 2.81526611e+02,
       1.38223816e+02, 3.05555176e+02, 1.37736237e+02, 3.29494720e+02,
       1.37419449e+02, 3.53485291e+02, 1.37105225e+02, 3.77064697e+02,
       1.36674728e+02, 4.00537781e+02, 1.36359955e+02, 2.09365982e+02,
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
