finger563/agse2015/code/agse_rosmod_project/01-Software-Configuration/agse/src/agse_package/src/agse_package/servos_main.cpp

#include "ros/ros.h"
#include <cstdlib>
#include <string.h>

// Required for boost::thread
#include <boost/thread.hpp>

// Include all components this actor requires
#include "agse_package/servo_controller.hpp" 


void componentThread(Component* compPtr)
{
    compPtr->startUp();
    compPtr->processQueue();
}

int main(int argc, char **argv)
{
    std::string nodeName = "servos";
    std::string hostName = "localhost";

    for(int i = 0; i < argc; i++)
    {
        if(!strcmp(argv[i], "-nodename"))
            nodeName = argv[i+1];
	if(!strcmp(argv[i], "-hostname"))
	    hostName = argv[i+1];
    }

    ros::init(argc, argv, nodeName.c_str());

    // Create Node Handle
    ros::NodeHandle n;

    // Create Component Objects
    servo_controller servo_controller_i(hostName, nodeName, "servo_controller_i", argc, argv); 

    // Create Component Threads
    boost::thread servo_controller_i_thread(componentThread, &servo_controller_i);
    ROS_INFO("Node servos has started servo_controller_i");


    ROS_INFO_STREAM("NodeMain thread id = " << boost::this_thread::get_id());

    // Create Component Threads
    servo_controller_i_thread.join();


    return 0; 
}
