finger563/agse2015/code/agse_rosmod_project/01-Software-Configuration/agse/src/agse_package/src/agse_package/servo_controller.cpp

#include "agse_package/servo_controller.hpp"

//# Start User Globals Marker
#include <stdlib.h>
//# End User Globals Marker

// -------------------------------------------------------
// BUSINESS LOGIC OF THESE FUNCTIONS SUPPLIED BY DEVELOPER
// -------------------------------------------------------

// Init Function
//# Start Init Marker
void servo_controller::Init(const ros::TimerEvent& event)
{
    // Initialize Component
  paused = true;
  sprintf(portName,"//dev//ttyO5");
  armServoID = 10;
  gripperRotationID = 11;
  gripperPositionID = 1;

  armServoSpeed = 20; // half speed; full speed is either 0 or 1023
  gripperRotationSpeed = 0;
  gripperPositionSpeed = 0;

  complianceMargin = 90;
  complianceSlope = 5;

  int iGain = 8;

  if (serialPort.connect(portName,9600)!=0)
    {
      int pos;
      // ARM SERVO 
      pos = dynamixel.getPosition(&serialPort, armServoID);
      //      ROS_INFO("Arm base servo angle: %f\n",Dynamixel::posToAngle(pos));
      armRotationGoal = Dynamixel::posToAngle_28T(pos);

      // GRIPPER ROTATION SERVO
      pos = dynamixel.getPosition(&serialPort, gripperRotationID);
      //      ROS_INFO("Gripper rotation servo angle: %f\n",Dynamixel::posToAngle(pos));
      gripperRotationGoal = Dynamixel::posToAngle(pos);
    
      // GRIPPER POSITION SERVO
      pos = dynamixel.getPosition(&serialPort, gripperPositionID);
      //      ROS_INFO("Gripper position servo angle: %f\n",Dynamixel::posToAngle(pos));
      gripperPosGoal = Dynamixel::posToAngle(pos);

      // Command line args for servo control
      for (int i = 0; i < node_argc; i++) 
	{
	  if (!strcmp(node_argv[i], "-unpaused"))
	    paused = false;
	  else if (!strcmp(node_argv[i], "-theta"))
	    armRotationGoal = atof(node_argv[i+1]);
	  else if (!strcmp(node_argv[i], "-gRot"))
	    gripperRotationGoal = atof(node_argv[i+1]);
	  else if (!strcmp(node_argv[i], "-gPos"))
	    gripperPosGoal = atof(node_argv[i+1]);
	  else if (!strcmp(node_argv[i], "-armSpeed"))
	    armServoSpeed = atoi(node_argv[i+1]);
	  else if (!strcmp(node_argv[i], "-margin"))
	    complianceMargin  = atoi(node_argv[i+1]);
	  else if (!strcmp(node_argv[i], "-slope"))
	    complianceSlope = atoi(node_argv[i+1]);
	  else if (!strcmp(node_argv[i], "-gRotSpeed"))
	    gripperRotationSpeed = atoi(node_argv[i+1]);
	  else if (!strcmp(node_argv[i], "-gPosSpeed"))
	    gripperPositionSpeed = atoi(node_argv[i+1]);
	  else if (!strcmp(node_argv[i], "-iGain"))
	    iGain = atoi(node_argv[i+1]);
	}

      //dynamixel.setSpeed(&serialPort, armServoID, armServoSpeed);
      //dynamixel.setSpeed(&serialPort, gripperRotationID, gripperRotationSpeed);
      //dynamixel.setSpeed(&serialPort, gripperPositionID, gripperPositionSpeed);

      // Setting a compliance margin
      // Min: 0; Max: 254
      // for MX28T the CWComplianceMargin is the D gain
      dynamixel.setCWComplianceMargin(&serialPort, armServoID, complianceMargin);
      dynamixel.setCCWComplianceMargin(&serialPort, armServoID, iGain);
      dynamixel.setCWAngleLimit(&serialPort, armServoID, 1);
      dynamixel.setCCWAngleLimit(&serialPort, armServoID, 4095);
      //dynamixel.setCCWComplianceMargin(&serialPort, armServoID, complianceMargin);
      //dynamixel.setCWComplianceMargin(&serialPort, gripperRotationID, complianceMargin);
      //dynamixel.setCCWComplianceMargin(&serialPort, gripperRotationID, complianceMargin);
      //dynamixel.setCWComplianceMargin(&serialPort, gripperPositionID, complianceMargin);
      //dynamixel.setCCWComplianceMargin(&serialPort, gripperPositionID, complianceMargin);

      //dynamixel.setCWComplianceSlope(&serialPort, armServoID, complianceSlope);
      //dynamixel.setCCWComplianceSlope(&serialPort, armServoID, complianceSlope);
    }
  else
    {
      ROS_INFO ("Can't open serial port %s", portName);
    }  
    // Stop Init Timer
    initOneShotTimer.stop();
}
//# End Init Marker

// OnOneData Subscription handler for controlInputs_sub subscriber
//# Start controlInputs_sub_OnOneData Marker
void servo_controller::controlInputs_sub_OnOneData(const agse_package::controlInputs::ConstPtr& received_data)
{
    // Business Logic for controlInputs_sub subscriber subscribing to topic controlInputs callback 
  paused = received_data->paused;
}
//# End controlInputs_sub_OnOneData Marker

// Component Service Callback
//# Start armRotationCallback Marker
bool servo_controller::armRotationCallback(agse_package::armRotation::Request  &req,
    agse_package::armRotation::Response &res)
{
    // Business Logic for armRotation_server Server providing armRotation Service
  if (req.update == true)
    {
      armRotationGoal = req.goal;
    }
  res.current = armRotationCurrent;
  return true;
}
//# End armRotationCallback Marker
// Component Service Callback
//# Start gripperPosCallback Marker
bool servo_controller::gripperPosCallback(agse_package::gripperPos::Request  &req,
    agse_package::gripperPos::Response &res)
{
    // Business Logic for gripperPos_server Server providing gripperPos Service
  if (req.update == true)
    {
      gripperPosGoal = req.goal;
    }
  res.current = gripperPosCurrent;
  return true;
}
//# End gripperPosCallback Marker
// Component Service Callback
//# Start gripperRotationCallback Marker
bool servo_controller::gripperRotationCallback(agse_package::gripperRotation::Request  &req,
    agse_package::gripperRotation::Response &res)
{
    // Business Logic for gripperRotation_server Server providing gripperRotation Service
  if (req.update == true)
    {
      gripperRotationGoal = req.goal;
    }
  res.current = gripperRotationCurrent;
  return true;
}
//# End gripperRotationCallback Marker

// Callback for servoTimer timer
//# Start servoTimerCallback Marker
void servo_controller::servoTimerCallback(const ros::TimerEvent& event)
{
    // Business Logic for servoTimer 
  if (!paused) 
    {

      int pos; // temp value to store position from servo
    
      // ARM SERVO 
      dynamixel.setPosition(&serialPort, armServoID, Dynamixel::angleToPos_28T(armRotationGoal));
      pos = dynamixel.getPosition(&serialPort, armServoID);
      //      ROS_INFO("Arm base servo angle: %f\n",Dynamixel::posToAngle(pos));
      armRotationCurrent = Dynamixel::posToAngle_28T(pos);

      // GRIPPER ROTATION SERVO
      dynamixel.setPosition(&serialPort, gripperRotationID, Dynamixel::angleToPos(gripperRotationGoal));
      pos = dynamixel.getPosition(&serialPort, gripperRotationID);
      //      ROS_INFO("Gripper rotation servo angle: %f\n",Dynamixel::posToAngle(pos));
      gripperRotationCurrent = Dynamixel::posToAngle(pos);
    
      // GRIPPER POSITION SERVO
      dynamixel.setPosition(&serialPort, gripperPositionID, Dynamixel::angleToPos(gripperPosGoal));
      pos = dynamixel.getPosition(&serialPort, gripperPositionID);
      //      ROS_INFO("Gripper position servo angle: %f\n",Dynamixel::posToAngle(pos));
      gripperPosCurrent = Dynamixel::posToAngle(pos);
    }
  else 
    {
      int pos; // temp value to store position from servo
    
      // ARM SERVO 
      pos = dynamixel.getPosition(&serialPort, armServoID);
      //      ROS_INFO("Arm base servo angle: %f\n",Dynamixel::posToAngle(pos));
      armRotationCurrent = Dynamixel::posToAngle_28T(pos);

      // GRIPPER ROTATION SERVO
      pos = dynamixel.getPosition(&serialPort, gripperRotationID);
      //      ROS_INFO("Gripper rotation servo angle: %f\n",Dynamixel::posToAngle(pos));
      gripperRotationCurrent = Dynamixel::posToAngle(pos);
    
      // GRIPPER POSITION SERVO
      pos = dynamixel.getPosition(&serialPort, gripperPositionID);
      //      ROS_INFO("Gripper position servo angle: %f\n",Dynamixel::posToAngle(pos));
      gripperPosCurrent = Dynamixel::posToAngle(pos);
    }
}
//# End servoTimerCallback Marker

// ---------------------------------------------
// EVERYTHING BELOW HERE IS COMPLETELY GENERATED
// ---------------------------------------------

// Destructor - required for clean shutdown when process is killed
servo_controller::~servo_controller()
{
    servoTimer.stop();
    controlInputs_sub.shutdown();
    armRotation_server.shutdown();
    gripperPos_server.shutdown();
    gripperRotation_server.shutdown();
//# Start Destructor Marker

//# End Destructor Marker
}

void servo_controller::startUp()
{
    ros::NodeHandle nh;

    // Need to read in and parse the group configuration xml if it exists
    GroupXMLParser groupParser;
    std::map<std::string,std::string> *portGroupMap = NULL;
    std::string configFileName = nodeName + "." + compName + ".xml";
    if (groupParser.Parse(configFileName))
    {
	portGroupMap = &groupParser.portGroupMap;
    }

    std::string advertiseName;

    // Configure all subscribers associated with this component
    // subscriber: controlInputs_sub
    advertiseName = "controlInputs";
    if ( portGroupMap != NULL && portGroupMap->find("controlInputs_sub") != portGroupMap->end() )
        advertiseName += "_" + (*portGroupMap)["controlInputs_sub"];
    ros::SubscribeOptions controlInputs_sub_options;
    controlInputs_sub_options = 
	ros::SubscribeOptions::create<agse_package::controlInputs>
	    (advertiseName.c_str(),
	     1000,
	     boost::bind(&servo_controller::controlInputs_sub_OnOneData, this, _1),
	     ros::VoidPtr(),
             &this->compQueue);
    this->controlInputs_sub = nh.subscribe(controlInputs_sub_options);

    // Configure all provided services associated with this component
    // server: armRotation_server
    advertiseName = "armRotation";
    if ( portGroupMap != NULL && portGroupMap->find("armRotation_server") != portGroupMap->end() )
        advertiseName += "_" + (*portGroupMap)["armRotation_server"];
    ros::AdvertiseServiceOptions armRotation_server_options;
    armRotation_server_options = 
	ros::AdvertiseServiceOptions::create<agse_package::armRotation>
	    (advertiseName.c_str(),
             boost::bind(&servo_controller::armRotationCallback, this, _1, _2),
	     ros::VoidPtr(),
             &this->compQueue);
    this->armRotation_server = nh.advertiseService(armRotation_server_options);
    // server: gripperPos_server
    advertiseName = "gripperPos";
    if ( portGroupMap != NULL && portGroupMap->find("gripperPos_server") != portGroupMap->end() )
        advertiseName += "_" + (*portGroupMap)["gripperPos_server"];
    ros::AdvertiseServiceOptions gripperPos_server_options;
    gripperPos_server_options = 
	ros::AdvertiseServiceOptions::create<agse_package::gripperPos>
	    (advertiseName.c_str(),
             boost::bind(&servo_controller::gripperPosCallback, this, _1, _2),
	     ros::VoidPtr(),
             &this->compQueue);
    this->gripperPos_server = nh.advertiseService(gripperPos_server_options);
    // server: gripperRotation_server
    advertiseName = "gripperRotation";
    if ( portGroupMap != NULL && portGroupMap->find("gripperRotation_server") != portGroupMap->end() )
        advertiseName += "_" + (*portGroupMap)["gripperRotation_server"];
    ros::AdvertiseServiceOptions gripperRotation_server_options;
    gripperRotation_server_options = 
	ros::AdvertiseServiceOptions::create<agse_package::gripperRotation>
	    (advertiseName.c_str(),
             boost::bind(&servo_controller::gripperRotationCallback, this, _1, _2),
	     ros::VoidPtr(),
             &this->compQueue);
    this->gripperRotation_server = nh.advertiseService(gripperRotation_server_options);
 
    // Create Init Timer
    ros::TimerOptions timer_options;
    timer_options = 
	ros::TimerOptions
	    (ros::Duration(-1),
	     boost::bind(&servo_controller::Init, this, _1),
	     &this->compQueue,
             true);
    this->initOneShotTimer = nh.createTimer(timer_options);  
  
    // Create all component timers
    // timer: timer.properties["name"]
    timer_options = 
	ros::TimerOptions
             (ros::Duration(1.0),
	     boost::bind(&servo_controller::servoTimerCallback, this, _1),
	     &this->compQueue);
    this->servoTimer = nh.createTimer(timer_options);


    /*
     * Identify present working directory of node executable
     */
    std::string s = node_argv[0];
    std::string exec_path = s;
    std::string delimiter = "/";
    std::string exec, pwd;
    size_t pos = 0;
    while ((pos = s.find(delimiter)) != std::string::npos) {
        exec = s.substr(0, pos);
        s.erase(0, pos + delimiter.length());
    }
    exec = s.substr(0, pos);
    pwd = exec_path.erase(exec_path.find(exec), exec.length());
    // Establish the log file name
    std::string log_file_path = pwd + nodeName + "." + compName + ".log"; 

    // Create the log file & open file stream
    LOGGER.CREATE_FILE(log_file_path);

    // Establish log levels of LOGGER
    LOGGER.SET_LOG_LEVELS(groupParser.logging);
}
