finger563/agse2015/references/markerDetection/camera3.yml

%YAML:1.0
calibration_time: "Fri 03 Apr 2015 03:16:02 PM CDT"
image_width: 640
image_height: 480
board_width: 9
board_height: 6
square_size: 1.
flags: 0
camera_matrix: !!opencv-matrix
   rows: 3
   cols: 3
   dt: d
   data: [ 6.8100500770777353e+02, 0., 2.9320751330011490e+02, 0.,
       6.8259241406747412e+02, 2.8669830989372991e+02, 0., 0., 1. ]
distortion_coefficients: !!opencv-matrix
   rows: 5
   cols: 1
   dt: d
   data: [ 4.9533316988786574e-01, -5.8337702568642484e+00,
       4.0977255404022278e-02, -2.6188875594969949e-02,
       2.8636209168277045e+01 ]
avg_reprojection_error: 1.8720815441880410e+00
image_points: !!opencv-matrix
   rows: 10
   cols: 54
   dt: "2f"
   data: [ 1.37765823e+02, 1.01451706e+02, 1.77191147e+02,
       1.04758873e+02, 2.13883453e+02, 1.07901756e+02, 2.48567352e+02,
       1.10840858e+02, 2.80785156e+02, 1.13558220e+02, 3.10713684e+02,
       1.15983513e+02, 3.39283783e+02, 1.18372581e+02, 3.65724518e+02,
       1.20339539e+02, 3.91099854e+02, 1.22442627e+02, 1.39663239e+02,
       1.41480301e+02, 1.78953796e+02, 1.43330795e+02, 2.15570297e+02,
       1.45207626e+02, 2.50321976e+02, 1.46697189e+02, 2.82224121e+02,
       1.48257217e+02, 3.12401825e+02, 1.49514221e+02, 3.40469727e+02,
       1.50792603e+02, 3.66879517e+02, 1.52029068e+02, 3.91978424e+02,
       1.53093338e+02, 1.41416534e+02, 1.82025299e+02, 1.79878860e+02,
       1.82569672e+02, 2.16437744e+02, 1.83001389e+02, 2.50542038e+02,
       1.83369385e+02, 2.82387177e+02, 1.83620453e+02, 3.12235779e+02,
       1.83878510e+02, 3.40439972e+02, 1.84200974e+02, 3.66883026e+02,
       1.84368393e+02, 3.91953583e+02, 1.84545319e+02, 1.42114563e+02,
       2.22312027e+02, 1.80788895e+02, 2.21336044e+02, 2.16983597e+02,
       2.20546097e+02, 2.51398026e+02, 2.19577621e+02, 2.82781097e+02,
       2.18689575e+02, 3.12608368e+02, 2.18037354e+02, 3.40491577e+02,
       2.17381393e+02, 3.67197205e+02, 2.16549820e+02, 3.92066223e+02,
       2.15824493e+02, 1.42898300e+02, 2.62043365e+02, 1.81505219e+02,
       2.59601288e+02, 2.17721008e+02, 2.57564453e+02, 2.51586700e+02,
       2.55471619e+02, 2.83139618e+02, 2.53403824e+02, 3.12617157e+02,
       2.51688004e+02, 3.40624908e+02, 2.50068207e+02, 3.67160004e+02,
       2.48388519e+02, 3.92190643e+02, 2.47001663e+02, 1.43481079e+02,
       3.00664246e+02, 1.82114227e+02, 2.96845795e+02, 2.18081848e+02,
       2.93512726e+02, 2.51996277e+02, 2.90332733e+02, 2.83532074e+02,
       2.87301758e+02, 3.12958008e+02, 2.84491364e+02, 3.41120026e+02,
       2.81799164e+02, 3.67471252e+02, 2.79317841e+02, 3.92445496e+02,
       2.77016144e+02, 2.08460312e+02, 1.56461197e+02, 2.41946136e+02,
       1.56687225e+02, 2.75159668e+02, 1.56844406e+02, 3.08047577e+02,
       1.56979736e+02, 3.40454559e+02, 1.57109818e+02, 3.72258362e+02,
       1.57093887e+02, 4.04029663e+02, 1.57228439e+02, 4.35341248e+02,
       1.57218063e+02, 4.66474762e+02, 1.57222504e+02, 2.08899155e+02,
       1.90066635e+02, 2.42530609e+02, 1.90047989e+02, 2.75472260e+02,
       1.89975113e+02, 3.08420013e+02, 1.89872421e+02, 3.40564728e+02,
       1.89728363e+02, 3.72461945e+02, 1.89661911e+02, 4.04139343e+02,
       1.89512741e+02, 4.35454132e+02, 1.89422150e+02, 4.66478424e+02,
       1.89274323e+02, 2.09455032e+02, 2.23582550e+02, 2.42896576e+02,
       2.23373810e+02, 2.75899048e+02, 2.23023926e+02, 3.08649414e+02,
       2.22681198e+02, 3.40917328e+02, 2.22429596e+02, 3.72538086e+02,
       2.22121033e+02, 4.04313904e+02, 2.21725098e+02, 4.35516296e+02,
       2.21469696e+02, 4.66582581e+02, 2.21275391e+02, 2.09872131e+02,
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
