finger563/agse2015/code/agse_rosmod_project/01-Software-Configuration/agse/src/agse_package/src/agse_package/user_input_controller.cpp

#include "agse_package/user_input_controller.hpp"

//# Start User Globals Marker
//# End User Globals Marker

// -------------------------------------------------------
// BUSINESS LOGIC OF THESE FUNCTIONS SUPPLIED BY DEVELOPER
// -------------------------------------------------------

// Init Function
//# Start Init Marker
void user_input_controller::Init(const ros::TimerEvent& event)
{
    // Initialize Component
  paused = false;
  halted = false;
  manual = false;
  
  noGPIO = false;

  // Command line args for radial goal
  for (int i = 0; i < node_argc; i++)
    {
      if (!strcmp(node_argv[i], "-noGPIO"))
	{
	  noGPIO = true;
	}
    }

  if (noGPIO == false) {

    //////////////////////////////////////////////
    // UIP SWITCHES
    //////////////////////////////////////////////

    // PAUSE Switch - Amber
    pauseSwitchPin = 27; // P8_17
    gpio_export(pauseSwitchPin);
    gpio_set_dir(pauseSwitchPin,INPUT_PIN);

    // MANUAL Switch - Blue
    manualSwitchPin = 22; // P8_19
    gpio_export(manualSwitchPin);
    gpio_set_dir(manualSwitchPin,INPUT_PIN);

    // HALT Switch - Red
    haltSwitchPin = 65; // P8_18
    gpio_export(haltSwitchPin);
    gpio_set_dir(haltSwitchPin,INPUT_PIN);

    //////////////////////////////////////////////
    // UIP LEDS
    //////////////////////////////////////////////

    // PAUSE MAIN LED 
    pauseLED = 37; // P8_22 - Amber
    gpio_export(pauseLED);
    gpio_set_dir(pauseLED, OUTPUT_PIN);
    pauseLEDBlinkDelay = 5;

    // ALARM MAIN LED
    alarmLED = 66; // P8_07 - Red
    gpio_export(alarmLED);
    gpio_set_dir(alarmLED, OUTPUT_PIN);  

    // INIT MAIN LED
    initLED[0] = 45; // P8_11 - Blue
    initLED[1] = 44; // P8_12 - Green
    initLED[2] = 23; // P8_13 - Red
    gpio_export(initLED[0]);
    gpio_set_dir(initLED[0], OUTPUT_PIN);  
    gpio_export(initLED[1]);
    gpio_set_dir(initLED[1], OUTPUT_PIN);  
    gpio_export(initLED[2]);
    gpio_set_dir(initLED[2], OUTPUT_PIN);  

    gpio_set_value(initLED[0], HIGH);

    // SAMPLE MAIN LED
    sampleLED[0] = 26; // P8_14 - Blue
    sampleLED[1] = 47; // P8_15 - Green
    sampleLED[2] = 46; // P8_16 - Red
    gpio_export(sampleLED[0]);
    gpio_set_dir(sampleLED[0], OUTPUT_PIN);  
    gpio_export(sampleLED[1]);
    gpio_set_dir(sampleLED[1], OUTPUT_PIN);  
    gpio_export(sampleLED[2]);
    gpio_set_dir(sampleLED[2], OUTPUT_PIN);  
    sampleLEDBlinkDelay = 5;

    // BAY MAIN LED
    bayLED[0] = 67; // P8_08 - Blue
    bayLED[1] = 69; // P8_09 - Green
    bayLED[2] = 68; // P8_10 - Red
    gpio_export(bayLED[0]);
    gpio_set_dir(bayLED[0], OUTPUT_PIN);  
    gpio_export(bayLED[1]);
    gpio_set_dir(bayLED[1], OUTPUT_PIN);  
    gpio_export(bayLED[2]);
    gpio_set_dir(bayLED[2], OUTPUT_PIN);  
    bayLEDBlinkDelay = 5;
  }
  // Stop Init Timer
  initOneShotTimer.stop();
}
//# End Init Marker

// OnOneData Subscription handler for sampleState_sub subscriber
//# Start sampleState_sub_OnOneData Marker
void user_input_controller::sampleState_sub_OnOneData(const agse_package::sampleState::ConstPtr& received_data)
{
    // Business Logic for sampleState_sub subscriber subscribing to topic sampleState callback 
  sample.pos = received_data->pos;
  sample.orientation = received_data->orientation;
}
//# End sampleState_sub_OnOneData Marker
// OnOneData Subscription handler for payloadBayState_sub subscriber
//# Start payloadBayState_sub_OnOneData Marker
void user_input_controller::payloadBayState_sub_OnOneData(const agse_package::payloadBayState::ConstPtr& received_data)
{
    // Business Logic for payloadBayState_sub subscriber subscribing to topic payloadBayState callback 
  payloadBay.pos = received_data->pos;
  payloadBay.orientation = received_data->orientation;
}
//# End payloadBayState_sub_OnOneData Marker
// OnOneData Subscription handler for armState_sub subscriber
//# Start armState_sub_OnOneData Marker
void user_input_controller::armState_sub_OnOneData(const agse_package::armState::ConstPtr& received_data)
{
    // Business Logic for armState_sub subscriber subscribing to topic armState callback 
  arm.state = received_data->state;
}
//# End armState_sub_OnOneData Marker

// Callback for userInputTimer timer
//# Start userInputTimerCallback Marker
void user_input_controller::userInputTimerCallback(const ros::TimerEvent& event)
{

  if (noGPIO == false) {

    // Business Logic for userInputTimer
    // HANDLE MISSILE SWITCHES HERE
    unsigned int previousSwitchState = pauseSwitchState;
    gpio_get_value(pauseSwitchPin, &pauseSwitchState);
    //  ROS_INFO("Pause Switch State: %d", pauseSwitchState);

    agse_package::controlInputs control;
  
    if ( previousSwitchState != pauseSwitchState )
      {
	paused = (pauseSwitchState == HIGH) ? true : false;
	if (paused) {
	  ROS_INFO("Pausing the system!");
	}
	else {
	  ROS_INFO("Unpausing the system!");
	}
      }
    previousSwitchState = haltSwitchState;
    gpio_get_value(haltSwitchPin, &haltSwitchState);
    if ( previousSwitchState != haltSwitchState )
      {
	halted = (haltSwitchState == HIGH) ? true : false;
	if (halted) {
	  ROS_INFO("Halting the system!");
	}
	else {
	  ROS_INFO("Un-halting the system!");
	}
      }
    previousSwitchState = manualSwitchState;
    gpio_get_value(manualSwitchPin, &manualSwitchState);
    if ( previousSwitchState != manualSwitchState )
      {
	manual= (manualSwitchState == HIGH) ? true : false;
	if (manual) {
	  ROS_INFO("Switching the system to manual!");
	}
	else {
	  ROS_INFO("Switching the system to automatic!");
	}
      }
    control.paused = paused;
    control.stop = halted;
    control.manual = manual;
    controlInputs_pub.publish(control);

    // HANDLE LED OUTPUTS HERE
    static int currentPauseLEDBlinkDelay = 0;
    static int currentSampleLEDBlinkDelay = 0;
    static int currentBayLEDBlinkDelay = 0;

    if (paused)
      {
	gpio_set_value(pauseLED, HIGH);
      }
    else
      {
	if (currentPauseLEDBlinkDelay++ < pauseLEDBlinkDelay)
	  gpio_set_value(pauseLED,LOW);
	else
	  {
	    gpio_set_value(pauseLED,HIGH);
	    currentPauseLEDBlinkDelay = 0;
	  }
      }

    if (halted) {
      gpio_set_value(alarmLED, HIGH);
    }
    else {
      gpio_set_value(alarmLED, LOW);
    }

    switch (arm.state) {
    case 0:
      // INIT
      gpio_set_value(initLED[0], HIGH);
      break;
    case 1:
      // OPENING_PB
      gpio_set_value(initLED[0], LOW); // Switch OFF Blue
      gpio_set_value(initLED[1], HIGH); // Switch ON Green
      gpio_set_value(bayLED[0], LOW); // Switch OFF Blue
      //    gpio_set_value(bayLED[1], HIGH); // Switch ON Green    
      break;
    case 2:
      // FINDING_SAMPLE
      gpio_set_value(sampleLED[0], HIGH); // Switch ON Blue
      break;
    case 3:
      // FINDING_PB
      gpio_set_value(bayLED[0], HIGH); // Blue

      // Blink Sample LED Green
      gpio_set_value(sampleLED[0], LOW); // Switch ON Blue
      if (currentSampleLEDBlinkDelay++ < sampleLEDBlinkDelay)
	gpio_set_value(sampleLED[1], LOW);
      else
	{
	  gpio_set_value(sampleLED[1], HIGH);
	  currentSampleLEDBlinkDelay = 0;
	}
      break;
    case 4:
      // GRABBING_SAMPLE
      gpio_set_value(sampleLED[0], LOW); // Switch OFF Blue
      gpio_set_value(sampleLED[1], HIGH); // Switch ON Green    

      // Blink Payload Bay LED Gree
      gpio_set_value(bayLED[0], LOW); // Switch OFF Blue
      if (currentBayLEDBlinkDelay++ < bayLEDBlinkDelay)
	gpio_set_value(bayLED[1], LOW);
      else
	{
	  gpio_set_value(bayLED[1], HIGH);
	  currentBayLEDBlinkDelay = 0;
	}
      break;
    case 5:
      gpio_set_value(bayLED[1], HIGH);
      gpio_set_value(sampleLED[1], HIGH);
      break;
    default:
      break;
    }
  }
}
//# End userInputTimerCallback Marker

// ---------------------------------------------
// EVERYTHING BELOW HERE IS COMPLETELY GENERATED
// ---------------------------------------------

// Destructor - required for clean shutdown when process is killed
user_input_controller::~user_input_controller()
{
    userInputTimer.stop();
    controlInputs_pub.shutdown();
    sampleState_sub.shutdown();
    payloadBayState_sub.shutdown();
    armState_sub.shutdown();
//# Start Destructor Marker
    if (noGPIO == false) {
      gpio_set_value(initLED[0], LOW);
      gpio_set_value(pauseLED, LOW);
    }
//# End Destructor Marker
}

void user_input_controller::startUp()
{
    ros::NodeHandle nh;

    // Need to read in and parse the group configuration xml if it exists
    GroupXMLParser groupParser;
    std::map<std::string,std::string> *portGroupMap = NULL;
    std::string configFileName = nodeName + "." + compName + ".xml";
    if (groupParser.Parse(configFileName))
    {
	portGroupMap = &groupParser.portGroupMap;
    }

    std::string advertiseName;

    // Configure all subscribers associated with this component
    // subscriber: sampleState_sub
    advertiseName = "sampleState";
    if ( portGroupMap != NULL && portGroupMap->find("sampleState_sub") != portGroupMap->end() )
        advertiseName += "_" + (*portGroupMap)["sampleState_sub"];
    ros::SubscribeOptions sampleState_sub_options;
    sampleState_sub_options = 
	ros::SubscribeOptions::create<agse_package::sampleState>
	    (advertiseName.c_str(),
	     1000,
	     boost::bind(&user_input_controller::sampleState_sub_OnOneData, this, _1),
	     ros::VoidPtr(),
             &this->compQueue);
    this->sampleState_sub = nh.subscribe(sampleState_sub_options);
    // subscriber: payloadBayState_sub
    advertiseName = "payloadBayState";
    if ( portGroupMap != NULL && portGroupMap->find("payloadBayState_sub") != portGroupMap->end() )
        advertiseName += "_" + (*portGroupMap)["payloadBayState_sub"];
    ros::SubscribeOptions payloadBayState_sub_options;
    payloadBayState_sub_options = 
	ros::SubscribeOptions::create<agse_package::payloadBayState>
	    (advertiseName.c_str(),
	     1000,
	     boost::bind(&user_input_controller::payloadBayState_sub_OnOneData, this, _1),
	     ros::VoidPtr(),
             &this->compQueue);
    this->payloadBayState_sub = nh.subscribe(payloadBayState_sub_options);
    // subscriber: armState_sub
    advertiseName = "armState";
    if ( portGroupMap != NULL && portGroupMap->find("armState_sub") != portGroupMap->end() )
        advertiseName += "_" + (*portGroupMap)["armState_sub"];
    ros::SubscribeOptions armState_sub_options;
    armState_sub_options = 
	ros::SubscribeOptions::create<agse_package::armState>
	    (advertiseName.c_str(),
	     1000,
	     boost::bind(&user_input_controller::armState_sub_OnOneData, this, _1),
	     ros::VoidPtr(),
             &this->compQueue);
    this->armState_sub = nh.subscribe(armState_sub_options);
    // Configure all publishers associated with this component
    // publisher: controlInputs_pub
    advertiseName = "controlInputs";
    if ( portGroupMap != NULL && portGroupMap->find("controlInputs_pub") != portGroupMap->end() )
        advertiseName += "_" + (*portGroupMap)["controlInputs_pub"];
    this->controlInputs_pub = nh.advertise<agse_package::controlInputs>
	(advertiseName.c_str(), 1000);	

    // Configure all required services associated with this component

    // Create Init Timer
    ros::TimerOptions timer_options;
    timer_options = 
	ros::TimerOptions
	    (ros::Duration(-1),
	     boost::bind(&user_input_controller::Init, this, _1),
	     &this->compQueue,
             true);
    this->initOneShotTimer = nh.createTimer(timer_options);  
  
    // Create all component timers
    // timer: timer.properties["name"]
    timer_options = 
	ros::TimerOptions
             (ros::Duration(0.1),
	     boost::bind(&user_input_controller::userInputTimerCallback, this, _1),
	     &this->compQueue);
    this->userInputTimer = nh.createTimer(timer_options);


    /*
     * Identify present working directory of node executable
     */
    std::string s = node_argv[0];
    std::string exec_path = s;
    std::string delimiter = "/";
    std::string exec, pwd;
    size_t pos = 0;
    while ((pos = s.find(delimiter)) != std::string::npos) {
        exec = s.substr(0, pos);
        s.erase(0, pos + delimiter.length());
    }
    exec = s.substr(0, pos);
    pwd = exec_path.erase(exec_path.find(exec), exec.length());
    // Establish the log file name
    std::string log_file_path = pwd + nodeName + "." + compName + ".log"; 

    // Create the log file & open file stream
    //    LOGGER.CREATE_FILE(log_file_path);

    // Establish log levels of LOGGER
    //    LOGGER.SET_LOG_LEVELS(groupParser.logging);
}
