finger563/agse2015/references/markerDetection/camera2.yml

%YAML:1.0
calibration_time: "Fri 03 Apr 2015 01:32:17 PM CDT"
image_width: 640
image_height: 480
board_width: 9
board_height: 6
square_size: 1.
flags: 0
camera_matrix: !!opencv-matrix
   rows: 3
   cols: 3
   dt: d
   data: [ 6.1155205538655946e+02, 0., 3.2881821043753524e+02, 0.,
       6.1283295419095612e+02, 2.3010984085444923e+02, 0., 0., 1. ]
distortion_coefficients: !!opencv-matrix
   rows: 5
   cols: 1
   dt: d
   data: [ 7.9121070722710685e-02, 8.9727781922597560e-02,
       -6.4633286080963386e-04, -6.8987140205978141e-04,
       -8.4346552936971331e-01 ]
avg_reprojection_error: 3.4116766519053837e-01
image_points: !!opencv-matrix
   rows: 10
   cols: 54
   dt: "2f"
   data: [ 2.10628540e+02, 5.37661247e+01, 2.38044250e+02,
       5.34119759e+01, 2.65453552e+02, 5.29020042e+01, 2.92950836e+02,
       5.24924622e+01, 3.20216400e+02, 5.17309456e+01, 3.47431580e+02,
       5.10495682e+01, 3.74417053e+02, 5.03827400e+01, 4.01451263e+02,
       4.96999474e+01, 4.28599915e+02, 4.90509911e+01, 2.11640228e+02,
       8.16221619e+01, 2.39144043e+02, 8.13093338e+01, 2.66454681e+02,
       8.06372604e+01, 2.93720123e+02, 8.00184174e+01, 3.21207550e+02,
       7.93469315e+01, 3.48071899e+02, 7.86588898e+01, 3.75208557e+02,
       7.79807053e+01, 4.02354858e+02, 7.72950516e+01, 4.29270813e+02,
       7.63961639e+01, 2.12428711e+02, 1.09197571e+02, 2.40212555e+02,
       1.08644531e+02, 2.67323486e+02, 1.08167145e+02, 2.94744965e+02,
       1.07566383e+02, 3.21854248e+02, 1.06863853e+02, 3.48643402e+02,
       1.06237617e+02, 3.75830811e+02, 1.05373756e+02, 4.02897888e+02,
       1.04639839e+02, 4.29677032e+02, 1.03829063e+02, 2.13646484e+02,
       1.36813004e+02, 2.41010849e+02, 1.36404083e+02, 2.68340118e+02,
       1.35644806e+02, 2.95617584e+02, 1.34816544e+02, 3.22558380e+02,
       1.34287308e+02, 3.49539368e+02, 1.33584305e+02, 3.76642975e+02,
       1.32747955e+02, 4.03497742e+02, 1.31863312e+02, 4.30390533e+02,
       1.31211716e+02, 2.14590927e+02, 1.64264481e+02, 2.41905258e+02,
       1.63503204e+02, 2.69273895e+02, 1.62821182e+02, 2.96459869e+02,
       1.62301041e+02, 3.23525208e+02, 1.61419830e+02, 3.50503052e+02,
       1.60566513e+02, 3.77341156e+02, 1.59869095e+02, 4.04302399e+02,
       1.59164307e+02, 4.31263397e+02, 1.58219269e+02, 2.15502747e+02,
       1.91613419e+02, 2.43011765e+02, 1.90825058e+02, 2.70012756e+02,
       1.90126251e+02, 2.97416473e+02, 1.89324646e+02, 3.24486877e+02,
       1.88619522e+02, 3.51195953e+02, 1.87690277e+02, 3.78121246e+02,
       1.86850693e+02, 4.05107391e+02, 1.86197952e+02, 4.31913757e+02,
       1.85445023e+02, 2.10631134e+02, 5.37680550e+01, 2.38039642e+02,
       5.33908081e+01, 2.65455963e+02, 5.28918533e+01, 2.92949036e+02,
       5.24824867e+01, 3.20218262e+02, 5.17300797e+01, 3.47436249e+02,
       5.09885521e+01, 3.74413300e+02, 5.03822632e+01, 4.01455139e+02,
       4.96948662e+01, 4.28607361e+02, 4.90361862e+01, 2.11631622e+02,
       8.16187057e+01, 2.39128540e+02, 8.12850113e+01, 2.66455994e+02,
       8.06315613e+01, 2.93716827e+02, 7.99866562e+01, 3.21198181e+02,
       7.93399582e+01, 3.48072937e+02, 7.86564178e+01, 3.75195770e+02,
       7.79860535e+01, 4.02368927e+02, 7.72826157e+01, 4.29263672e+02,
       7.64076843e+01, 2.12429810e+02, 1.09171959e+02, 2.40207611e+02,
       1.08645477e+02, 2.67316010e+02, 1.08158150e+02, 2.94735229e+02,
       1.07554749e+02, 3.21853973e+02, 1.06862473e+02, 3.48643646e+02,
       1.06241829e+02, 3.75821167e+02, 1.05365234e+02, 4.02883148e+02,
       1.04638947e+02, 4.29691742e+02, 1.03817596e+02, 2.13638123e+02,
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
