finger563/agse2015/references/markerDetection/camera.yml

%YAML:1.0
calibration_time: "Mon Mar  2 22:32:32 2015"
nframes: 10
image_width: 640
image_height: 480
board_width: 9
board_height: 6
square_size: 1.
flags: 0
camera_matrix: !!opencv-matrix
   rows: 3
   cols: 3
   dt: d
   data: [ 5.8502754422815985e+02, 0., 3.2447597162236769e+02, 0.,
       5.8109926033388865e+02, 2.1751890099720927e+02, 0., 0., 1. ]
distortion_coefficients: !!opencv-matrix
   rows: 5
   cols: 1
   dt: d
   data: [ 1.0117363831253516e-01, -4.0361676835485966e-01,
       -2.6626041793988598e-03, -5.3685989114722141e-03,
       6.2306572931902870e-01 ]
avg_reprojection_error: 1.2620894886113868e-01
per_view_reprojection_errors: !!opencv-matrix
   rows: 10
   cols: 1
   dt: f
   data: [ 1.08276688e-01, 1.31844610e-01, 1.36849791e-01,
       1.29710987e-01, 9.59097892e-02, 1.11559354e-01, 1.33611023e-01,
       1.44111738e-01, 1.20738141e-01, 1.40660450e-01 ]
# a set of 6-tuples (rotation vector + translation vector) for each view
extrinsic_parameters: !!opencv-matrix
   rows: 10
   cols: 6
   dt: d
   data: [ 2.2549634892467030e-02, 2.0358277063706267e-02,
       -7.4278298825420537e-03, -2.5393841578019489e+00,
       -2.8673002226598219e+00, 2.2686136734789947e+01,
       9.2951032728893958e-03, 1.6499071618487477e-02,
       -8.7425661618816645e-03, -2.8536731811028453e+00,
       -2.6004165070720182e+00, 2.2824257717930045e+01,
       -3.5945888030300709e-03, 9.0248564187128666e-04,
       -6.5790071260675856e-03, -3.1854801184758363e+00,
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
       2.01782410e+02, 3.02841217e+02, 2.01575821e+02, 3.28552185e+02,
       2.01399994e+02, 3.54329803e+02, 2.01216034e+02, 3.79939484e+02,
       2.00997055e+02, 4.05762207e+02, 2.00709595e+02, 4.31627228e+02,
       2.00543442e+02, 4.57512085e+02, 2.00362976e+02, 2.51810318e+02,
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
