finger563/agse2015/code/agse_rosmod_v3/01-Software/agse/src/motor_control/src/motor_control/Logger.cpp

#include "motor_control/Logger.hpp"

/*
 * Write remaining log contents to file
 */
Logger::~Logger() {
  if (SIZE_OF_LOG() > 0) {
    WRITE_TO_FILE();
    log_content = "";
  }
  log_stream.close();
}

/*
 * Open file outstream @ provided target path
 */
bool Logger::CREATE_FILE(string target_log_path) {
  log_path = target_log_path;
  log_stream.open(log_path, ios::out | ios::app );  
  log_content = "--------------------------------------------------------------------------------";
  return true;
}

/*
 * Write Log contents to file & close stream
 */ 
bool Logger::WRITE_TO_FILE() {
  log_stream << log_content << endl;
  return true;
}

/*
 * Check log content size 
 * If size > max_log_unit, write to file
 */
bool Logger::CHECK_LOG_SIZE() {
  if (SIZE_OF_LOG() > max_log_unit) {
    WRITE_TO_FILE();
    log_content = "";
    return true;
  }
  return false;
}

/*
 * Create a DEBUG log entry
 */
bool Logger::DEBUG(const char * format, ...) {
  if (log_levels.DEBUG == true) {
    va_list args;
    va_start (args, format);
    char log_entry[1024];
    vsprintf (log_entry, format, args);
    std::string log_entry_string(log_entry);
    va_end (args);

    bool exceeded_limit = CHECK_LOG_SIZE();
    if (exceeded_limit == true)
      log_content += "ROSMOD::DEBUG::" + CLOCK_VALUE() + "::" + log_entry_string;
    else
      log_content += "\nROSMOD::DEBUG::" + CLOCK_VALUE() + "::" + log_entry_string; 
  }
  return true;
}

/*
 * Create a INFORMATION log entry
 */
bool Logger::INFO(const char * format, ...) {
  if (log_levels.INFO == true) {
    va_list args;
    va_start (args, format);
    char log_entry[1024];
    vsprintf (log_entry, format, args);
    std::string log_entry_string(log_entry);
    va_end (args);

    bool exceeded_limit = CHECK_LOG_SIZE();
    if (exceeded_limit == true)
      log_content += "ROSMOD::INFO::" + CLOCK_VALUE() + "::" + log_entry_string;
    else
      log_content += "\nROSMOD::INFO::" + CLOCK_VALUE() + "::" + log_entry_string; 
  }
  return true;
}

/*
 * Create a WARNING log entry
 */
bool Logger::WARNING(const char * format, ...) {
  if (log_levels.WARNING == true) {
    va_list args;
    va_start (args, format);
    char log_entry[1024];
    vsprintf (log_entry, format, args);
    std::string log_entry_string(log_entry);
    va_end (args);

    bool exceeded_limit = CHECK_LOG_SIZE();
    if (exceeded_limit == true)
      log_content += "ROSMOD::WARNING::" + CLOCK_VALUE() + "::" + log_entry_string;
    else
      log_content += "\nROSMOD::WARNING::" + CLOCK_VALUE() + "::" + log_entry_string; 
  }
  return true;
}

/*
 * Create an ERROR log entry
 */
bool Logger::ERROR(const char * format, ...) {
  if (log_levels.ERROR = true) {
    va_list args;
    va_start (args, format);
    char log_entry[1024];
    vsprintf (log_entry, format, args);
    std::string log_entry_string(log_entry);
    va_end (args);

    bool exceeded_limit = CHECK_LOG_SIZE();
    if (exceeded_limit == true)
      log_content += "ROSMOD::ERROR::" + CLOCK_VALUE() + "::" + log_entry_string;
    else
      log_content += "\nROSMOD::ERROR::" + CLOCK_VALUE() + "::" + log_entry_string; 
  }
  return true;
}

/*
 * Create a CRITICAL log entry
 */
bool Logger::CRITICAL(const char * format, ...) {
  if (log_levels.CRITICAL == true) {
    va_list args;
    va_start (args, format);
    char log_entry[1024];
    vsprintf (log_entry, format, args);
    std::string log_entry_string(log_entry);
    va_end (args);

    bool exceeded_limit = CHECK_LOG_SIZE();
    if (exceeded_limit == true)
      log_content += "ROSMOD::CRITICAL::" + CLOCK_VALUE() + "::" + log_entry_string;
    else
      log_content += "\nROSMOD::CRITICAL::" + CLOCK_VALUE() + "::" + log_entry_string; 
  }
  return true;
}

/*
 * Set Log Levels 
 */
bool Logger::SET_LOG_LEVELS(Log_Levels target_log_levels) {
  log_levels.DEBUG = target_log_levels.DEBUG;
  log_levels.INFO = target_log_levels.INFO;
  log_levels.WARNING = target_log_levels.WARNING;
  log_levels.ERROR = target_log_levels.ERROR;
  log_levels.CRITICAL = target_log_levels.CRITICAL;
}

/*
 * Return size of log_content
 */
int Logger::SIZE_OF_LOG() {
  return log_content.size();
}

/*
 * Get Current Clock Value
 */
string Logger::CLOCK_VALUE() {
  stringstream clock_string;
  clock_string << clock.now().time_since_epoch().count();
  return clock_string.str();  
}
