finger563/agse2015/(commit log)

2014-11-03 Added initial sch and brd files for payload bay
    copied from default arduino mega schematic
    [PayloadBay.brd, PayloadBay.sch]
2014-11-03 updated schematics and board
    * also added backup files made by eagle to gitignore
    [PayloadBay.brd, PayloadBay.sch]
2014-11-03 updated schematic
    added subfolders and eagle project files
    [PayloadBay.brd, PayloadBay.sch]
2014-11-03 Updated payload bay schematic
    * added text, reed switch, limit switches, mosfet, and motor
    * added png version of schematic
    [PayloadBay.brd, PayloadBay.sch]
2014-11-03 fixed lack of motor control
    [PayloadBay.brd, PayloadBay.sch]
2014-11-04 started working on power requirements
    also fixed small nomenclature error in agse statechart
2014-11-05 added good reference for martian solar power
2014-11-05 draft of power requirements doc
2014-11-25 Added OpenCV-based Real-time Edge Detection
    OpenCV-based Real-time Canny Edge Detection:
    -------------------------------------------
    - Periodically fetches webcam feed
    - Applies the canny edge detector to a queried image frame
    - Displays the webcam feed and processed webcam feed in separate
    windows
    - Low and high threshold sliders that decide the inclusion or
    rejection of detected edge
    - Press Escape to quit application
2014-12-04 Added expansion pin diagram for Jetson TK1
2014-12-19 added working python code for agse servos
2014-12-19 Working Arduino Uno sample for Dynamixel XL-320
2015-01-08 added drawing w/ pinout for linear actuators
2015-01-09 Added datasheets for the To-220 parts i have.
    [jetsonToServoBuffer.sch]
2015-01-09 updated schematic for buffer between TK1 and servo
    [jetsonToServoBuffer.sch]
2015-01-12 Updated servo code to have read command (ckt doesn't allow it yet). Also randomizes LED color and position
    [jetson_dynamixel_xl320.py]
2015-01-12 updated schematic to make it simpler and still work
    [jetsonToServoBuffer.sch]
2015-01-12 added reference docs for xl320 servo
2015-01-12 fixed issue with reading; all reading must be done with ID number not broadcast ID
    [jetson_dynamixel_xl320.py]
2015-01-16 updated repo to match current impl
    added schematics and pictures
    [AGSE_Motor_Controller.brd, AGSE_Motor_Controller.sch, jetsonSerialBuffer.sch]
2015-01-16 Added code which can control the arm properly. Linear actuator, gripper rotation, and gripper actuation.
2015-01-16 added arduino code for arm control
2015-01-30 Updated model for serial thread concerns
2015-01-30 Fixed issue with building code: error with updated model
    [image_processor.cpp, radial_actuator_controller.cpp, vertical_actuator_controller.cpp]
2015-01-30 Added referencN e cS ++ A code to control GPIO pins - jetson - NSA
2015-01-31 Updated c++ code to read/write gpio pins for control of the linear actuators.
2015-02-02 Updated code to allow for proper reading and writing with our circuit. We can now read and write to the daisychained servos. Sample ROS code from the model currently sets the LEDs, sets the positions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
2015-02-02 Updated rosmod model to put all servo related objects into one component.
2015-02-05 Updated code to default to a paused state. For now, the user input controller unpauses it immediately for debugging, but it can be hooked up to a switch.
2015-02-05 Added Jetson TK1 FAQ
2015-02-05 Updated code to have better pause demonstration. Also added simple function to convert servo feedback to absolute angle.
2015-02-06 Updated code to have code preservation markers to prevent overriding when regenerating.
    [image_processor.cpp, radial_actuator_controller.cpp, servo_controller.cpp, user_input_controller.cpp]
2015-02-18 Added dts file for enabling encoder input on BBB.
2015-02-19 Updated code to fix: header declaration of eqep objects; using stdc++11/0x in catkin_make; added initialization function for header declared eqep objects.
    [radial_actuator_controller.cpp, vertical_actuator_controller.cpp]
2015-02-19 Updated code to use eQEP1 for the radial actuator encoder and eQEP2 for the vertical linear actuator encoder.
2015-02-19 Added readme for how to compile and add the device tree overlays.
2015-02-20 Added output which shows the position of the encoder as read from the eQEP.
2015-02-20 Updated to add possible power solutions
    * batteries (12V, stacked to 24V or 36V)
    * 12V DC/DC Converters
    * 5V DC/DC Converters
    [jetsonSerialBuffer.brd, powerBoM.xlsx]
2015-02-21 Fixed naming of image processor (object detection) file so that it doesn't conflict with component's file in windows git.
    [Image_Processor_Library.cpp]
2015-02-22 added more text about code generators and circuits
2015-02-22 added resettable fuses
    [powerBoM.xlsx]
2015-02-23 Updated with WiP design for main control board
    * based off BBB power cape
    * using sparkfun libraries
    * includes necessary sparkfun libraries
    [AGSE_BBB_cape.brd, AGSE_BBB_cape.sch, powerBoM.xlsx]
2015-02-23 updated schematic symbols for h-bridges
    [AGSE_BBB_cape.brd, AGSE_BBB_cape.sch]
2015-02-23 fixed mirrored parts in h-bridges.
    [AGSE_BBB_cape.brd, AGSE_BBB_cape.sch]
2015-02-24 updated schematics
    * added molex-spox 3 pin connector library (for connecting to ax12a
    servos
    * updated schematic to fix 12v rail issue
    * added datasheets
    [AGSE_BBB_cape.brd, AGSE_BBB_cape.sch]
2015-02-24 updated library to include reference to datasheet and part number
    [AGSE_BBB_cape.sch]
2015-02-24 working on board layout
    [AGSE_BBB_cape.brd, AGSE_BBB_cape.sch]
2015-02-24 changed to SMD. working on placement & routing
    [AGSE_BBB_cape.brd, AGSE_BBB_cape.sch]
2015-02-24 Working on board design, routing signals
    [AGSE_BBB_cape.brd]
2015-02-24 working on routing
    [AGSE_BBB_cape.brd, AGSE_BBB_cape.sch]
2015-02-24 working on routing the cape
    [AGSE_BBB_cape.brd, AGSE_BBB_cape.sch]
2015-02-24 routed the board. Missing the encoder connectors.
    [AGSE_BBB_cape.brd]
2015-02-24 routed the board, cleaned up the names and made ready for fab.
    also added sparkfun's DRU for checking fab-ability
    [AGSE_BBB_cape.brd, AGSE_BBB_cape.sch]
2015-02-24 updated board for proper silkscreen layers
    [AGSE_BBB_cape.brd]
2015-02-24 moved board around to make export to image easier
    added exported image of current board.
    [AGSE_BBB_cape.brd]
2015-02-24 added png for schematic and updated names.
2015-02-24 updated agse code to use the proper GPIO to control the linear actuator h bridges
2015-02-24 HEDS9140 Encoder Datasheet
2015-02-25 Added uart1 dts for enabling uart1 on BBB.
2015-02-25 added images to be placed on pcb
2015-02-25 Addded monochrome bmps of images
    and placed them on the board
    [AGSE_BBB_cape.brd]
2015-02-25 minor update to board and also added BBB library
    [AGSE_BBB_cape.brd]
2015-02-25 Working on getting servo code running on BBB.
2015-02-25 updated schematic to move tx/rx connection from UART1 to UART5
    [AGSE_BBB_cape.brd, AGSE_BBB_cape.sch]
2015-02-25 Added working uEnv which automatically configures BBB on bootup for UART5 and the two EQEPs that we need.
2015-02-26 Updated board
    * added LEDs for the four motor controls
    * moved the serial buffer closer to its new pins (closer to the ax-12a
    output)
    [AGSE_BBB_cape.brd, AGSE_BBB_cape.sch]
2015-02-26 Updated board to have molex 4-pin encoder connectors
    * also removed unneeded zips
    [AGSE_BBB_cape.brd, AGSE_BBB_cape.sch]
2015-02-26 Finalized schematic and board
    also added pngs for reference.
    [AGSE_BBB_cape.brd, AGSE_BBB_cape.sch]
2015-02-26 Updated text and positions
    [AGSE_BBB_cape.brd]
2015-02-26 KSP References for Control Board
2015-02-26 udpated board :)
    [AGSE_BBB_cape.brd]
2015-02-26 Added generated gerber files and receipt from order.
    [AGSE_BBB_cape.GBL, AGSE_BBB_cape.GBO, AGSE_BBB_cape.GBS, AGSE_BBB_cape.GTL, AGSE_BBB_cape.GTO, AGSE_BBB_cape.GTP, AGSE_BBB_cape.GTS]
2015-02-26 Updated BOM Sheet
    [BOM.xlsx]
2015-02-26 Updated BoM with resistors and other parts.
    [BOM.xlsx]
2015-02-26 Added BBB, sd card & AX12A servos
    [BOM.xlsx]
2015-02-26 Added quantity
    [BOM.xlsx]
2015-02-26 Updated the AGSE model to break camera node into an image sensor node and a detector node.
2015-02-27 Added uvc sample code for reference for grabbing an image on the BBB.
2015-02-27 fixed part number for NPN xtors
    [BOM.xlsx]
2015-02-27 Updated Image Processor Lib - Potentially broken
    [Image_Processor_Library.cpp]
2015-02-27 updated BoM with easier to obtain 374 ohm resistor
    [BOM.xlsx]
2015-02-27 Updated image processor to fetch image frame
2015-02-27 Updated image sensor to have pause functionality.
2015-02-27 fixed compile error in image sensor.
    [image_sensor.cpp]
2015-02-27 Updated to have rgb24 sample for v4l library.
2015-02-27 Updated image sensor code to use working RGB24 v4l image acquisition and transmission to the jetson.
2015-02-28 Added MBA demo sample detection screenshots
2015-02-28 Removed filter knobs and added defaault HSV values
2015-03-01 Sample Detector Fixed typo
2015-03-02 Updated arm code with high-level pseudo code and test code.
2015-03-03 Updated agse model to have payload bay detector server and clients inside image processor component and arm component.
2015-03-03 Added camera config and a sample board made up of markers
2015-03-03 updated power BoM with sourced components.
    [powerBoM.xlsx]
2015-03-04 Working on analog input for LAC-12 linear actuator feedback
2015-03-04 Updated vertical and radial actuator code to support prototype's Analog feedback.
2015-03-04 Updated actuator code to fix broken copy/paste
    [radial_actuator_controller.cpp, vertical_actuator_controller.cpp]
2015-03-04 Updating code towards final image detection code. Also removed debug setting from servo controller. Removed timer from image processor since it's not needed anymore.
2015-03-04 Updated generated code to reflect removed timer from image_processor.
2015-03-04 Updated arm controller business logic to flesh out more of the variables we need and also describe the preconditions and logic for each state.
2015-03-04 Updated detector and image processing code. Now have two objects in image_processor component: sampleDetector and payloadBayDetector
2015-03-04 updated sample detector to use the w/h input args.
2015-03-05 Fixed output image for sample detector and updated new angle code to compile.
2015-03-05 Updated sample detector
2015-03-05 Updated image sensor code to try to fix bug.
    [image_sensor.cpp]
2015-03-06 updated code to remove sample and payloadBay object inputs for detector functions. Also updated v4l code somewhat.
2015-03-06 Reverted v4l code back to original. Works better now with lessons learned from intermediary code.
    [image_sensor.cpp]
2015-03-06 Updated lots of code. Updated model to have new interfaces for image_processor servers. Also added sampleState and payloadBay state publishers and subscribers to the arm_controller and user_input_con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
2015-03-06 Added AGSE Sample Detection Test Results
2015-03-06 Updated Sample Detection Code
2015-03-06 Added area and ratio based filtering
2015-03-07 Updated marker library code to not print every detected marker.
2015-03-07 Working towards finalizing implementation of arm controller state functions.
2015-03-08 Added a find jetson script
2015-03-08 Updated model to split servo control from gpio-based arm control. This may be a fix for the issue with reading serial port data as sudo
    [positioning_main.cpp, servos_main.cpp]
2015-03-12 Added more pictures for board and schematic files
2015-03-14 cropped the board layout images
2015-03-14 added pcb comparison images
2015-03-15 Added image for use in soldering board. has values for each part.
2015-03-16 added powerpoint pranav and i made for AGSE
2015-03-17 added correct packages
    [BOM.xlsx]
2015-03-28 Updated user input control with LED GPIO pin settings
2015-03-28 Updated user input controller to periodically show 4 camera images. WOrks great
2015-03-28 Added encoder test script
2015-03-29 Added command line args to gripper control, vertical, radial & rotational arm control
2015-03-30 Added call_at_timer boolean so that InitStateFunc is called at each timer tick.
2015-03-31 Updated code with proper pin assignments. Also added command line argument parsing to vertical and radial actuators.
2015-03-31 Updated UIP code with switch pins
2015-04-01 Updated model and generated code to have captureImage_client in user input panel and to allow calibration of the linear actuator controllers.
2015-04-01 Updated code to have proper calibration routine. Also updated calibration code for linear actuator controllers. Finally; updated command line args.
2015-04-02 Updated UIP - Added button state machine
2015-04-02 Updated code with new/proper limit switch reading pins and better code to detect limit switch pressed in service callback.
2015-04-02 Updating code for more explicit behavior of state functions. Also added publishing of arm state. Also fixed the limit swtich detection in the linear actuator controllers.
    [radial_actuator_controller.cpp, vertical_actuator_controller.cpp]
2015-04-02 working on bugfix for arm controller.
2015-04-02 Updated arm code for debugging of all state functions.
2015-04-02 Updated arm code for better clarity and debugging.
2015-04-02 Updated code to use boost library. This commit can be reverted if need be.
    [servo_controller.cpp]
2015-04-02 Updated code with more correct limits for actuators.
    [image_processor.cpp]
2015-04-02 Updated searching code for new camera orientation.
2015-04-02 Added code to set speed of servos.
2015-04-02 Updated epsilons for the arm controller.
2015-04-02 Updated servo controller cmdline arguments to include compliance margins
2015-04-02 Added UIP Switch and LED pin numbers
2015-04-02 Updated UIP logic to switch on the LEDS
2015-04-03 Updated arm controller to fix search state logic. Also made it more robust hopefully.
2015-04-03 Updated arm code to have serial port code to control payload bay.
2015-04-03 Updated code to take into account offset between gripper and camera.
2015-04-03 Updated model and generated code to have publishers and subscribers to get processed images from image_processor to user input panel. Also fixed small compile warning in vertical and radial actuator 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
    [image_processor.cpp, radial_actuator_controller.cpp, user_input_controller.cpp, vertical_actuator_controller.cpp]
2015-04-03 updated arm controller to allow disabling of the serial port (for testing when it's not connected.
2015-04-03 Updated code with better arm rotation limit.
2015-04-03 updated arm code to better find sample. Also updated center epsilon for better results.
2015-04-03 Fixed bug in find sample code.
2015-04-03 Fixing logic errors in image processor to mitigate unforseen bugs.
    [image_processor.cpp]
2015-04-03 Updated camera yml
2015-04-03 Measured gripper rotation offset and added it into the code.
2015-04-03 New camera yml
2015-04-03 Fixed bug in carrying sample state.
2015-04-03 Updated code with better sample searching.
2015-04-03 Added limits for sample height etc.
2015-04-04 Updated code to remove debug output for arm to make it cleaner. Also updated offset from camera to gripper.
2015-04-04 Calibrating the camera offset to gripper.
2015-04-04 Updated code for proper pause functionality in motor controllers.
2015-04-04 Fixed serial port name for jetson.
2015-04-05 Updated code to hopefully get correct sample orientation. ALso lowered angle offset between gripper and camera.
2015-04-05 Updated code to hopefuly get proper sample orientation every time.
2015-04-05 Updated code to get proper sample orientation every time. Also committing the changes to markerdetector and payloadbay_detector.
2015-04-06 Updated Switch case for state changes
2015-04-06 Updated arm controller to support command line state control.
2015-04-07 Updated user input controller to fix pause publishing.
    [user_input_controller.cpp]
2015-04-07 Fixed missing includes and namespace for user input imager.
    [user_input_imager.cpp]
2015-04-07 Commented out debug prints
2015-04-07 Updated arm controller to have explicit enum numbering and always send serial port commands to PB.
2015-04-08 Updated code for proper blinking of LEDs where required.
2015-04-08 Updated frequency of user input controller timer. This allows exact specification for the LED blink rates.
2015-04-08 fixed state output for arm && added back state initialization.
2015-04-08 Updated UI imager timer
2015-04-08 Updated code to have proper servo slope.
2015-04-09 Updated user input imager - camera feed works now
2015-04-09 Updated code to get camera.yml from absolute path.
2015-04-09 UPdated code based on mx28t servo changes.
2015-04-09 fixed compile error in servo controller.
    [servo_controller.cpp]
2015-04-09 fixed compile error in arm contorller.
2015-04-09 updated min arm rotation to be > 0
2015-04-11 Updated Servo BBB code pushed to repo
2015-04-11 Updated Jetson TK1 AGSEcode
2015-04-11 Added cmdline arg for sample Z Plane
2015-05-13 updated to have powerpoint which describes agse.
